ConnectBox/Circuit-Design/README.md

# Circuit-Design
Connectbox Circuit Design

This repo contains the schematic and KiCAD design files for the NEO-USB-HAT.  This is a daugherboard to add an extra USB port and power input to a NanoPi NEO.
