ConnectBox/Circuit-Design/Hat_7.0.6/Flex_1.0/Flex Spec on Stackup.pdf

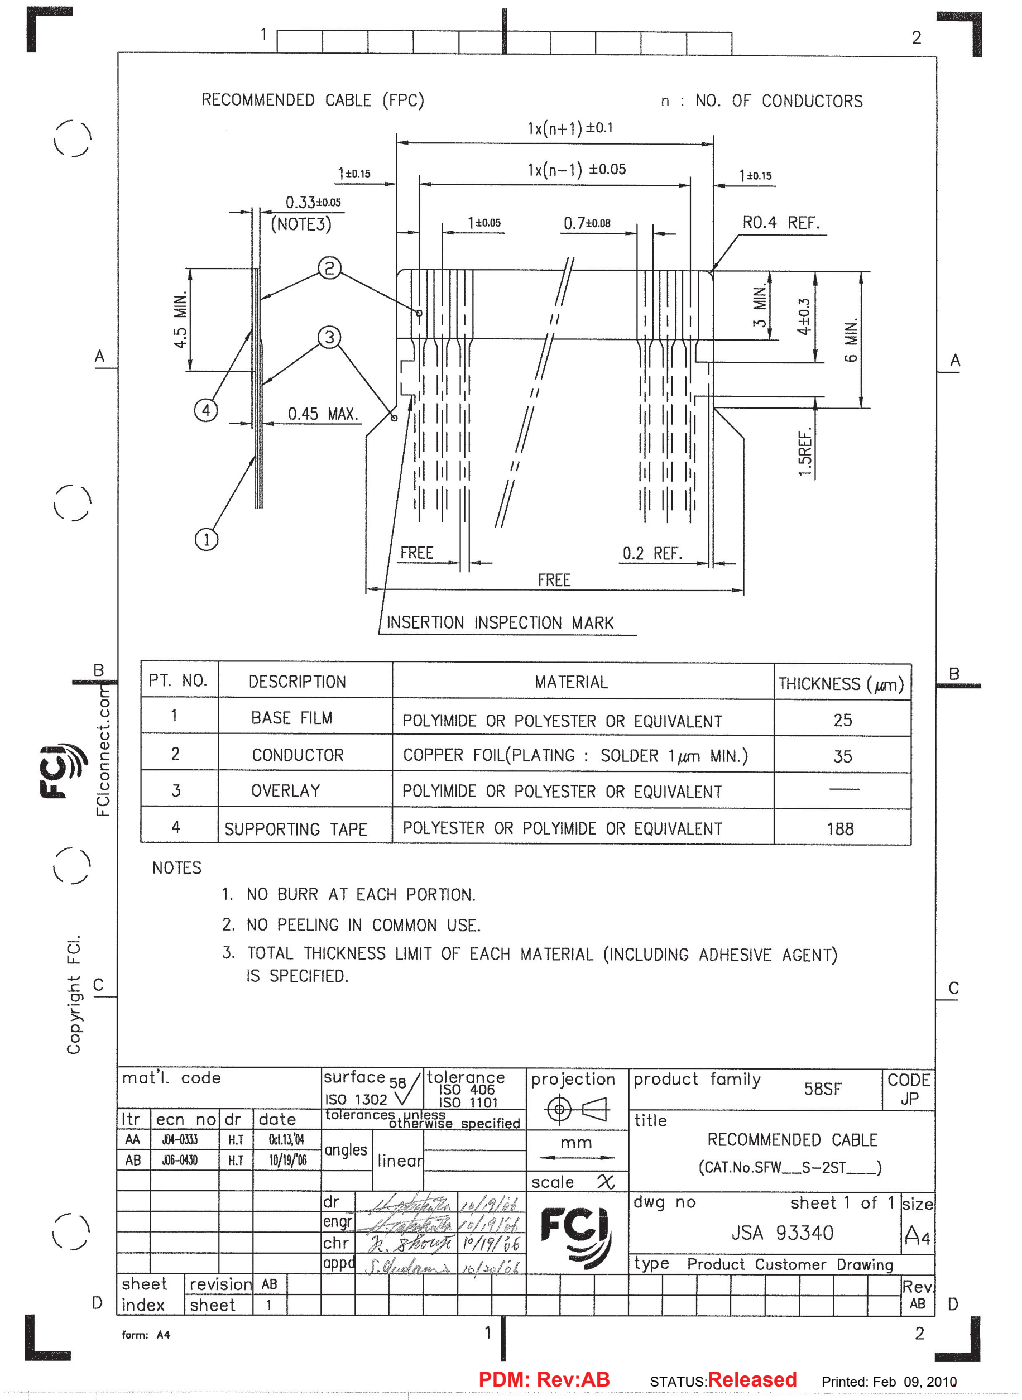
[picture p1: page 1]

PDM: Rev:AB | Released | . STATUS: | Printed: Feb 09, 2010
