ConnectBox/Circuit-Design/Hat_7.0.6/Flex_1.0/Flex Spec Drawing.pdf

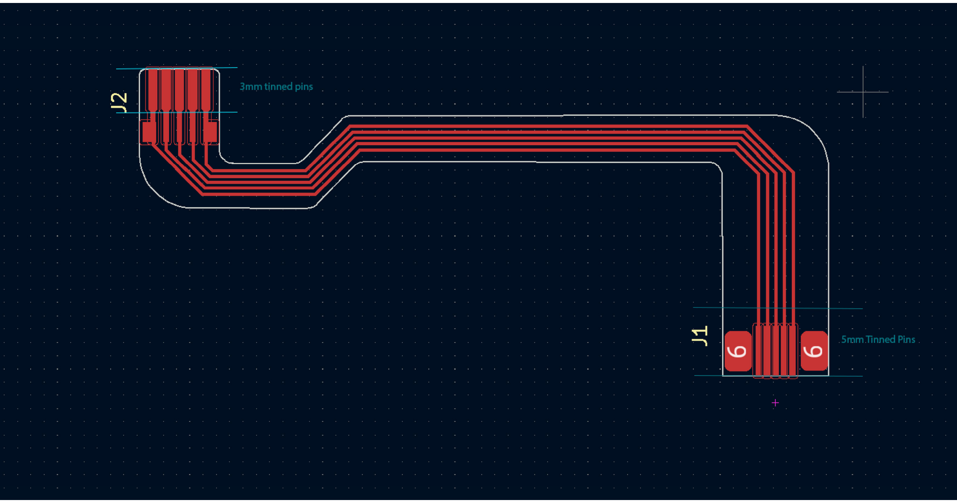
[picture p2: page 1]
