ConnectBox/Circuit-Design/Hat_7.0.6/Flex_1.1/Drawing of Layers.pdf

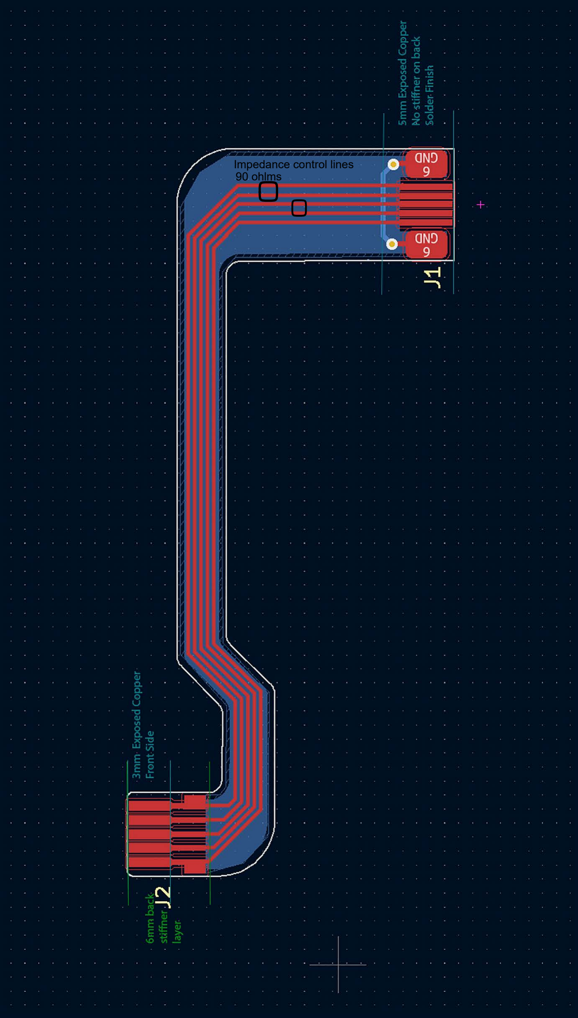
[picture p3: page 1]

Impedance control lines
90 ohlms
