ConnectBox/Circuit-Design/Hat_7.0.6/Flex_1.0/Drawing.PNG

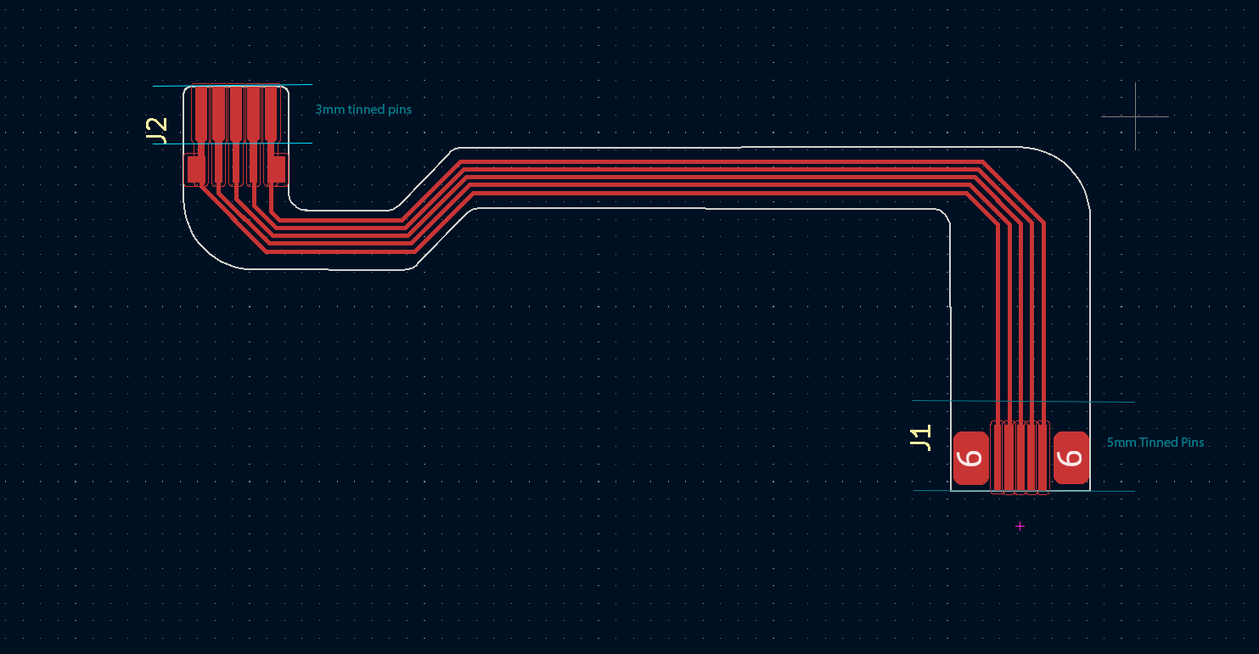
Hat_7.0.6/Flex_1.0/Drawing.PNG
