ConnectBox/Circuit-Design/Hat_7.0.6/Flex_1.1/Flex Circuit Stackup - provisional.PNG

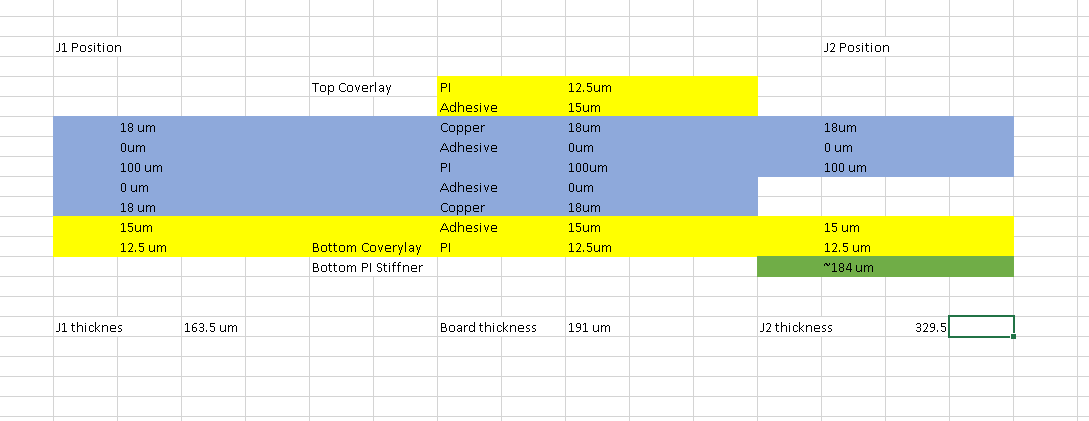
Hat_7.0.6/Flex_1.1/Flex Circuit Stackup - provisional.PNG
