ConnectBox/Circuit-Design/Hat_6.0.4/CB with HAT_ver_6.0.4_BOM.xlsx

HAT_ver_6.0.4_BOM
Reference | Quantity | Value | Footprint | Description | DigiKey P/N | Manufacturer | Manufacturer P/N | Type
BAT1 | 1 | Molex PicoBlade 53047-0210 | CustomComponents:Molex PicoBlade 53047-0210 - (swapped pins) | CONN HEADER VERT 2POS 1.25MM | WM1731-ND | Molex | 530470210 | ThroughHole
C10 C9 C6 | 3 | 1uF | Capacitor_SMD:C_0805_2012Metric | CAP CER 1UF 10V X5R 0805 | 399-8006-1-ND | KEMET | C0805C105K8PACTU | SMD
C11 C12 C13 | 3 | 4.7uF | Capacitor_SMD:C_0805_2012Metric | CAP CER 4.7UF 10V X7R 0805 | 1276-2972-1-ND | Samsung Electro-Mechanics | CL21B475KPFNNNE | SMD
C4 C16 C1 C2 C5 C3 | 6 | 10uF | Capacitor_SMD:C_0805_2012Metric | CAP CER 10UF 10V X5R 0805 | 1276-1144-1-ND | Samsung Electro-Mechanics | CL21A106MPFNNNE | SMD
C7 C8 C14 C15 C17 C18 | 6 | 22uF | Capacitor_SMD:C_0805_2012Metric | CAP CER 22UF 10V X5R 0805 | 399-12069-1-ND | KEMET | C0805C226M8PAC7800 | SMD
D1 | 1 | NRVTS260ESFT1G | CustomComponents:SOD-123FL | DIODE SCHOTTKY 60V 2A SOD123FL | NRVTS260ESFT1GOSCT-ND | ON Semiconductor | NRVTS260ESFT1G | SMD
D2 | 1 | MMBD914 | Diode_SMD:D_SOT-23_ANK | DIODE GEN PURP 100V 200MA SOT23 | MMBD914LT1GOSCT-ND | ON Semiconductor | MMBD914LT1G | SMD
L2 L1 | 2 | 4.7 uH | CustomComponents:INDUCTOR_SMD_6x6-1 | FIXED IND 4.7UH 3A 40.3 MOHM SMD | 587-2100-1-ND | Taiyo Yuden | NR6028T4R7M | SMD
LED1 | 1 | Red | LED_SMD:LED_0603_1608Metric | LED RED CLEAR 0603 SMD | 160-1447-1-ND | Lite-On Inc. | LTST-C191KRKT | SMD
LED2 | 1 | Amber | LED_SMD:LED_0603_1608Metric | LED AMBER CLEAR 0603 SMD | 160-1445-1-ND | Lite-On Inc. | LTST-C191KFKT | SMD
LED3 | 1 | Green | LED_SMD:LED_0603_1608Metric | LED GREEN CLEAR 0603 SMD | 160-1446-1-ND | Lite-On Inc. | LTST-C191KFKT | SMD
P1 | 1 | Conn_01x08 | Connector_PinHeader_2.54mm:PinHeader_1x08_P2.54mm_Vertical | CONN HDR 8POS 0.1 GOLD PCB | S7041-ND | Sullins Connector Solutions | PPPC081LFBN-RC | ThroughHole
P2 P6 | 2 | Conn_01x05 | Connector_PinHeader_2.54mm:PinHeader_1x05_P2.54mm_Vertical | CONN HDR 5POS 0.1 GOLD PCB | S7038-ND | Sullins Connector Solutions | PPPC051LFBN-RC | ThroughHole
P3 | 1 | USB_A_1 | CustomComponents:USB_A | CONN RCPT TYPEA 4POS R/A - WHITE | ED2989-ND | On Shore Technology Inc. | USB-A1HSW6 | ThroughHole
P4 | 1 | USB_OTG-1 | CustomComponents:USB_Micro-B-TH-mount | CONN RCPT USB2.0 MICRO B SMD R/A with TH mounting | 609-4618-1-ND | Amphenol ICC (FCI) | 10118194-0001LF | SMD
P7 | 1 | Conn_01x04 | Connector_PinHeader_2.54mm:PinHeader_1x04_P2.54mm_Vertical | CONN HDR 4POS 0.1 GOLD PCB | S7037-ND | Sullins Connector Solutions | PPPC041LFBN-RC | ThroughHole
PB1 PB2 | 2 | SPST-PUSH | CustomComponents:SW-TL3305 | SWITCH TACTILE SPST-NO 50MA 12V | EG5353CT-ND | E-Switch | TL3305AF260QG | SMD
R1 | 1 | 162 | Resistor_SMD:R_0805_2012Metric | RES SMD 162 OHM 1% 1/8W 0805 | 311-162CRCT-ND | Yageo | RC0805FR-07162R | SMD
R16 R17 R8 | 3 | 10K | Resistor_SMD:R_0805_2012Metric | RES SMD 10K OHM 1% 1/8W 0805 | 311-10.0KCRCT-ND | Yageo | RC0805FR-0710KL | SMD
R19 R18 R12 | 3 | 2.2K | Resistor_SMD:R_0805_2012Metric | RES SMD 2.2K OHM 1% 1/8W 0805 | 311-2.20KCRCT-ND | Yageo | RC0805FR-072K2L | SMD
R2 | 1 | 0.03 ohm | Resistor_SMD:R_0805_2012Metric | RES 0.03 OHM 1% 1/2W 0805 | P19207CT-ND | Panasonic Electronic Components | ERJ-6CWFR030V | SMD
R22 R9 R11 R10 R3 R13 | 6 | 1K | Resistor_SMD:R_0805_2012Metric | RES SMD 1K OHM 1% 1/8W 0805 | 311-1.00KCRCT-ND | Yageo | RC0805FR-071KL | SMD
R26 R20 | 2 | 200K | Resistor_SMD:R_0805_2012Metric | RES SMD 200K OHM 1% 1/8W 0805 | 311-200KCRCT-ND | Yageo | RC0805FR-07200KL | SMD
R27 | 1 | 27.0K | Resistor_SMD:R_0805_2012Metric | RES SMD 27.0K OHM 1% 1/8W 0805 | 311-27.0KCRCT-ND | Yageo | RC0805FR-0727KL | SMD
R4 | 1 | 1.8K | Resistor_SMD:R_0805_2012Metric | RES SMD 1.8K OHM 1% 1/8W 0805 | 311-1.80KCRCT-ND | Yageo | RC0805FR-071K8L | SMD
R5 | 1 | 51K | Resistor_SMD:R_0805_2012Metric | RES SMD 51K OHM 1% 1/8W 0805 | 311-51.0KCRCT-ND | Yageo | RC0805FR-071KL | SMD
R6 | 1 | 220K | Resistor_SMD:R_0805_2012Metric | RES SMD 220K OHM 1% 1/8W 0805 | 311-220KCRCT-ND | Yageo | RC0805FR-07220KL | SMD
R7 | 1 | 100 | Resistor_SMD:R_0805_2012Metric | RES SMD 100 OHM 1% 1/8W 0805 | 311-100CRCT-ND | Yageo | RC0805FR-07100RL | SMD
SW1 | 1 | SPDT-2C | CustomComponents:SPDT-OS10211 | SWITCH SLIDE SPDT 100MA 12V | CKN9559-ND or CKN9560-ND | C&K | OS102011MA1QN1 | ThroughHole
U1 | 1 | AXP209 | CustomComponents:UQFN-48-1EP_6x6mm_Pitch0.4mm_75 | Enhanced single Cell Li-Battery and Power System Management IC | http://www.kynix.com/Detail/120792/AXP209.html | X-Powers | AXP209 | SMD
U2 | 1 | MT3608 | CustomComponents:SOT-23-6a | High Efficiency 1.2MHz 2A Step Up Converter | http://www.kynix.com/Detail/584537/MT3608.html | AEROSEMI | MT3608 | SMD
U3 | 1 | MIC2019 | CustomComponents:SOT-23-6a | IC DISTRIBUTION SW ADJ SOT23-6 | 576-2595-1-ND | Microchip Technology | MIC2019YM6-TR | SMD
HAT PCB | 1 | HAT Rev 6.0.3 |  |  |  | PCBWay
 | Quoted cost for components and HAT assembly (PCBWay)
COMPONENTS TO COMPETE BUILD #1
WiFi | 1 | HC-R8812AF1 | CustomComponents:HC-R8812AU2 | HC-R8812AF1 wifi module
Case | 1 | Printed or Injection Molded, Respon Plastic Industrial | Case | Custom Injection Molded (quote Respon Plastic) DOES NOT INCLUDE TOOLING $4060
Battery | 1 | 3.7V 6400 mAH Li-Ion | TSMB International tradding company | Li-Ion 2 cell, 3200 mAH
Antenna | 2 | Dual Band 2.4G 5.8G pcb antenna 7.0 dbI | Shenzhen XinLisheng Hardware Ekectronics Co. | Strip line with coax and connector
OLED | 1 | 0.96" OLED i2C 128x64 White display | TZT Oled display | 0.96” OLED display, I2C
HeatSink | 1 | 40*5*30MM Routing Chip Radiotor Heatsink | Shenzhen Maoye Electronics Co. | 30mm x 40mm x 5mm
HeatSink Foam | 1 | Thermal Pad 6.0 W/mK 0.5mm 2mm 3mm 5mm High | Rgeek Official store - Alibaba.com | 14mm x 14mm x 1.5mm heat conductive foam block
Processor Board | 1 | NanoPi Neo 256M | Rainbow Fame Limited | NanoPi Neo - LTS
uSD Card | 1 | 64GB Full capacity TF Sd Memory Card | Shenzhen Yi You Ma Trade Co | 64GB
HAT Assembly | 1 | PCBWay 2 layer 1.6 mm HASL finish board with components | PCBWay | PCBWay Quote (includes assembly, board, all components except WiFi)
Total Build #1 of 220
Build #2 of 250
Hat Assembly with WIFI
Other Parts
Total build #2 of 250
Connect Box | 1 | Uline 7x3 5/8 x 2 1/8" white literaturee mailers | Uline | Uline Business Card Box
Bubble Bag | 1 | Uline 8 1/2" x 6" bubble bag | Uline | Uline 8 1/2 x 6"
Power Module | 1 | USB Charger 2A US or EU | Shenzhen BHD Technology Co. Ltd | Alibaba USB Fast Charger US or EU
USB A to micro USB Cable | 1 | High Speed USB2.0 Male to Micro USB Syc Cable | Shenzhen Kuncan Electronic Co. Ltd. | Alibaba USB2 Nylon braided
Index Card Internal | 1 | 8-1/2x11 laser/inkjet Postcards 4 up per page | Amazon 4-1/4"x5 1/2" | Amazon 4 up postcard
Label for Box | 1 | Maco Laser/InkJet Whit Shipping label 3-1/3 xx 4" 6 per sheet | Amazon | Amazon MACO Laser/Ink Jet 3 1/3 x 4
Total Accessories
