ConnectBox/Circuit-Design/Hat_6.0/CB_ver_6.0.1_BOM.xlsx

HAT_ver_5.1.1_BOM
Reference | Quantity | Value | Footprint | Description | DigiKey P/N | Manufacturer | Manufacturer P/N | Type | DK Cost @100 | Cost x qty | Cost AliExpress (or other)
BAT1 | 1 | Molex PicoBlade 53047-0210 | CustomComponents:Molex PicoBlade 53047-0210 - (swapped pins) | CONN HEADER VERT 2POS 1.25MM | WM1731-ND | Molex | 530470210 | ThroughHole | $0.123 | $0.123
C10 C9 C6 | 3 | 1uF | Capacitor_SMD:C_0805_2012Metric | CAP CER 1UF 10V X5R 0805 | 399-8006-1-ND | KEMET | C0805C105K8PACTU | SMD | $0.078 | $0.234
C11 C12 C13 | 3 | 4.7uF | Capacitor_SMD:C_0805_2012Metric | CAP CER 4.7UF 10V X7R 0805 | 1276-2972-1-ND | Samsung Electro-Mechanics | CL21B475KPFNNNE | SMD | $0.103 | $0.309
C4 C16 C1 C2 C5 C3 | 6 | 10uF | Capacitor_SMD:C_0805_2012Metric | CAP CER 10UF 10V X5R 0805 | 1276-1144-1-ND | Samsung Electro-Mechanics | CL21A106MPFNNNE | SMD | $0.062 | $0.372
C7 C8 C14 C15 C17 | 5 | 22uF | Capacitor_SMD:C_0805_2012Metric | CAP CER 22UF 10V X5R 0805 | 399-12069-1-ND | KEMET | C0805C226M8PAC7800 | SMD | $0.218 | $1.090
D1 | 1 | NRVTS260ESFT1G | CustomComponents:SOD-123FL | DIODE SCHOTTKY 60V 2A SOD123FL | NRVTS260ESFT1GOSCT-ND | ON Semiconductor | NRVTS260ESFT1G | SMD | $0.148 | $0.148
D2 | 1 | MMBD914 | Diode_SMD:D_SOT-23_ANK | DIODE GEN PURP 100V 200MA SOT23 | MMBD914LT1GOSCT-ND | ON Semiconductor | MMBD914LT1G | SMD | $0.052 | $0.052
L2 L1 | 2 | 4.7 uH | CustomComponents:INDUCTOR_SMD_6x6-1 | FIXED IND 4.7UH 3A 40.3 MOHM SMD | 587-2100-1-ND | Taiyo Yuden | NR6028T4R7M | SMD | $0.218 | $0.436
LED1 | 1 | Red | LED_SMD:LED_0603_1608Metric | LED RED CLEAR 0603 SMD | 160-1447-1-ND | Lite-On Inc. | LTST-C191KRKT | SMD | $0.095 | $0.095
LED2 | 1 | Amber | LED_SMD:LED_0603_1608Metric | LED AMBER CLEAR 0603 SMD | 160-1445-1-ND | Lite-On Inc. | LTST-C191KFKT | SMD | $0.089 | $0.089
LED3 | 1 | Green | LED_SMD:LED_0603_1608Metric | LED GREEN CLEAR 0603 SMD | 160-1446-1-ND | Lite-On Inc. | LTST-C191KFKT | SMD | $0.095 | $0.095
P1 | 1 | Conn_01x08 | Connector_PinHeader_2.54mm:PinHeader_1x08_P2.54mm_Vertical | CONN HDR 8POS 0.1 GOLD PCB | S7041-ND | Sullins Connector Solutions | PPPC081LFBN-RC | ThroughHole | $0.484 | $0.484
P2 P6 | 2 | Conn_01x05 | Connector_PinHeader_2.54mm:PinHeader_1x05_P2.54mm_Vertical | CONN HDR 5POS 0.1 GOLD PCB | S7038-ND | Sullins Connector Solutions | PPPC051LFBN-RC | ThroughHole | $0.352 | $0.704
P3 | 1 | USB_A_1 | CustomComponents:USB_A | CONN RCPT TYPEA 4POS R/A - WHITE | ED2989-ND | On Shore Technology Inc. | USB-A1HSW6 | ThroughHole | $0.345 | $0.345
P4 | 1 | USB_OTG-1 | CustomComponents:USB_Micro-B-TH-mount | CONN RCPT USB2.0 MICRO B SMD R/A | 609-4618-1-ND | Amphenol ICC (FCI) | 10118194-0001LF | SMD | $0.310 | $0.310
P7 | 1 | Conn_01x04 | Connector_PinHeader_2.54mm:PinHeader_1x04_P2.54mm_Vertical | CONN HDR 4POS 0.1 GOLD PCB | S7037-ND | Sullins Connector Solutions | PPPC041LFBN-RC | ThroughHole | $0.335 | $0.335
PB1 PB2 | 2 | SPST-PUSH | CustomComponents:SW-TL3305 | SWITCH TACTILE SPST-NO 50MA 12V | EG5353CT-ND | E-Switch | TL3305AF260QG | SMD | $0.191 | $0.382
R1 | 1 | 162 | Resistor_SMD:R_0805_2012Metric | RES SMD 162 OHM 1% 1/8W 0805 | 311-162CRCT-ND | Yageo | RC0805FR-07162R | SMD | $0.016 | $0.016
R16 R17 R8 | 3 | 10K | Resistor_SMD:R_0805_2012Metric | RES SMD 10K OHM 1% 1/8W 0805 | 311-10.0KCRCT-ND | Yageo | RC0805FR-0710KL | SMD | $0.015 | $0.045
R19 R18 R12 | 3 | 2.2K | Resistor_SMD:R_0805_2012Metric | RES SMD 2.2K OHM 1% 1/8W 0805 | 311-2.20KCRCT-ND | Yageo | RC0805FR-072K2L | SMD | $0.016 | $0.048
R2 | 1 | 0.03 ohm | Resistor_SMD:R_0805_2012Metric | RES 0.03 OHM 1% 1/2W 0805 | P19207CT-ND | Panasonic Electronic Components | ERJ-6CWFR030V | SMD | $0.233 | $0.233
R22 R9 R11 R10 R3 R30 R13 | 7 | 1K | Resistor_SMD:R_0805_2012Metric | RES SMD 1K OHM 1% 1/8W 0805 | 311-1.00KCRCT-ND | Yageo | RC0805FR-071KL | SMD | $0.015 | $0.105
R26 R20 | 2 | 200K | Resistor_SMD:R_0805_2012Metric | RES SMD 200K OHM 1% 1/8W 0805 | 311-200KCRCT-ND | Yageo | RC0805FR-07200KL | SMD | $0.016 | $0.032
R27 | 1 | 27.0K | Resistor_SMD:R_0805_2012Metric | RES SMD 27.0K OHM 1% 1/8W 0805 | 311-27.0KCRCT-ND | Yageo | RC0805FR-0727KL | SMD | $0.016 | $0.016
R32 R36 R35 | 3 | 0 | Resistor_SMD:R_0805_2012Metric | JUMPER SMD 0 OHM 1/8W 0805 | RMCF0805ZT0R00CT-ND | Stackpole | RMCF0805ZT0R00 | SMD | $0.009 | $0.027
R4 | 1 | 1.8K | Resistor_SMD:R_0805_2012Metric | RES SMD 1.8K OHM 1% 1/8W 0805 | 311-1.80KCRCT-ND | Yageo | RC0805FR-071K8L | SMD | $0.016 | $0.016
R5 | 1 | 51K | Resistor_SMD:R_0805_2012Metric | RES SMD 51K OHM 1% 1/8W 0805 | 311-51.0KCRCT-ND | Yageo | RC0805FR-071KL | SMD | $0.016 | $0.016
R6 | 1 | 220K | Resistor_SMD:R_0805_2012Metric | RES SMD 220K OHM 1% 1/8W 0805 | 311-220KCRCT-ND | Yageo | RC0805FR-07220KL | SMD | $0.016 | $0.016
R7 R34 R33 R31 | 4 | 100 | Resistor_SMD:R_0805_2012Metric | RES SMD 100 OHM 1% 1/8W 0805 | 311-100CRCT-ND | Yageo | RC0805FR-07100RL | SMD | $0.016 | $0.064
SW1 | 1 | SPDT-2C | CustomComponents:SPDT-OS10211 | SWITCH SLIDE SPDT 100MA 12V | CKN9559-ND or CKN9560-ND | C&K | OS102011MA1QN1 | ThroughHole | $0.313 | $0.313
U1 | 1 | AXP209 | CustomComponents:UQFN-48-1EP_6x6mm_Pitch0.4mm_75 | Enhanced single Cell Li-Battery and Power System Management IC | http://www.kynix.com/Detail/120792/AXP209.html | X-Powers | AXP209 | SMD |  | $0.000 | $0.320
U2 | 1 | MT3608 | CustomComponents:SOT-23-6a | High Efficiency 1.2MHz 2A Step Up Converter | http://www.kynix.com/Detail/584537/MT3608.html | AEROSEMI | MT3608 | SMD |  | $0.000 | $0.080
U3 | 1 | MIC2019 | CustomComponents:SOT-23-6a | IC DISTRIBUTION SW ADJ SOT23-6 | 576-2595-1-ND | Microchip Technology | MIC2019YM6-TR | SMD | $0.280 | $0.280
U4 OR U5 | 1 | HC-R8812AF1 or F12ASUM13-W2 | CustomComponents:HC-R8812AU2 or CustomComponents:F12ASUM13-W2 |  |  |  |  |  |  |  | $10.000
HAT PCB | 1 | HAT Rev 5.1.1 |  |  |  | PCBWay |  |  |  |  | $1.000
PCB assembly |  |  |  |  |  |  |  |  |  |  | $10.000
 |  | Note: includes HAT components for BOTH battery and non-battery options |  |  |  |  |  | HAT Totals (DK + Other): |  |  | $28.230
ADDITIONAL CB Components
Battery | 1 | Lithium |  |  |  |  |  |  |  |  | $5.000
Antenna | 2 | Strip Antenna w/ coax |  |  |  |  |  |  |  |  | $0.500
NanoPi NEO | 1 | NanoPi Neo SBC |  |  |  |  |  |  |  |  | $12.000
OLED | 1 | OLED Display 0.96” |  | OLED 0.96" BLUE 128x64 I2C (pin order GND, VCC, SCL, SDA) |  |  |  |  |  |  | $1.850
HeatSink | 1 | Heat Sink |  | Finned Aluminum Heatsink - 40mm x 30mm x 5mm |  |  |  |  |  |  | $0.350
Thermal Pad | 1 | Heat sink pad |  | Thermal pad 6.0 W/mK - 14mm x 14mm x1.5mm thick |  |  |  |  |  |  | $0.040
Micro SD card | 1 | Micro SD |  | Micro SD memory card - Class 10 - 16 GB or greater |  |  |  |  |  |  | $6.000
Case | 1 | Case |  | Custom CB case |  |  |  |  |  | (See note 1) | $1.500
 |  |  |  |  |  |  |  | ADDITIONAL Totals: |  |  | $27.240
 |  |  |  |  |  |  |  | CB Total (HAT + ADDITIONAL): |  |  | $55.470
NOTES:
 |  | Note 1: | Injection molded. Component cost does NOT include injection mold tooling of approximately $4000
 |  |  | If 3d printed: estimate of $16.25 based on mat’l & machine time.
 |  | Note 2: | Items highlighted in light green are estimates. They should be close… but still, estimates. Of particular note it the cost of the case (see note 1 for justification).
