ConnectBox/Circuit-Design/Hat_5.1/HAT_5.1.0_Schematic.pdf

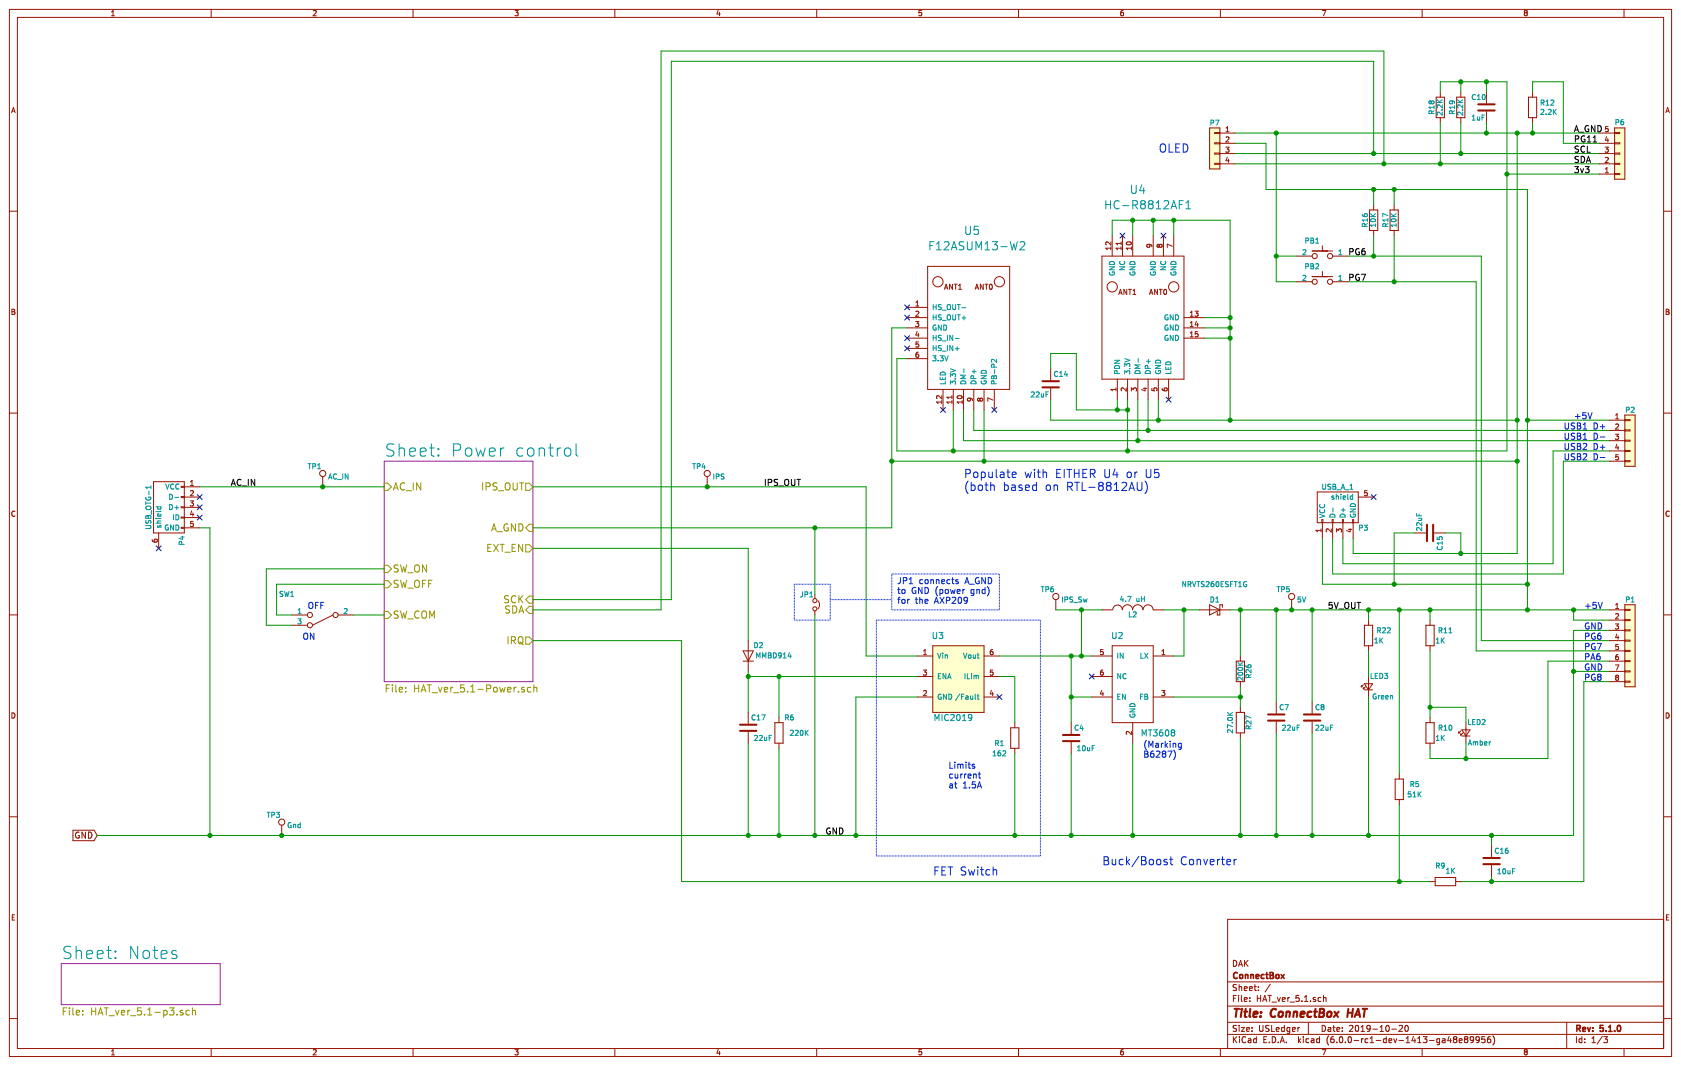
[picture p6: page 1]

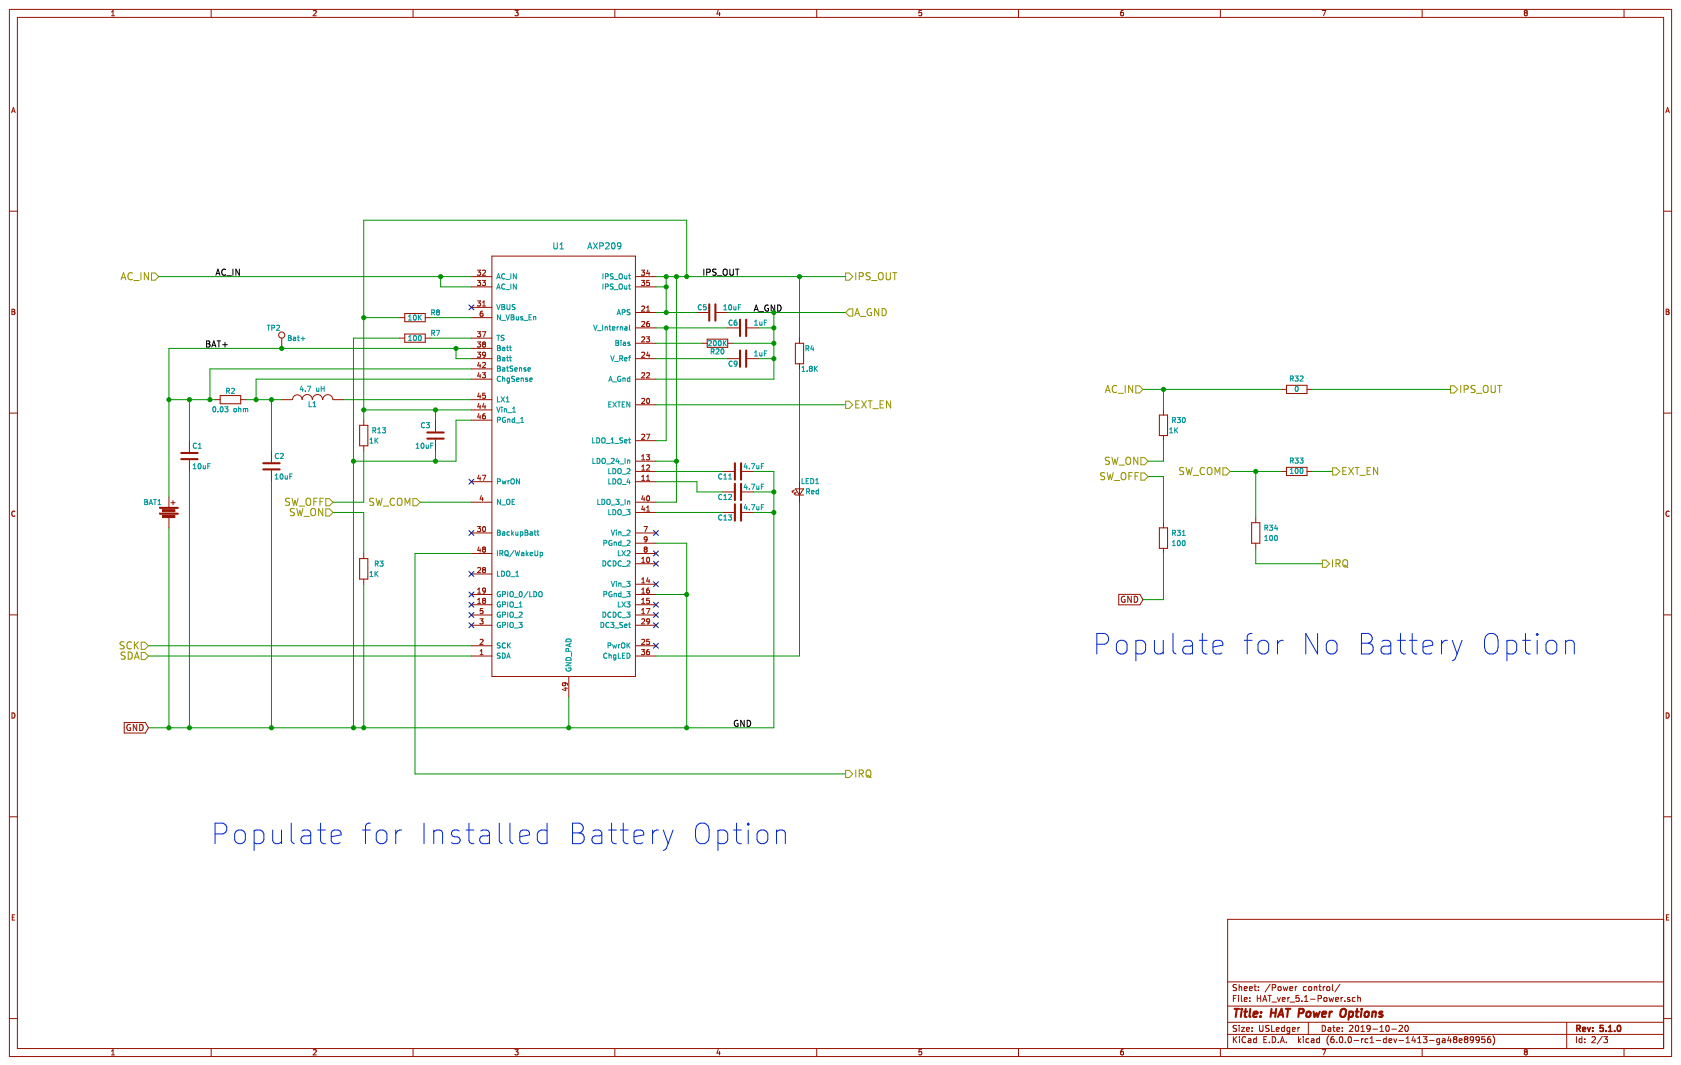
[picture p7: page 2]

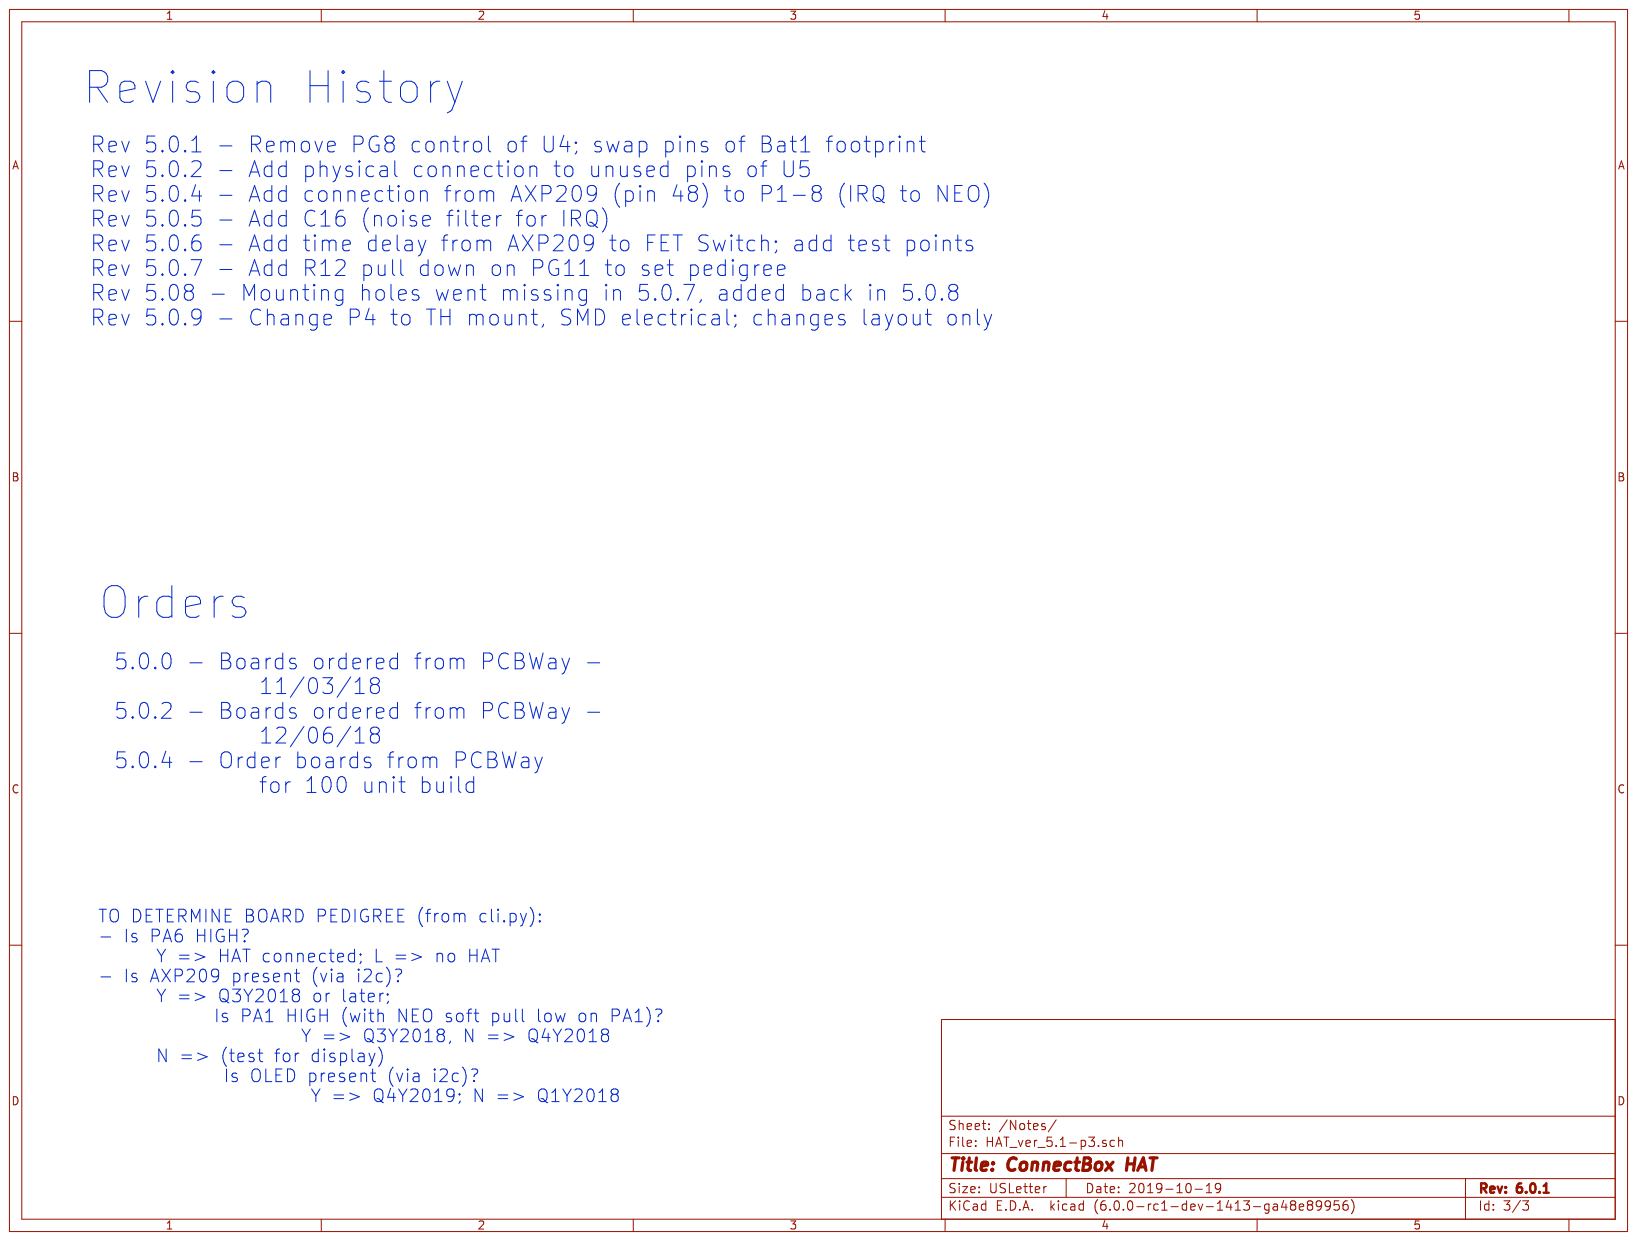
[picture p8: page 3]
