ConnectBox/Circuit-Design/Hat_5.1/HAT_5.1.1_Schematic.pdf

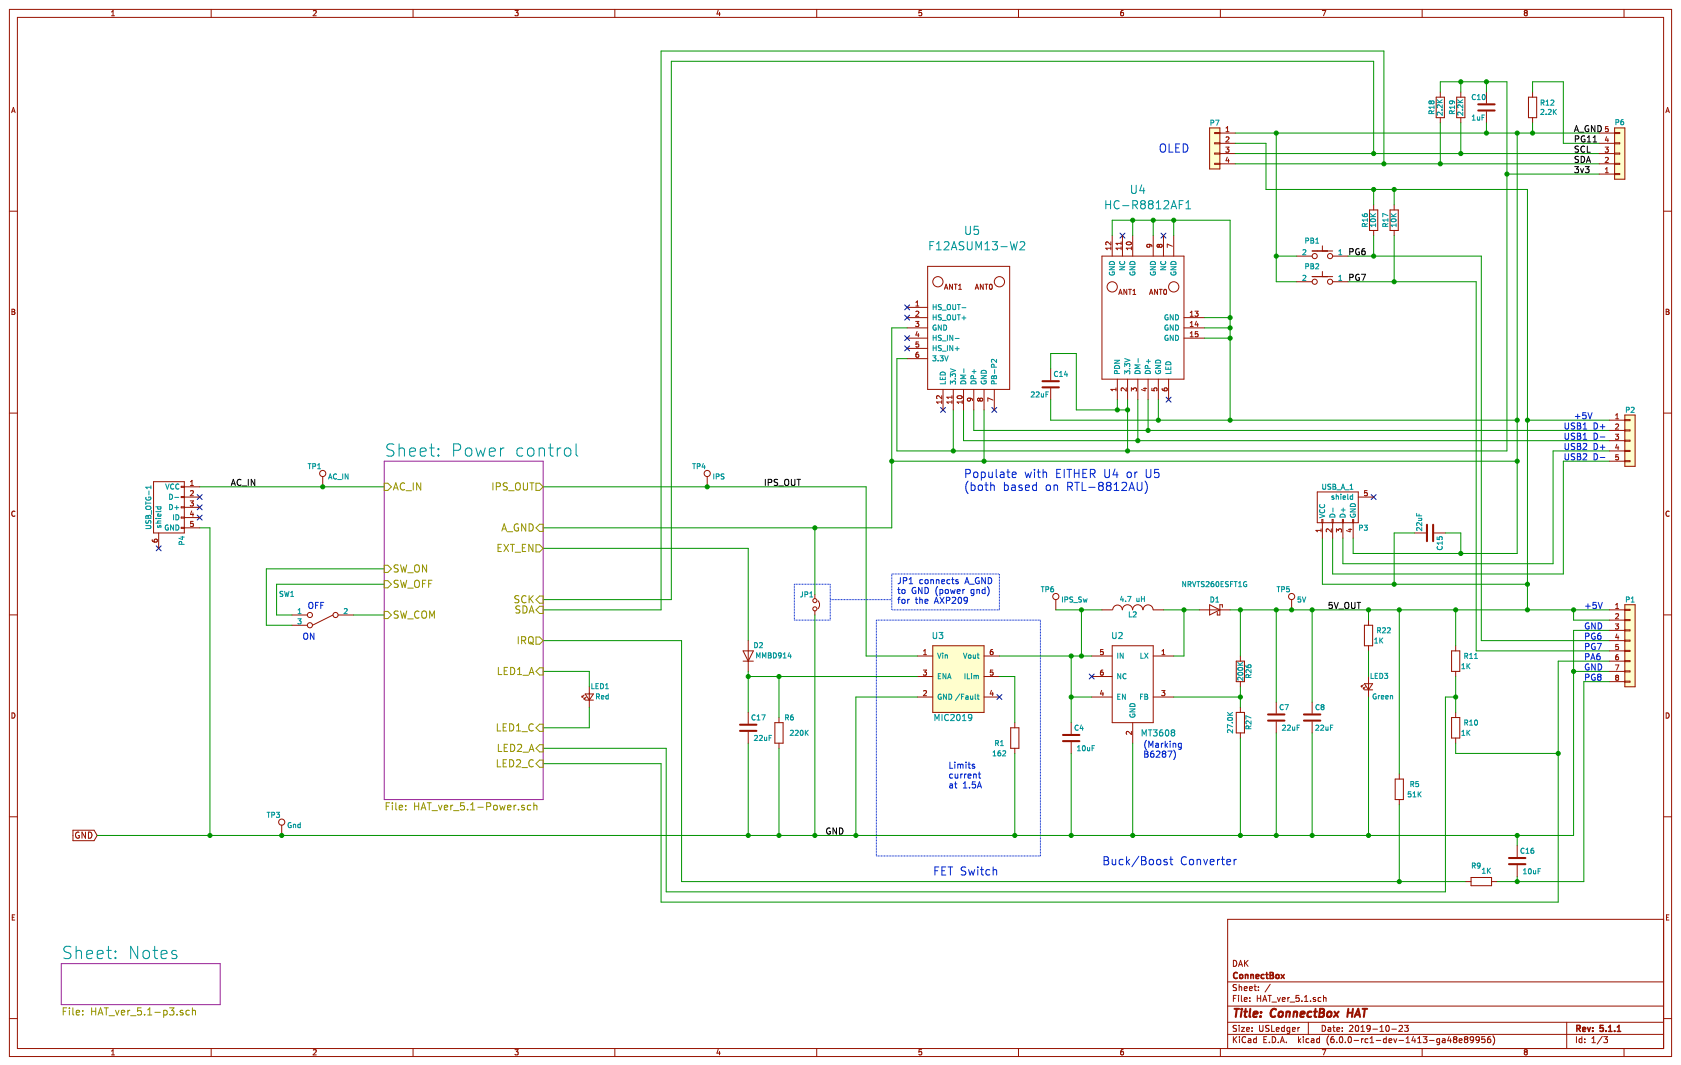
[picture p9: page 1]

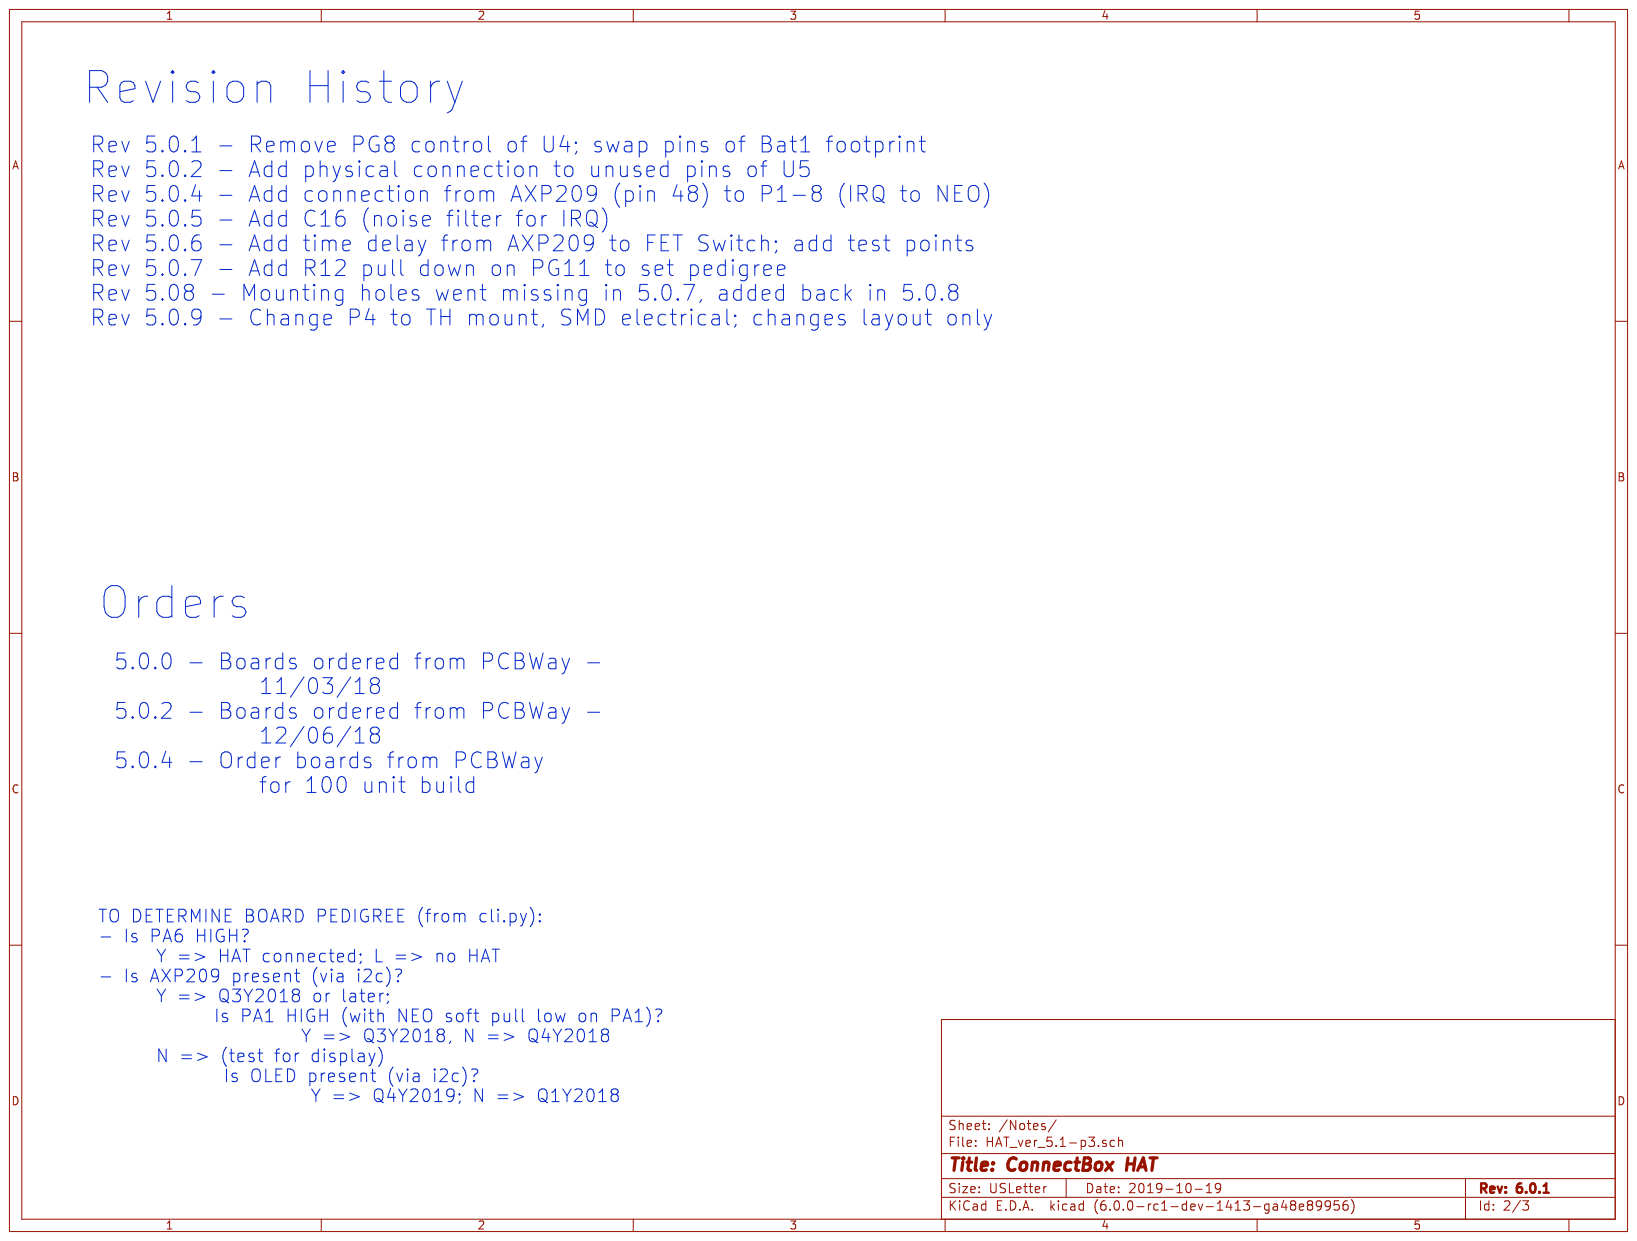
[picture p10: page 2]

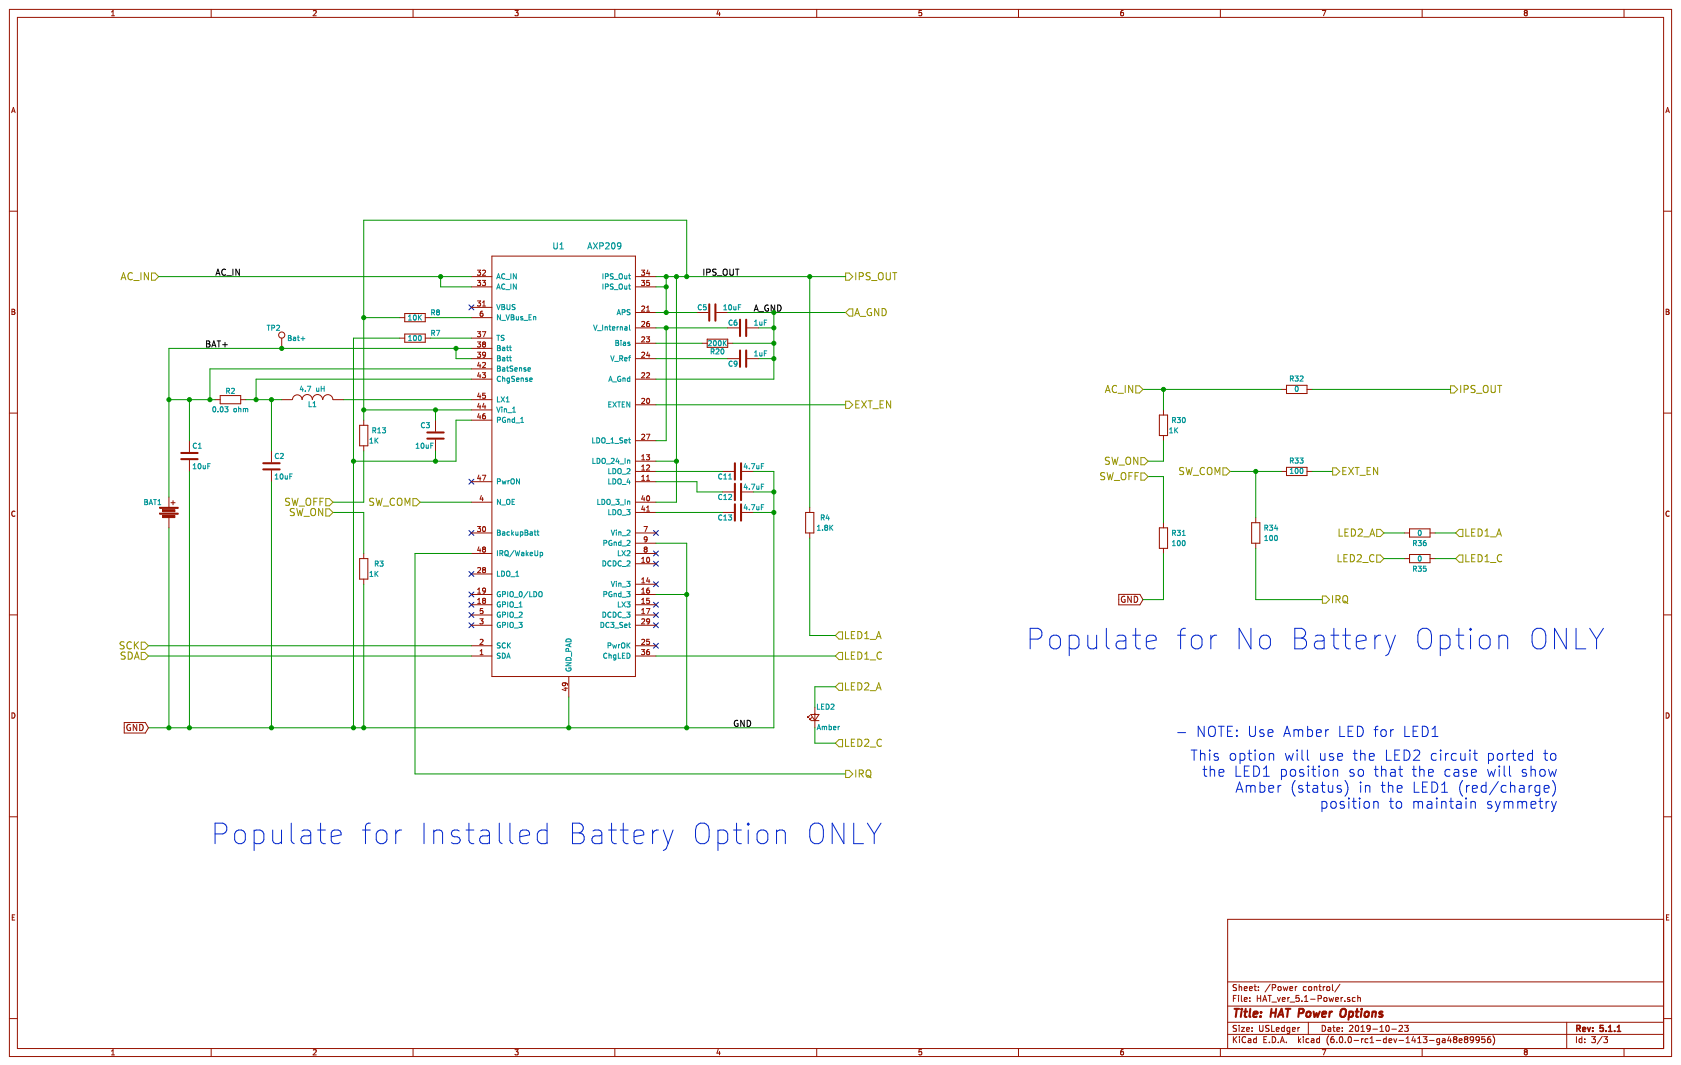
[picture p11: page 3]
