ConnectBox/Circuit-Design/Hat_4.7/Schematic_HAT_4.7.2.pdf

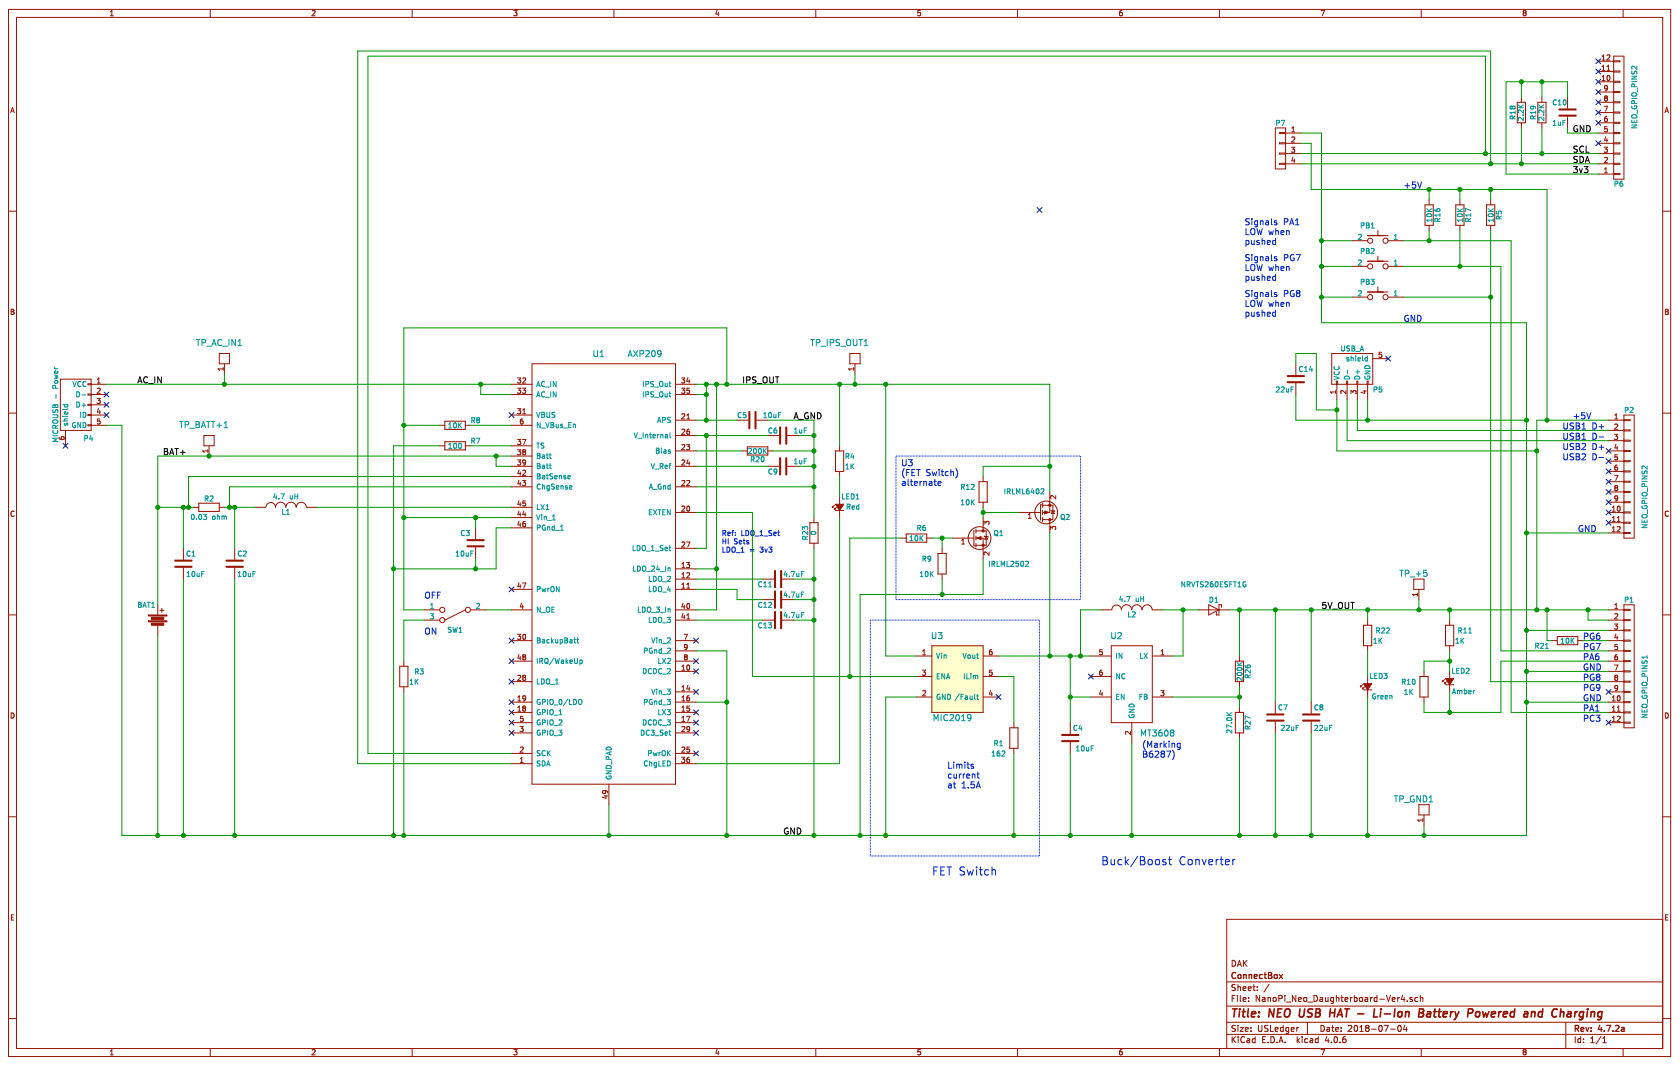
[picture p12: page 1]
