ConnectBox/Circuit-Design/Hat  2.0/HAT_CM4_183_041022-V2.1/Component_pdfs/dr-MAG-S811-1X1T-06-F.pdf

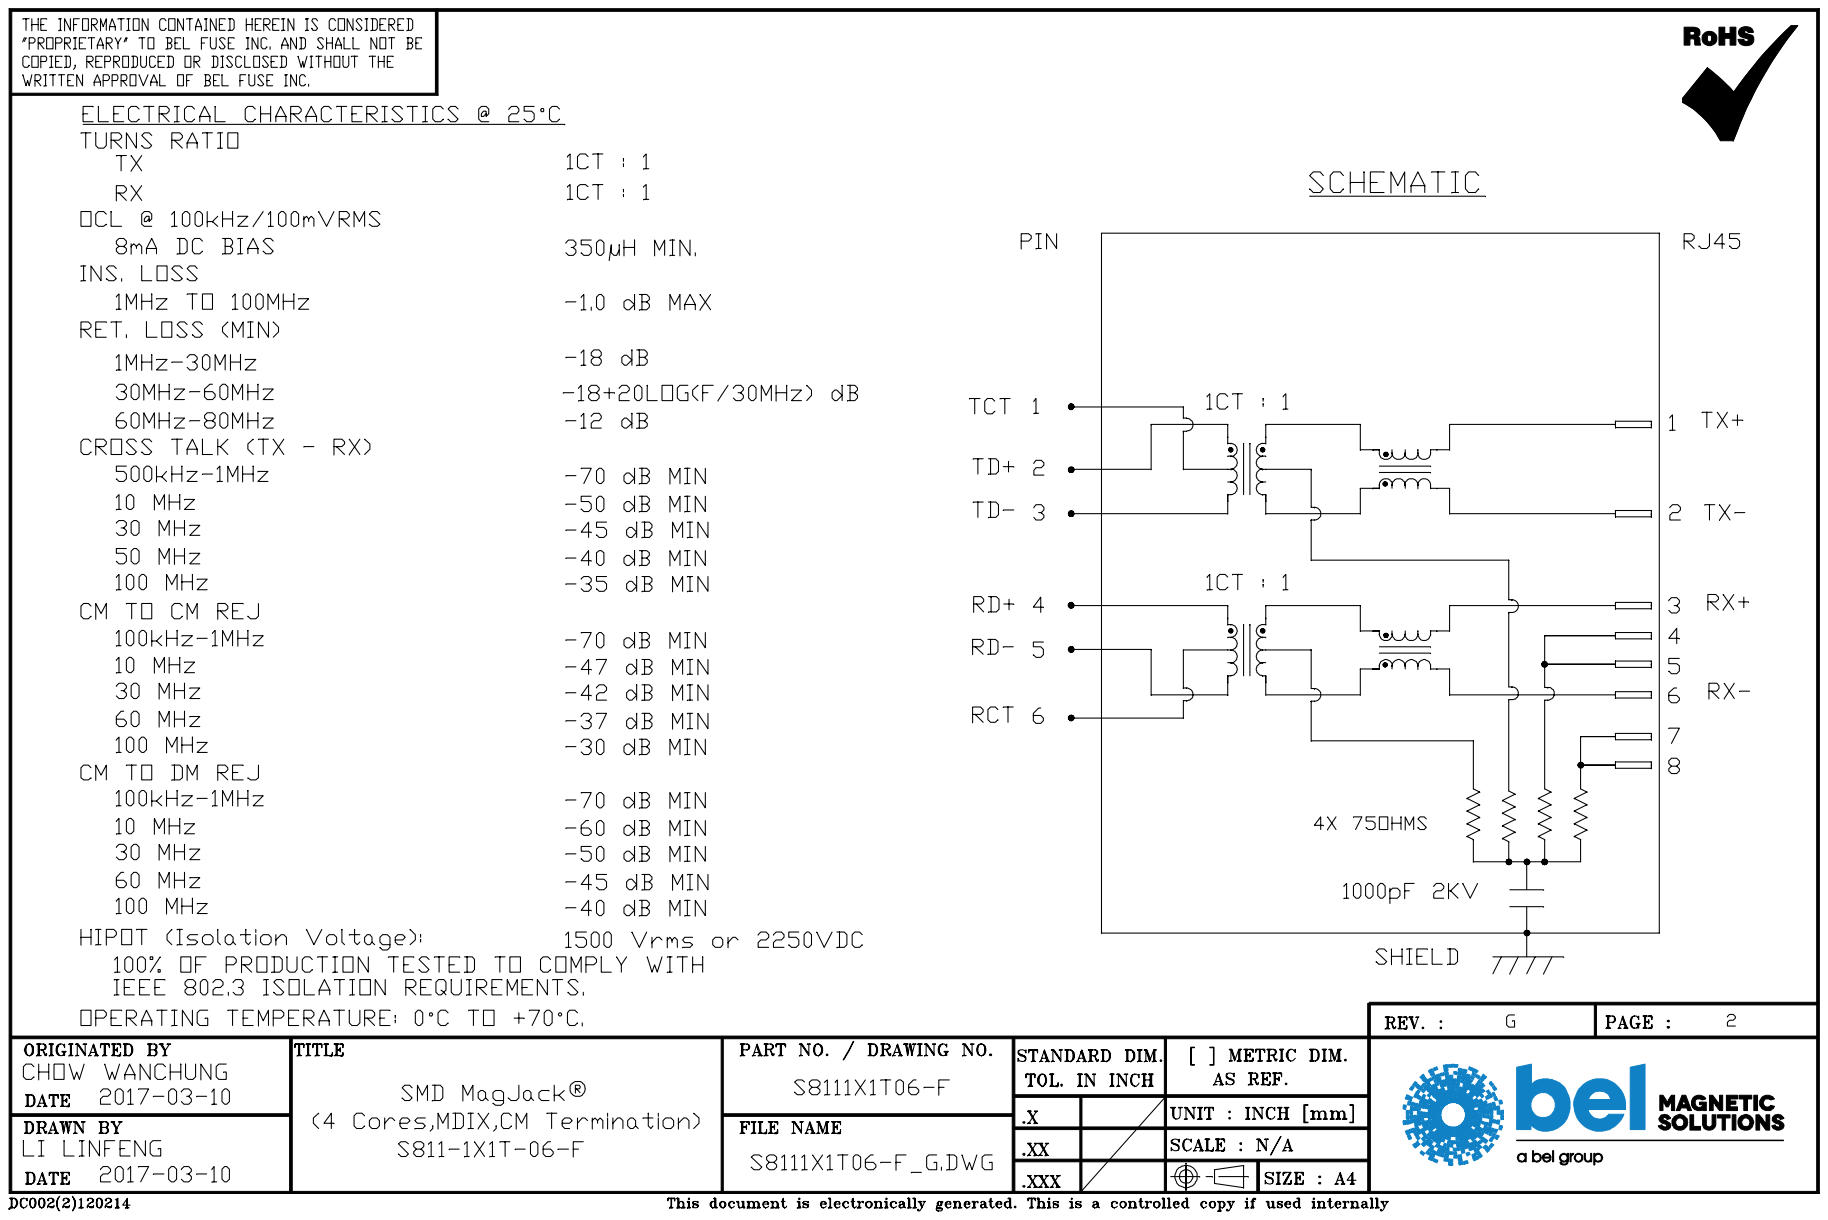
[picture p13: page 1]

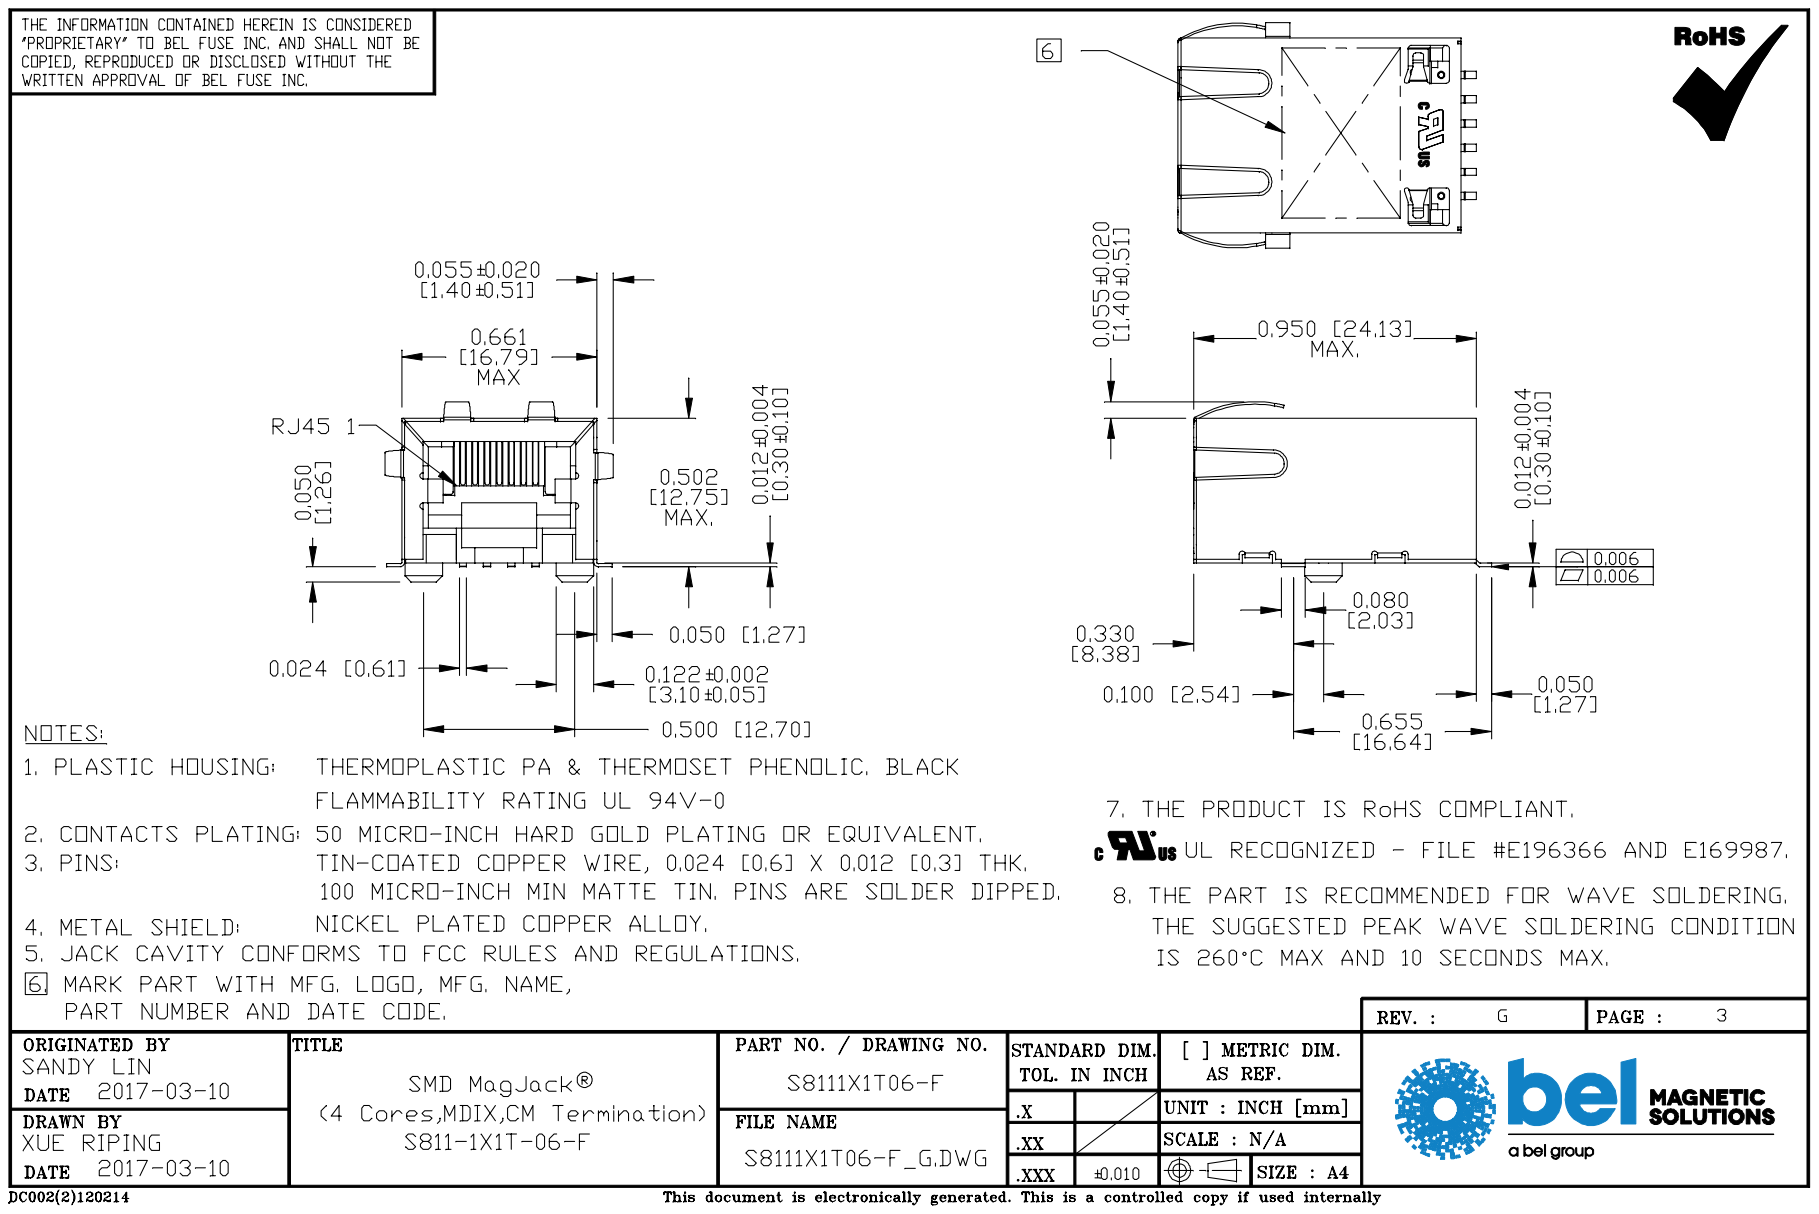
[picture p14: page 2]

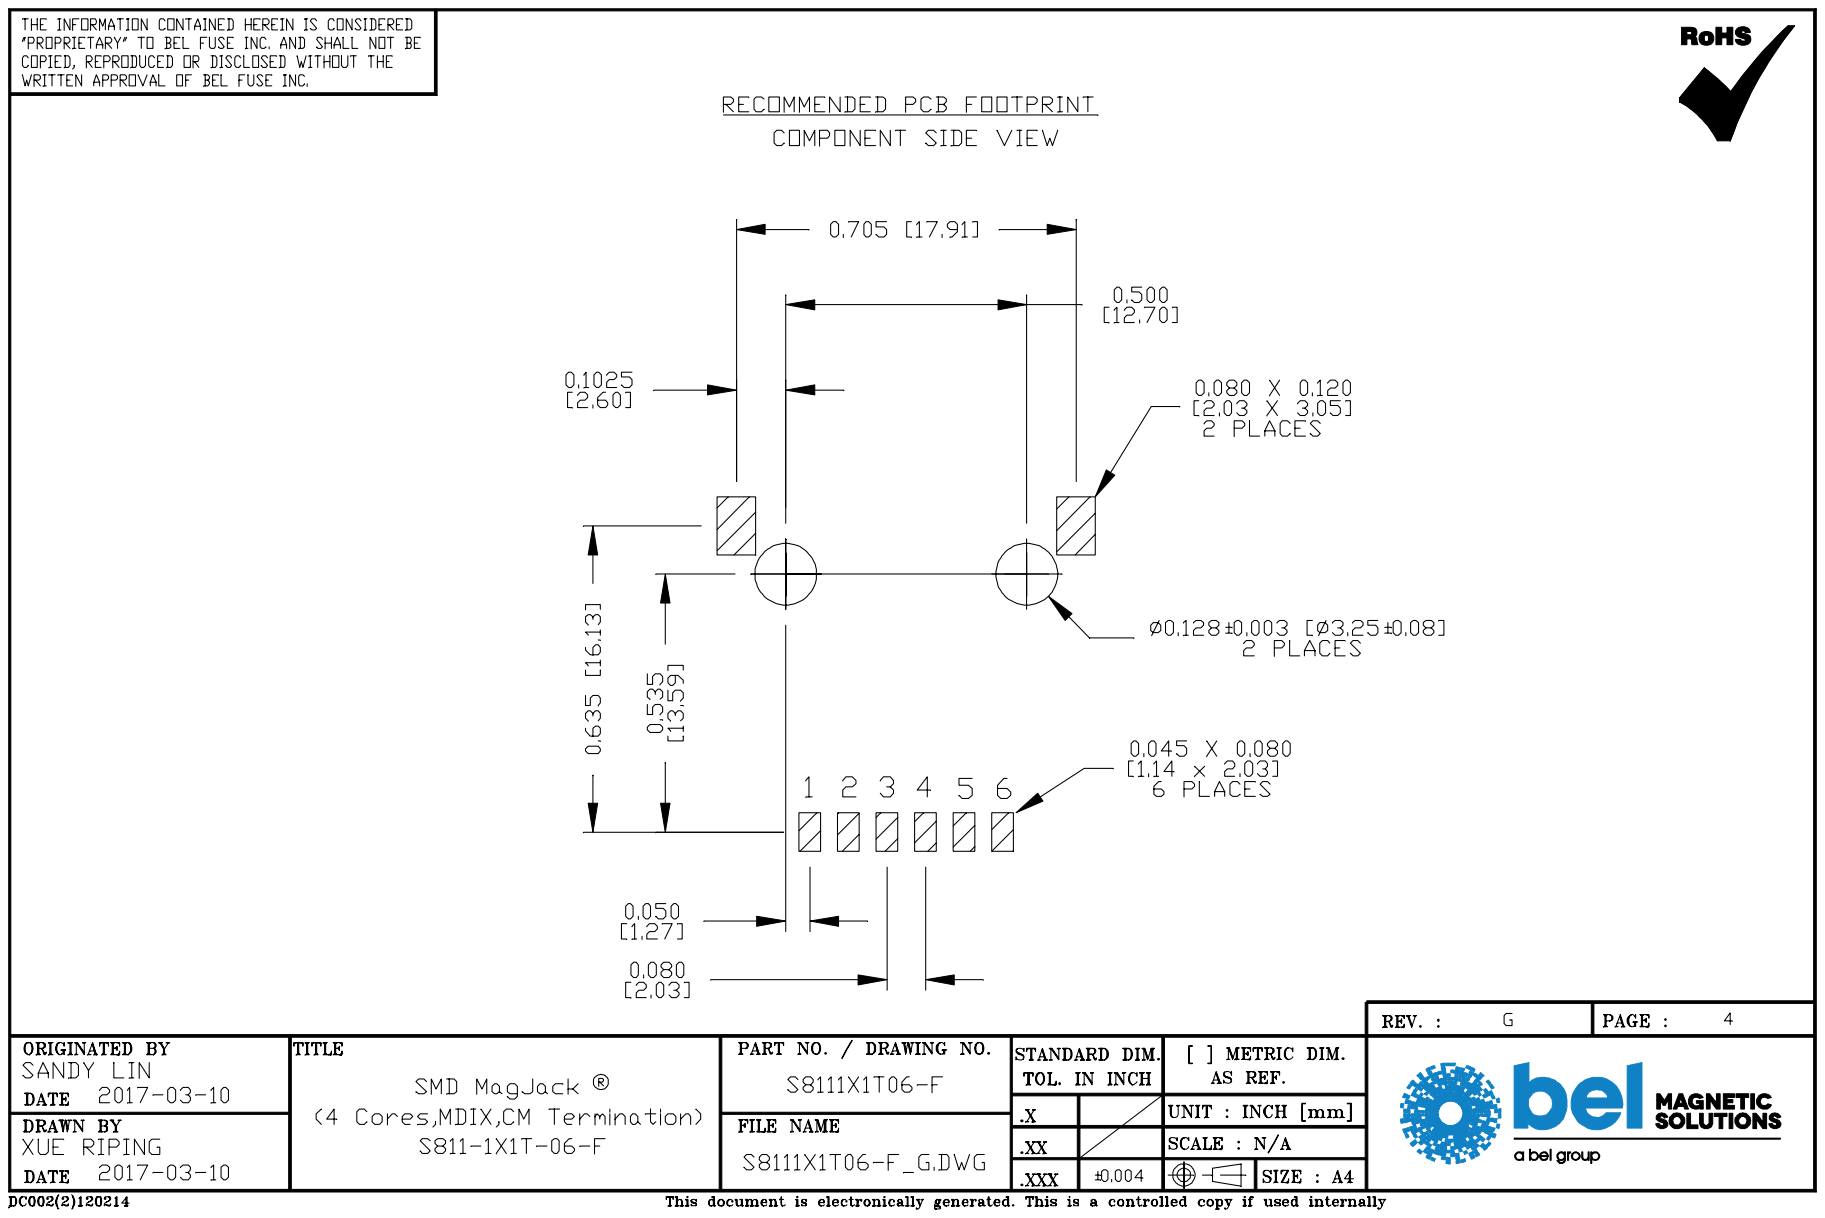
[picture p15: page 3]

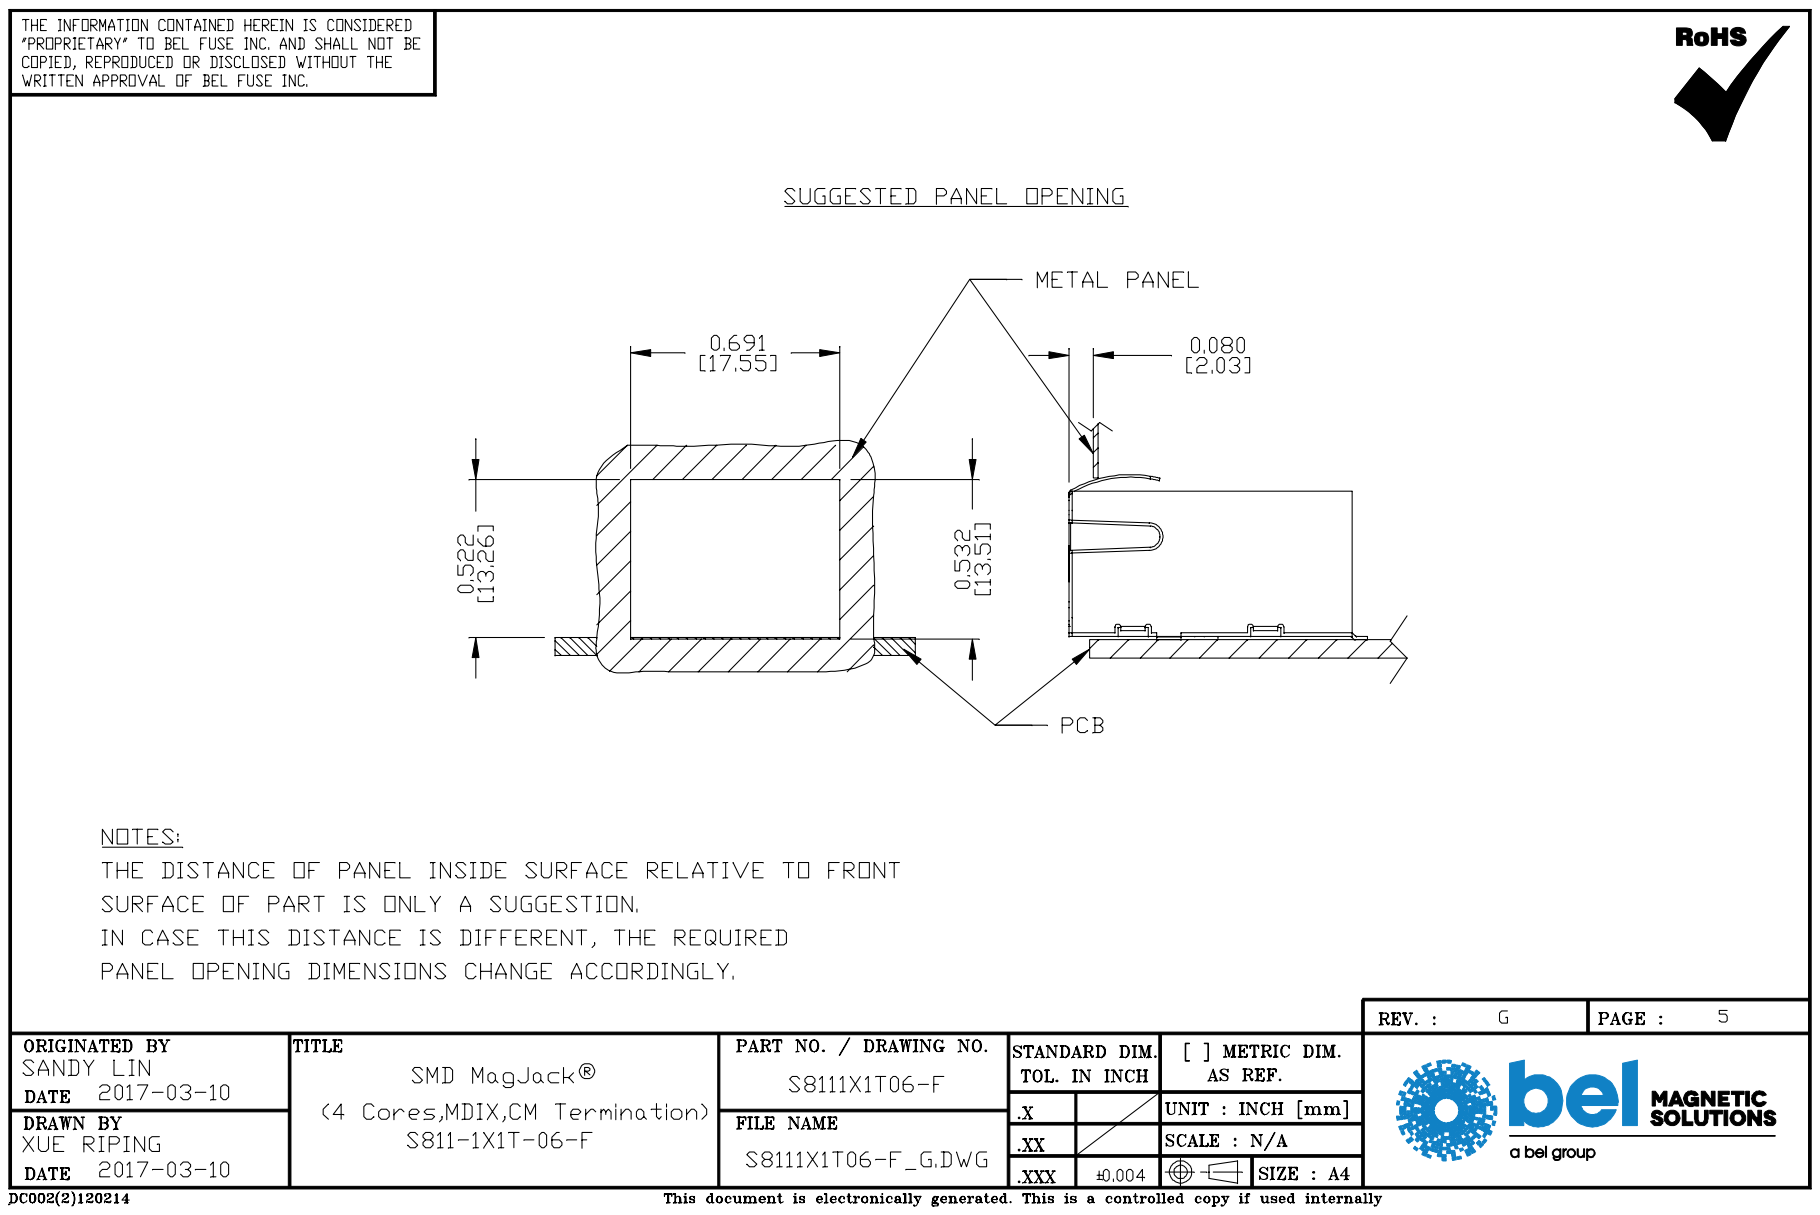
[picture p16: page 4]

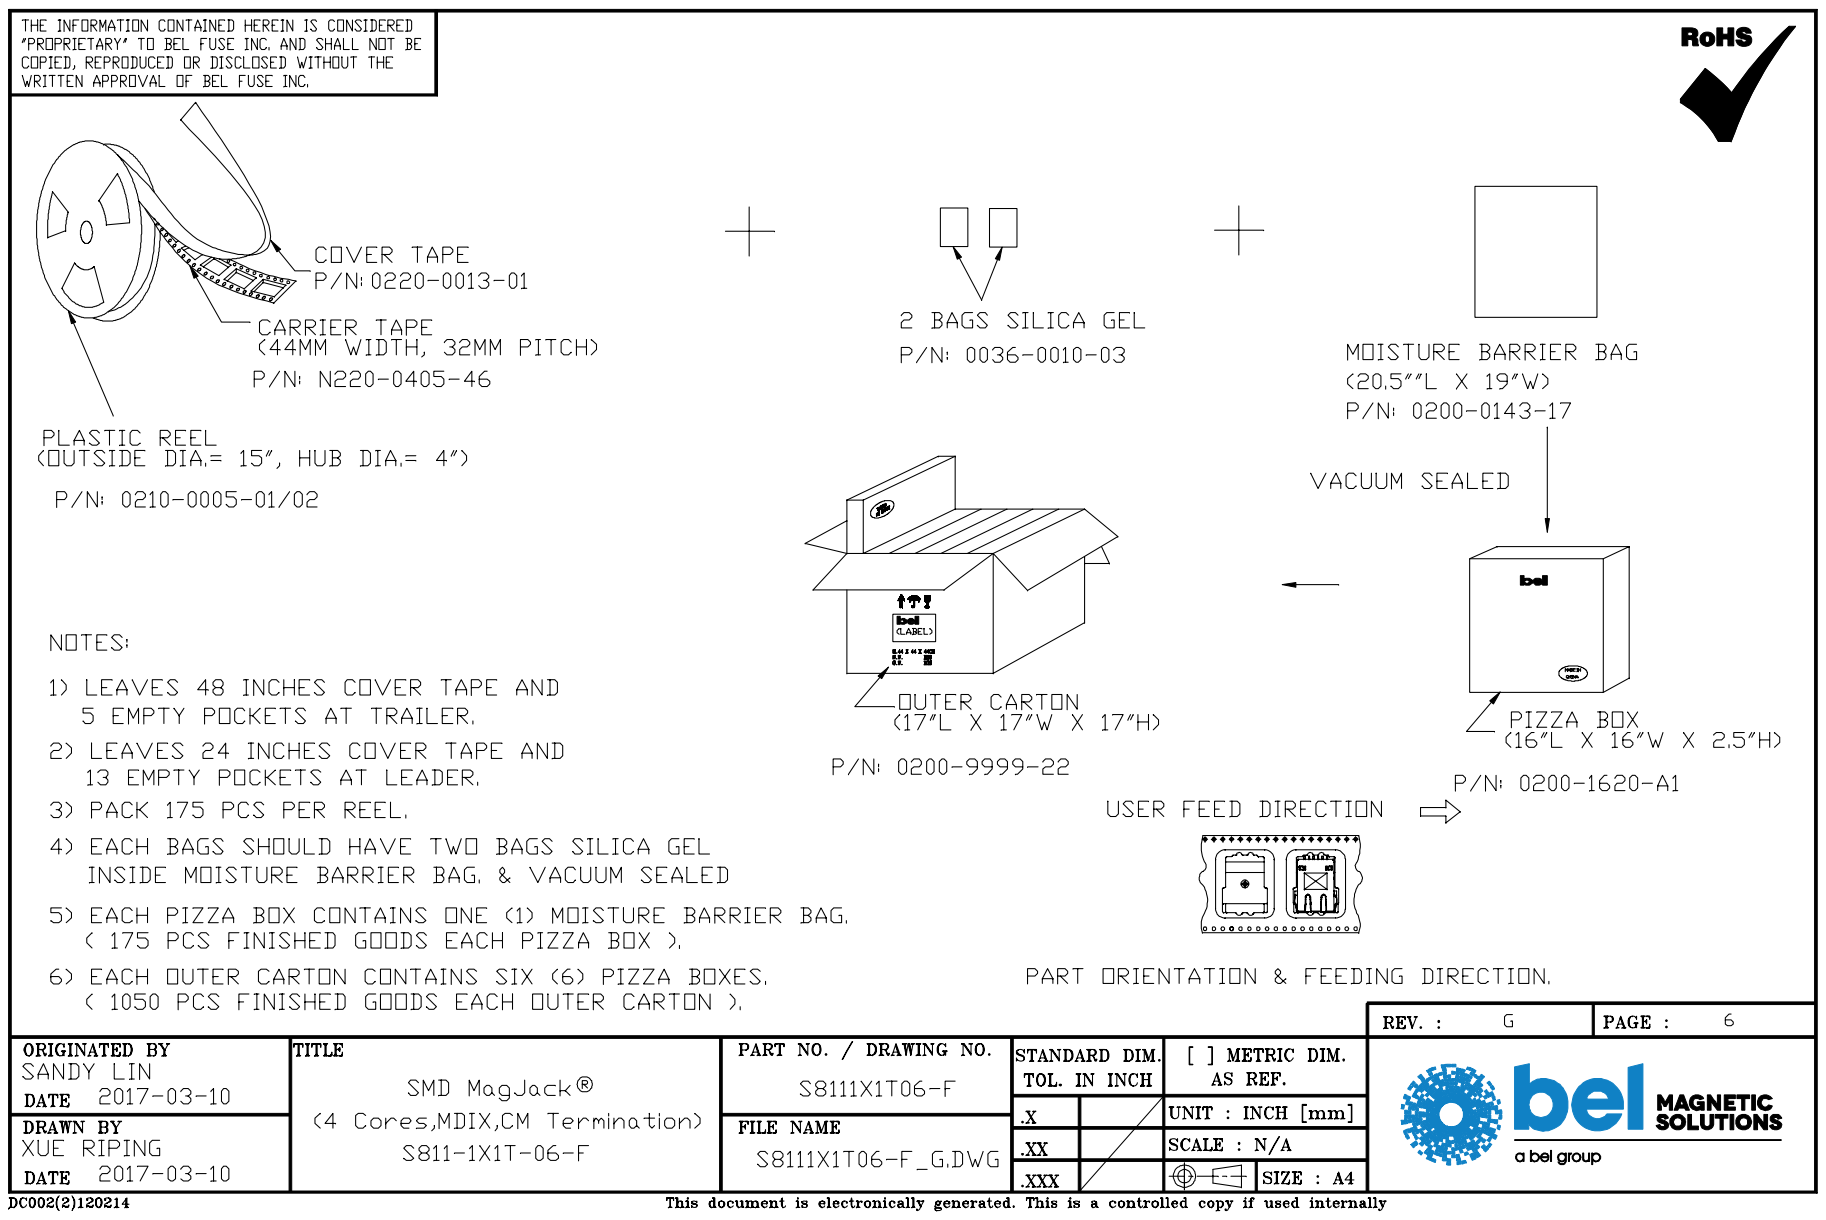
[picture p17: page 5]

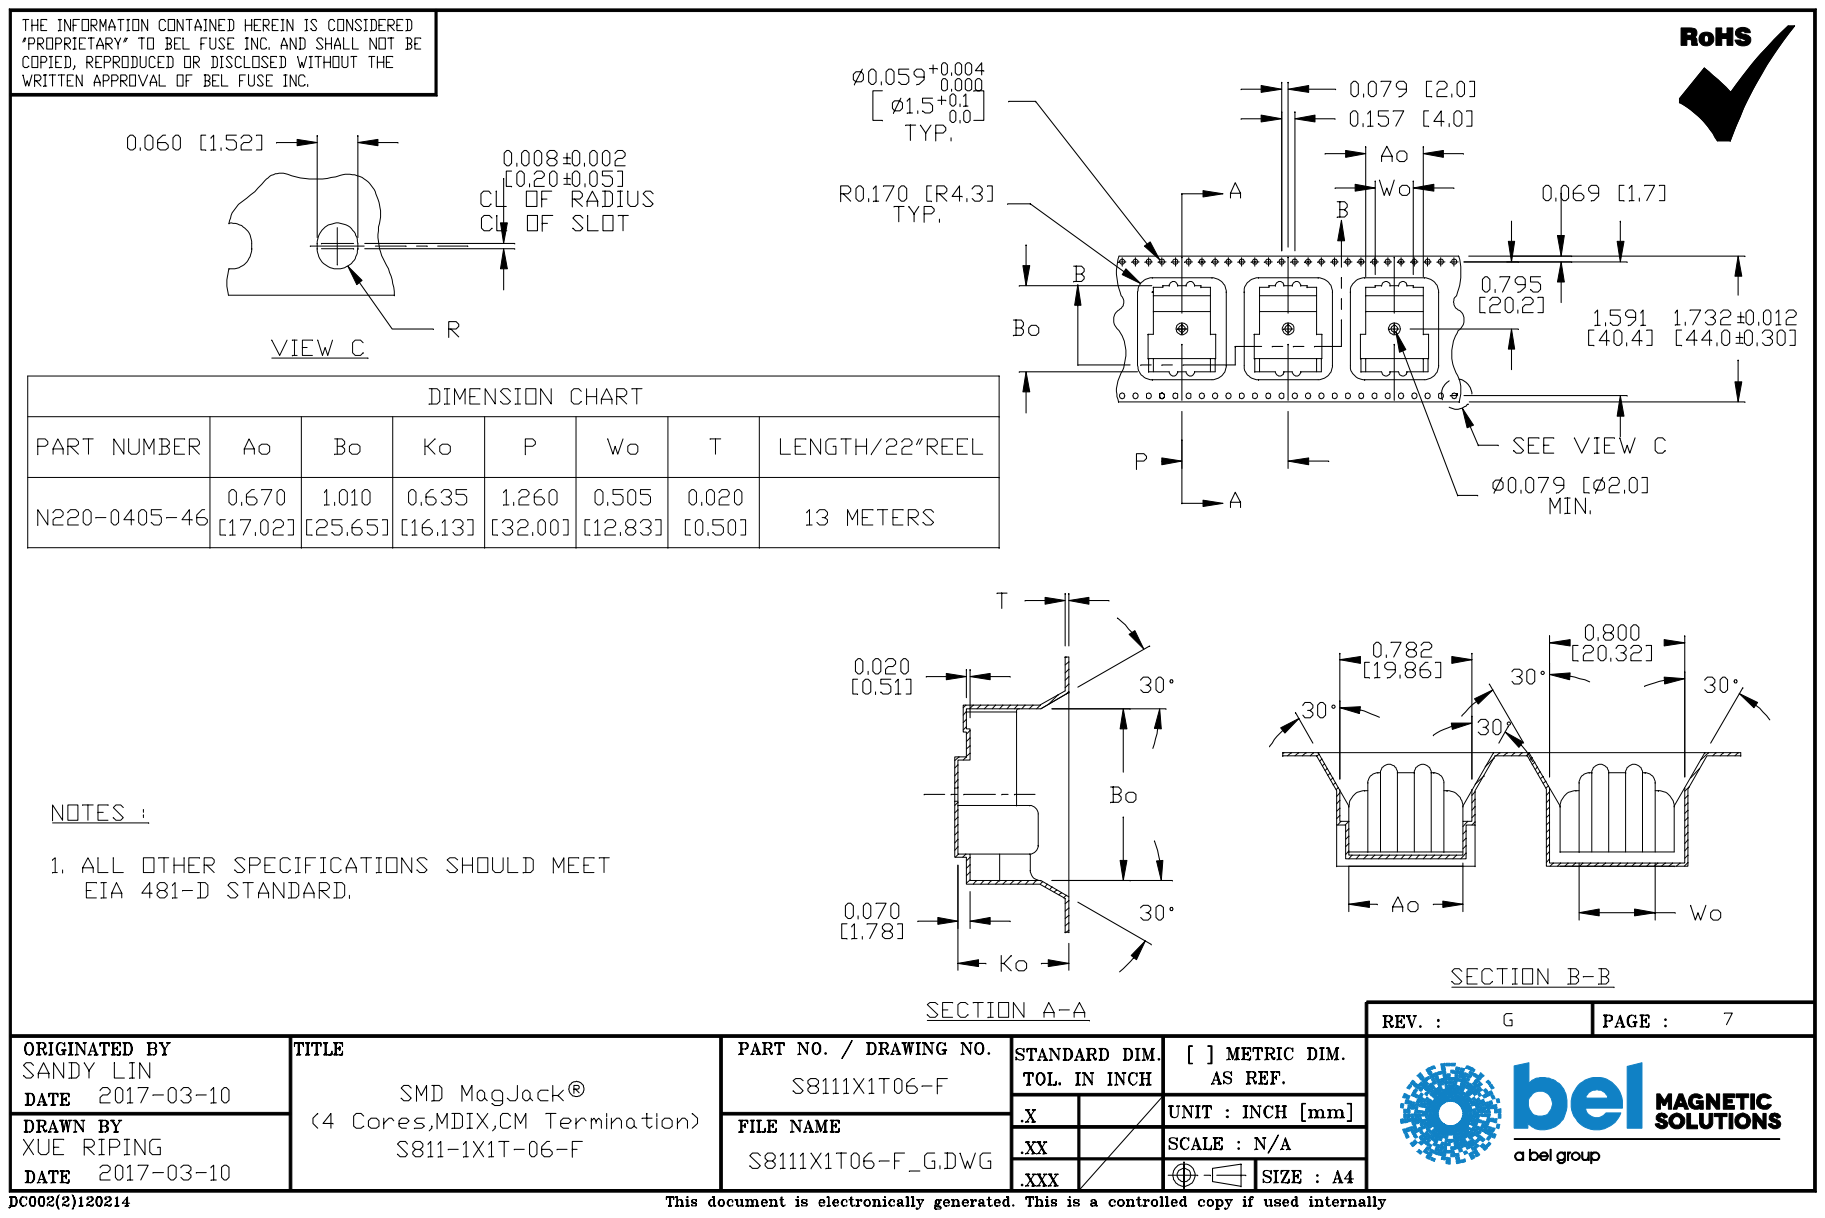
[picture p18: page 6]

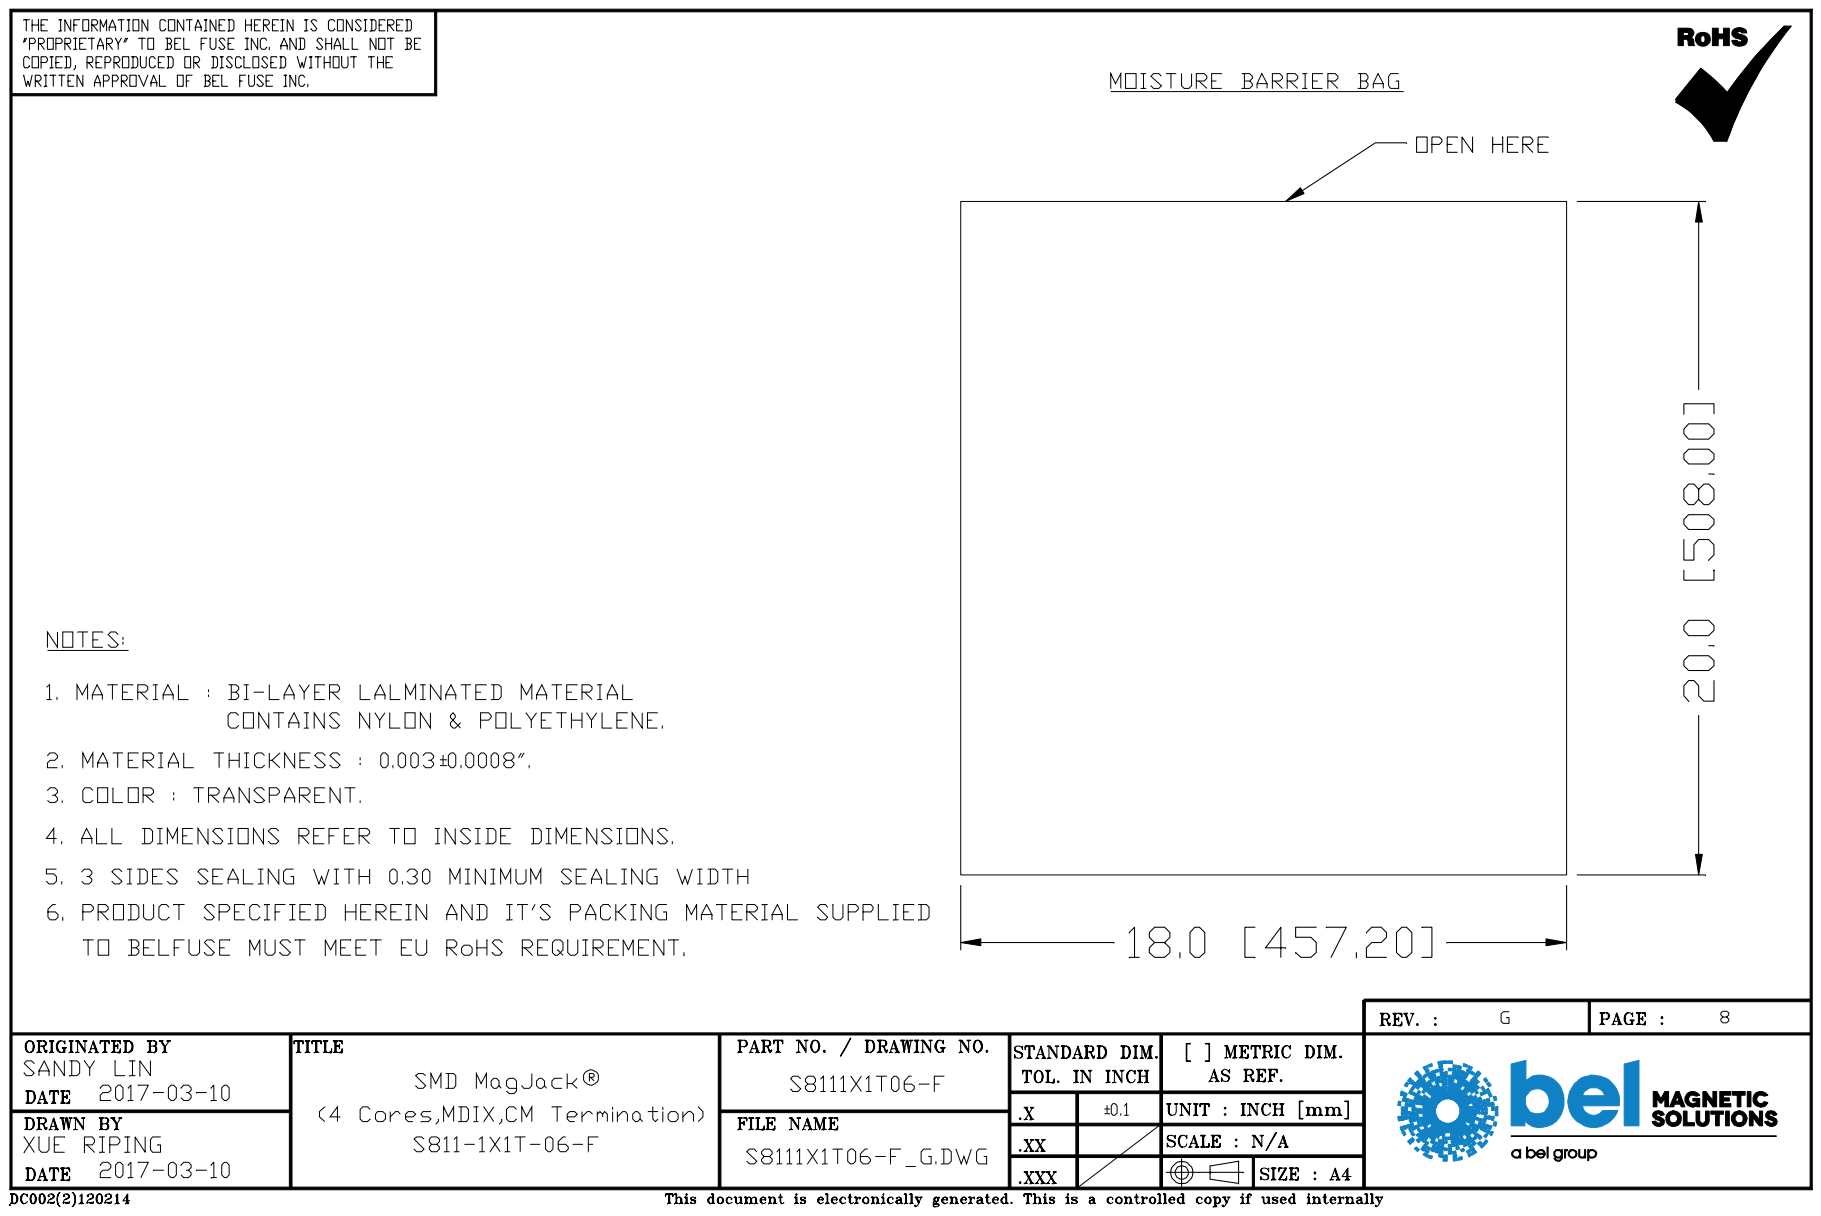
[picture p19: page 7]
