ConnectBox/Circuit-Design/Hat 8.0/HATA_ver_8_041323/HoleLocations.pdf

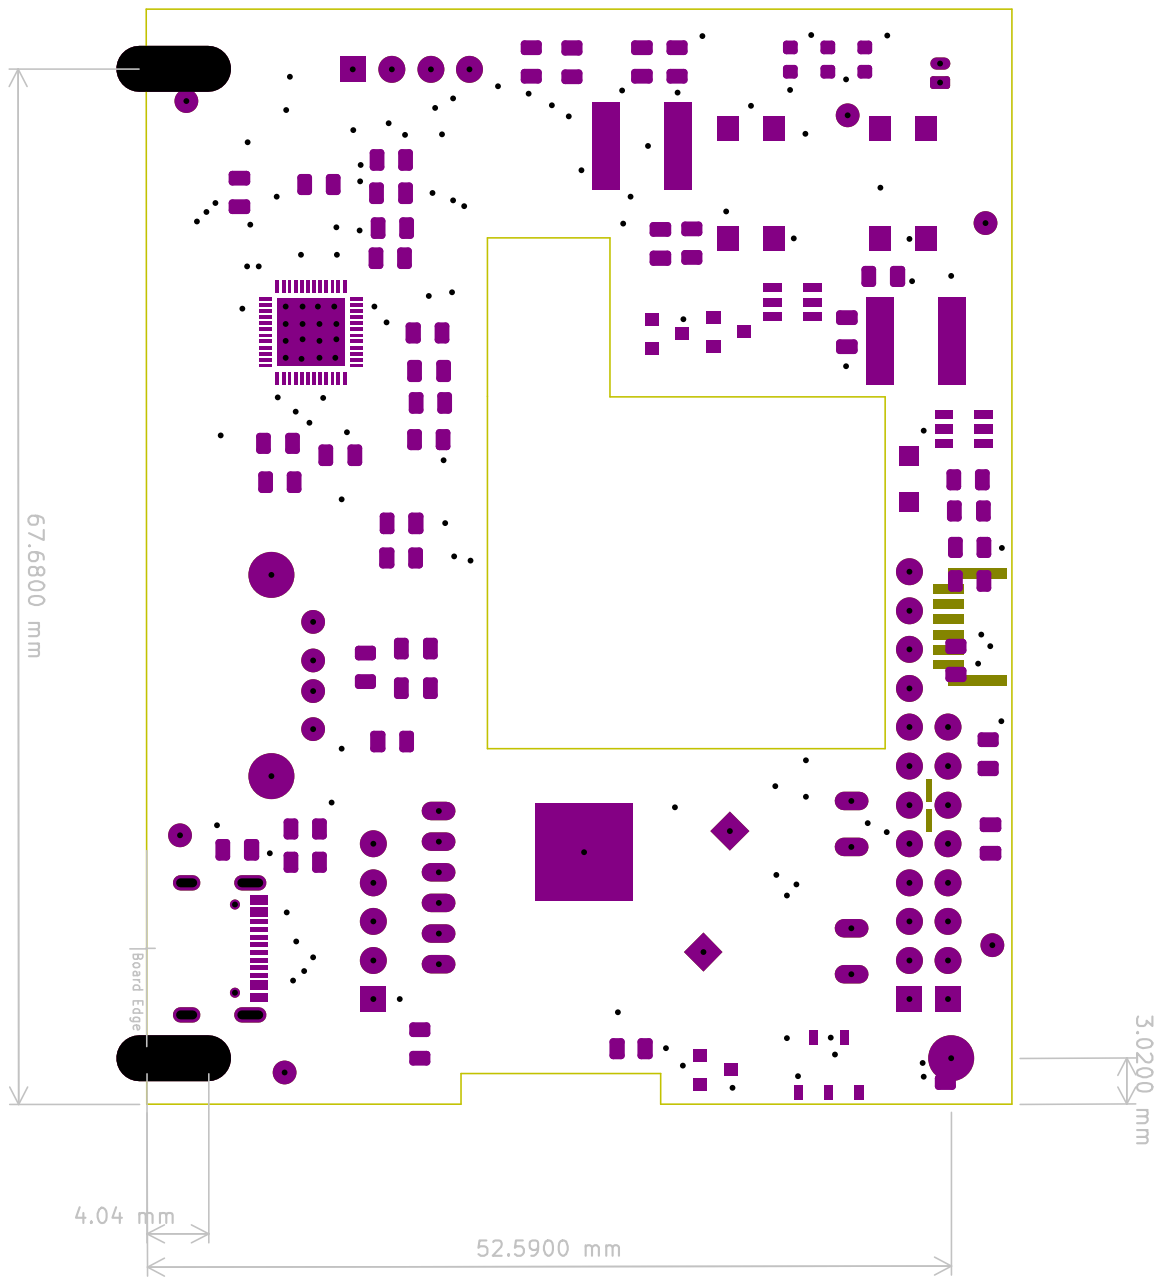
[picture p20: page 1]
