ConnectBox/Circuit-Design/Hat_7.0.6/HAT_ver_7.0.6/HAT_Dimensions.pdf

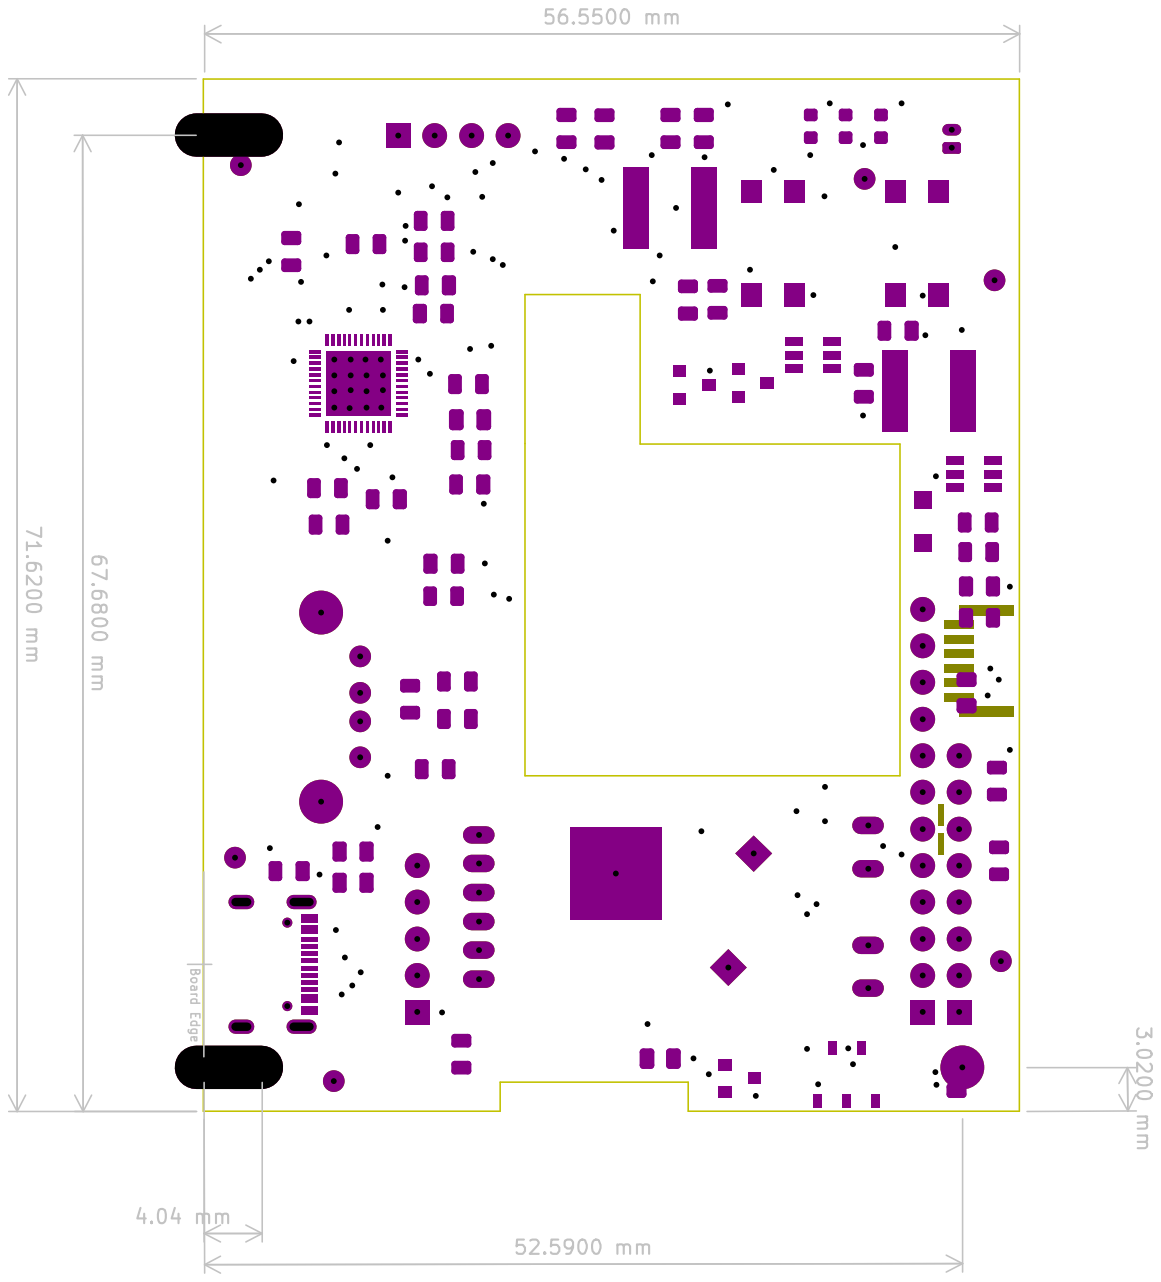
[picture p21: page 1]
