ConnectBox/Circuit-Design/Hat 8.3.1/HATB_ver_8.3.1/HATB_ver_8.3.1.kicad_pcb

## KiCad design Hat 8.3.1/HATB_ver_8.3.1/HATB_ver_8.3.1.kicad_pcb (2025-01-07)

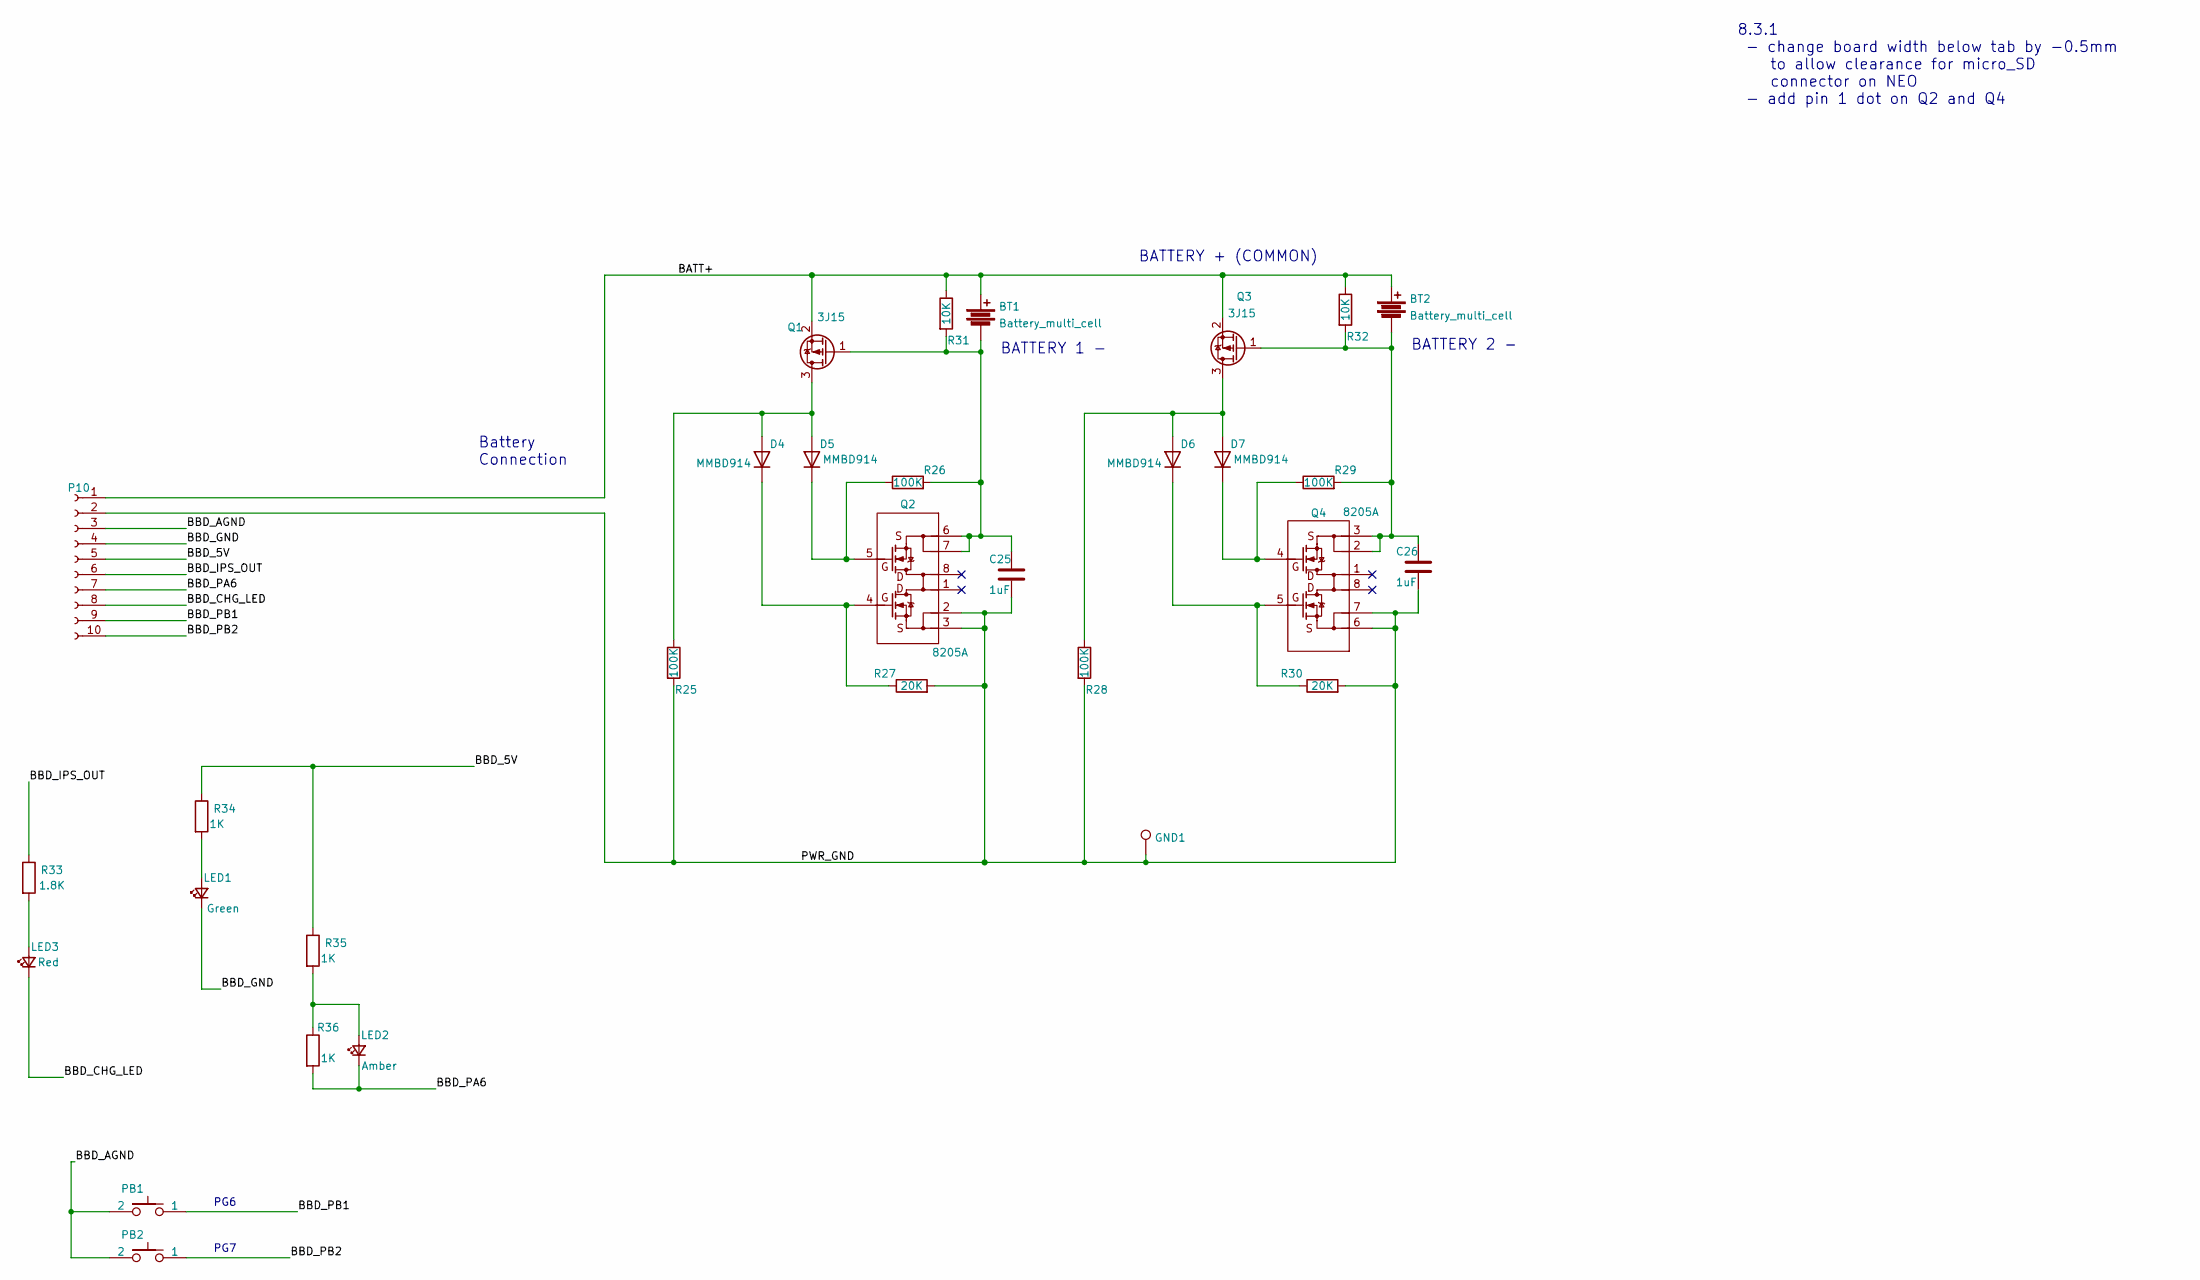
[picture p22: schematic HATB_ver_8.3.1.kicad_sch, ConnectBox - Battery Board]

Parts:
BT1, BT2: Battery_multi_cell; Battery 21700; Manufacturer P/N 109-2; DigiKey P/N 36-109-2-ND (2x)
C25, C26: 1uF; C_0805_2012Metric; Manufacturer P/N C0805C105K8PACTU; DigiKey P/N 399-8006-1-ND
D4, D5, D6, D7: MMBD914; D_SOT-23_ANK; Manufacturer P/N MMBD914LT1G; DigiKey P/N MMBD914LT1GOSCT-ND
GND1: TestPoint; TestPoint_THTPad_D1.5mm_Drill0.7mm
LED1: Green; LED_0603_1608Metric; Manufacturer P/N LTST-C191KFKT; DigiKey P/N 160-1446-1-ND
LED2: Amber; LED_0603_1608Metric; Manufacturer P/N LTST-C191KFKT; DigiKey P/N 160-1445-1-ND
LED3: Red; LED_0603_1608Metric; Manufacturer P/N LTST-C191KRKT; DigiKey P/N 160-1447-1-ND
P10: Conn_01x10_Female; PinSocket_2x05_P2.54mm_Vertical; Manufacturer P/N PPPC052LFBN-RC; DigiKey P/N S7108-ND
PB1, PB2: SPST-PUSH; SW-TL3305; Manufacturer P/N TL3305AF260QG; DigiKey P/N EG5353CT-ND
Q1, Q3: 3J15; SOT-323_SC-70; Manufacturer P/N SSM3J15FU,LF; DigiKey P/N SSM3J15FULFCT-ND
Q2, Q4: 8205A; 8305A; DigiKey P/N [none - from AliExpress|
R25, R26, R28, R29: 100K; R_0805_2012Metric; Manufacturer P/N RC0805FR-07100KL; DigiKey P/N 311-100KCRCT-ND
R27, R30: 20K; R_0805_2012Metric; Manufacturer P/N RC0805FR-0720KL; DigiKey P/N 311-20.0KCRCT-ND
R31, R32: 10K; R_0805_2012Metric; Manufacturer P/N RC0805FR-0710KL; DigiKey P/N 311-10KCRCT-ND
R33: 1.8K; R_0805_2012Metric; Manufacturer P/N RC0805FR-071K8L; DigiKey P/N 311-1.80KCRCT-ND
R34, R35, R36: 1K; R_0805_2012Metric; Manufacturer P/N RC0805FR-071KL; DigiKey P/N 311-1.00KCRCT-ND

Connections:
/BATT+: BT1.1, BT2.1, P10.1, Q1.2 (S), Q3.2 (S), R31.1, R32.1
/BBD_5V: P10.5, R34.1, R35.1
/BBD_AGND: P10.3, PB1.2, PB2.2
/BBD_CHG_LED: LED3.1 (K), P10.8
/BBD_GND: LED1.1 (K), P10.4
/BBD_IPS_OUT: P10.6, R33.1
/BBD_PA6: LED2.1 (K), P10.7, R36.2
/BBD_PB1: P10.9, PB1.1
/BBD_PB2: P10.10, PB2.1
/PWR_GND: C25.2, C26.2, GND1.1, P10.2, Q2.2 (S1), Q2.3 (S1), Q4.6 (S2), Q4.7 (S2), R25.2, R27.2, R28.2, R30.2
unnamed: BT1.2, C25.1, Q1.1 (G), Q2.6 (S2), Q2.7 (S2), R26.2, R31.2
unnamed: BT2.2, C26.1, Q3.1 (G), Q4.2 (S1), Q4.3 (S1), R29.2, R32.2
unnamed: D4.1 (K), Q2.4 (G1), R27.1
unnamed: D4.2 (A), D5.2 (A), Q1.3 (D), R25.1
unnamed: D5.1 (K), Q2.5 (G2), R26.1
unnamed: D6.1 (K), Q4.5 (G2), R30.1
unnamed: D6.2 (A), D7.2 (A), Q3.3 (D), R28.1
unnamed: D7.1 (K), Q4.4 (G1), R29.1
unnamed: LED1.2 (A), R34.2
unnamed: LED2.2 (A), R35.2, R36.1
unnamed: LED3.2 (A), R33.2

Notes on the sheet:
BATTERY + (COMMON)
PG7
BATTERY 1 -
Battery Connection
8.3.1 - change board width below tab by -0.5mm to allow clearance for micro_SD connector on NEO - add pin 1 dot on Q2 and Q4
PG6
BATTERY 2 -

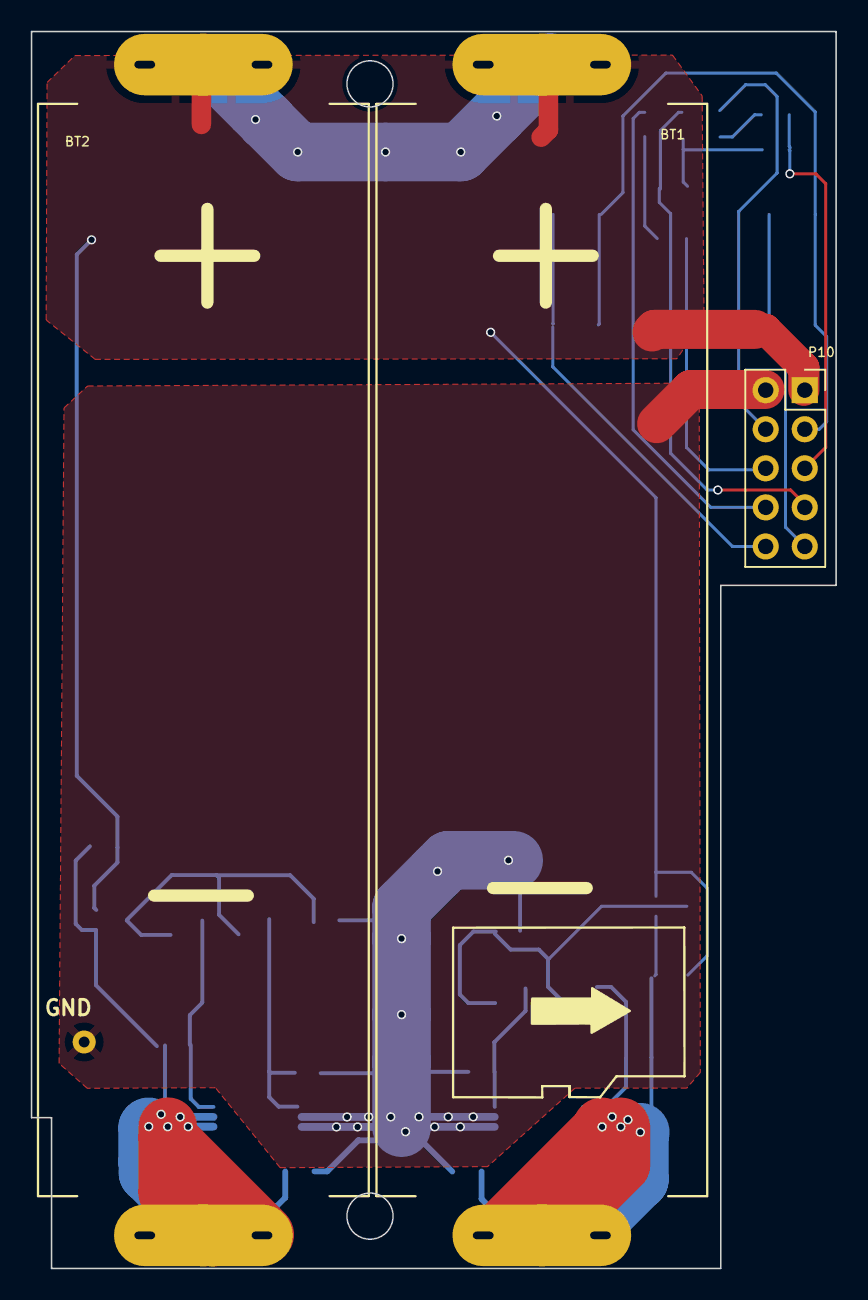
[picture p23: board HATB_ver_8.3.1.kicad_pcb from above]

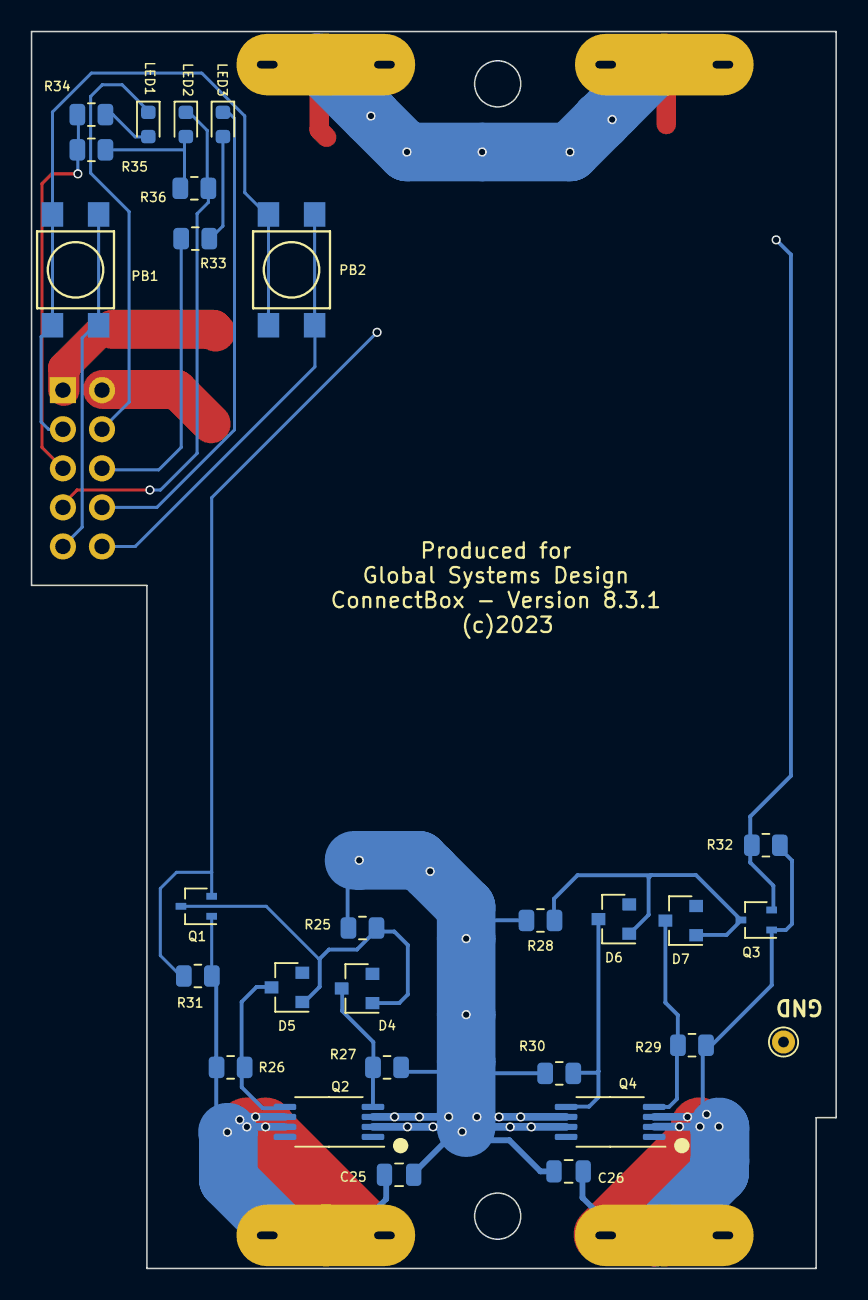
[picture p24: board HATB_ver_8.3.1.kicad_pcb from below]

Board: 2 copper layers, 52.3 x 80.4 mm, 31 parts (28 on the bottom side), 21 nets.
