ConnectBox/Circuit-Design/Hat 8.3.1/HATA_ver_8.3.1/HATA_ver_8.3.1.kicad_pcb

## KiCad design Hat 8.3.1/HATA_ver_8.3.1/HATA_ver_8.3.1.kicad_pcb (2025-01-07)

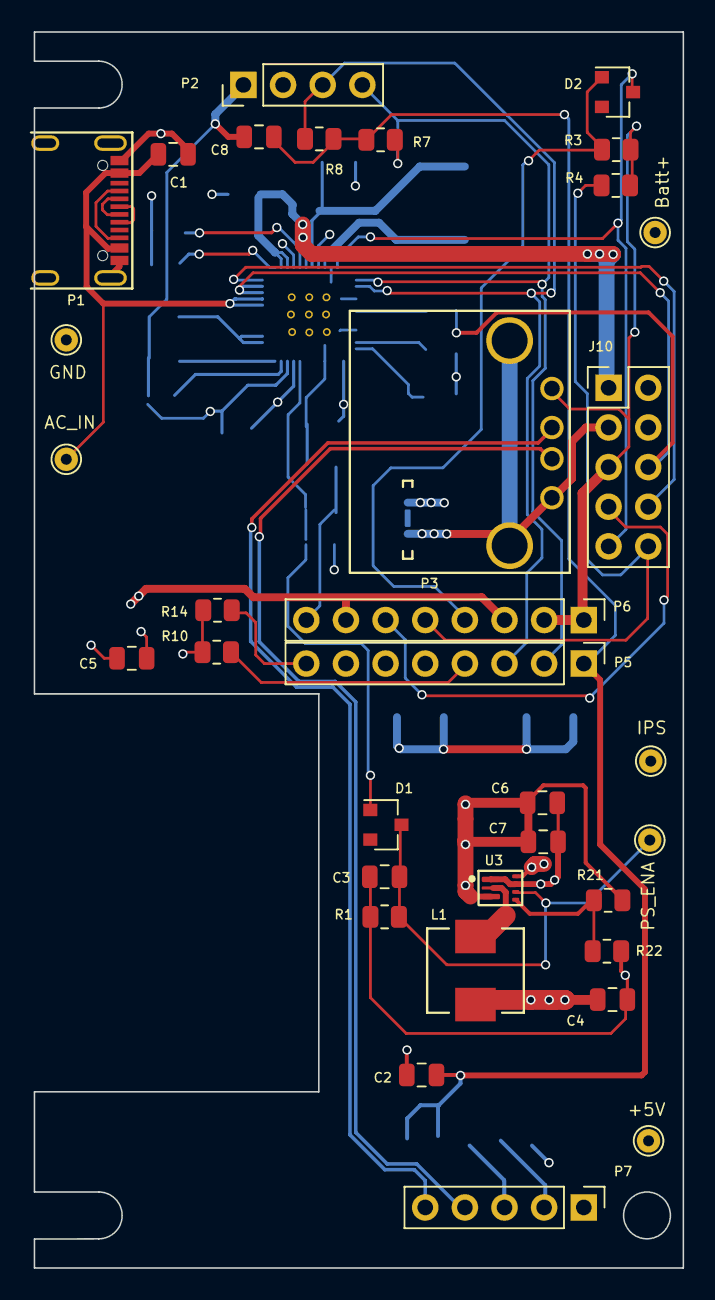
[picture p25: board HATA_ver_8.3.1.kicad_pcb from above]

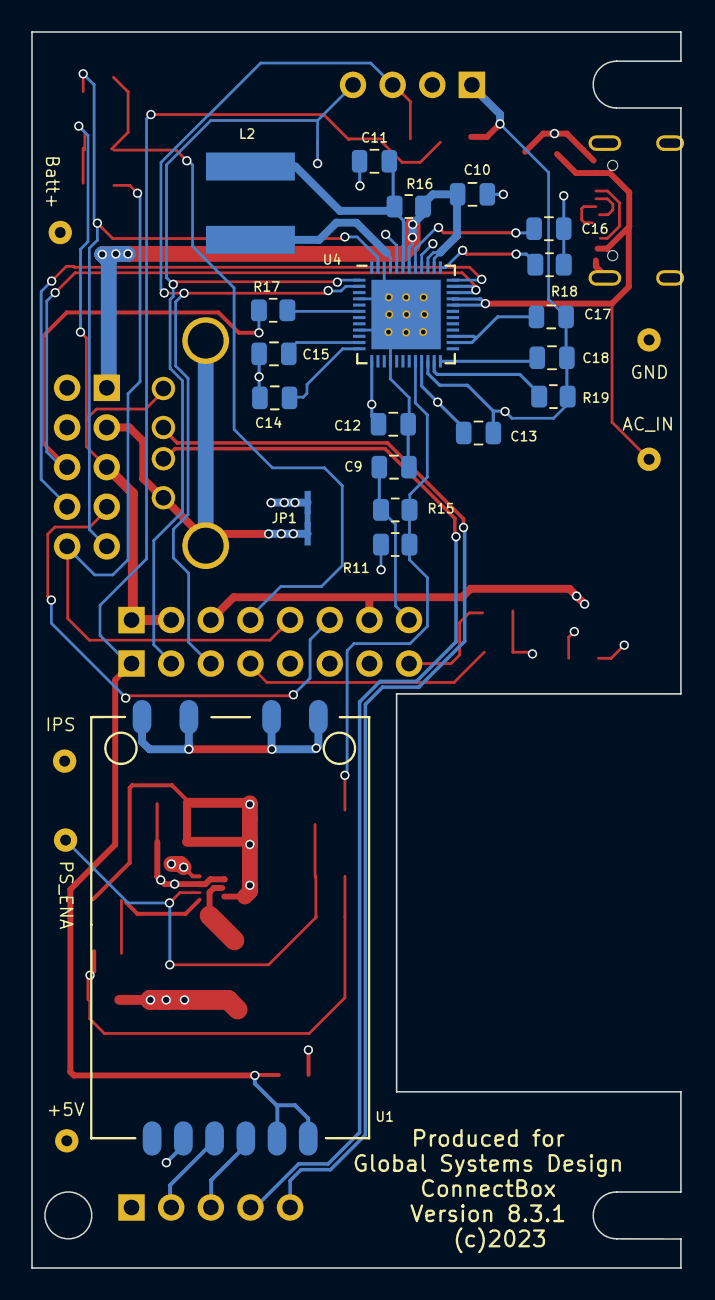
[picture p26: board HATA_ver_8.3.1.kicad_pcb from below]

Board: 4 copper layers, 41.6 x 79.2 mm, 54 parts (20 on the bottom side), 38 nets.

Parts:
C1, C2, C3, C5, C6, C7: 22uF; C_0805_2012Metric
C4: 10uf; C_0805_2012Metric
C8, C17, C18: 1uF; C_0805_2012Metric
C9, C10, C11, C12, C13: 10uF; C_0805_2012Metric
C14, C15, C16: 4.7uF; C_0805_2012Metric
D1, D2: MMBD914; D_SOT-23_ANK
J10: Conn_01x10_Female; PinHeader_2x05_P2.54mm_Vertical
JP1: Jumper; NetConnect-50
L1: 1.0 uH; INDUCTOR_SMD_5x5
L2: 4.7 uH; INDUCTOR_SMD_6x6-1
P1: USB-C; USB-C-GCT
P2: Conn_01x04; PinHeader_1x04_P2.54mm_Vertical
P3: USB_A_1; USB_A
P5, P6: Conn_01x08; PinHeader_1x08_P2.54mm_Vertical
P7: Conn_01x05; PinHeader_1x05_P2.54mm_Vertical
R1: 220K; R_0805_2012Metric
R3, R4, R17: 10K; R_0805_2012Metric
R7, R8, R10, R14: 2.2K; R_0805_2012Metric
R11: 51K; R_0805_2012Metric
R15: 1K; R_0805_2012Metric
R16: 0.03 ohm; R_0805_2012Metric
R18: 100; R_0805_2012Metric
R19: 200K; R_0805_2012Metric
R21: 732K; R_0805_2012Metric
R22: 100K; R_0805_2012Metric
TP1: Gnd; TestPoint_THTPad_D1.5mm_Drill0.7mm
TP2: IPS; TestPoint_THTPad_D1.5mm_Drill0.7mm
TP3: Ext_En; TestPoint_THTPad_D1.5mm_Drill0.7mm
TP4: 5V; TestPoint_THTPad_D1.5mm_Drill0.7mm
TP5: AC_IN; TestPoint_THTPad_D1.5mm_Drill0.7mm
TP6: Bat+; TestPoint_THTPad_D1.5mm_Drill0.7mm
U1: HC-R8812AF1; HC-R8812AU2-th-2
U3: TPS61022
U4: AXP209; UQFN-48-1EP_6x6mm_Pitch0.4mm_75

Connections:
/3v3: C2.1, C8.1, P5.1, R7.2, R8.2, U1.1 (PDN), U1.2 (3.3V)
/5V_FB: R21.2, R22.1, U3.4 (FB)
/5V_OUT: C5.1, C6.1, C7.1, J10.5, P2.2, P3.1 (VCC), P6.1, P6.2, P7.1, R3.2, R4.2, R11.1, R21.1, TP4.1, U3.3 (Vout)
/A_GND: C2.2, C5.2, C8.2, C13.1, C17.1, C18.1, J10.3, JP1.1, P2.1, P3.4 (GND), P3.5 (shield), P5.5, R10.2, R14.2, R19.1, U1.5 (GND), U1.7 (GND), U1.9 (GND), U1.10 (GND), U1.12 (GND), U4.22 (A_Gnd)
/BBD_CHG_LED: J10.8, U4.36 (ChgLED)
/BBD_IPS_OUT: C4.1, C12.1, C13.2, J10.6, L1.1, R17.2, TP2.1, U3.7 (VIN), U4.13 (LDO_24_In), U4.21 (APS), U4.34 (IPS_Out), U4.35 (IPS_Out), U4.40 (LDO_3_In), U4.44 (Vin_1)
/BBD_PA6: J10.7, P6.6
/BBD_PB1: D2.1 (K), J10.9, U4.47 (PwrON)
/BBD_PB2: J10.10, P6.5, R4.1
/PA3: P5.8, R14.1
/PG11: P5.4, R10.1
/Power control/AC_IN: C1.1, P1.A4/B9 (Power), P1.B4/A9 (Power), TP5.1, U4.32 (AC_IN), U4.33 (AC_IN)
/Power control/BATT+: C10.1, J10.1, R16.1, TP6.1, U4.38 (Batt), U4.39 (Batt), U4.42 (BatSense)
/Power control/EXT_EN: D1.2 (A), R11.2, R15.1, U4.20 (EXTEN)
/SCL: P2.3, P5.3, R8.1, U4.2 (SCK)
/SDA: P2.4, P5.2, R7.1, U4.1 (SDA)
/U2_SW: L1.2, U3.2 (SW)
/USB2_D+: P3.3 (D+), P7.4
/USB2_D-: P3.2 (D-), P7.5
GND: C1.2, C3.2, C4.2, C6.2, C7.2, C9.1, C10.2, C11.2, C12.2, C14.1, C15.1, C16.1, J10.2, J10.4, JP1.2, P1.1 (Shell), P1.A1/B12 (GND), P1.B1/A12 (GND), P6.3, P6.7, R1.2, R18.2, R22.2, TP1.1, U3.1 (GND), U3.6 (MODE), U4.4 (N_OE), U4.9 (PGnd_2), U4.16 (PGnd_3), U4.46 (PGnd_1), U4.49 (GND_PAD)
unnamed: C3.1, D1.1 (K), R1.1, TP3.1, U3.5 (ENA)
unnamed: C9.2, P6.8, R15.2
unnamed: C11.1, L2.1, R16.2, U4.43 (ChgSense)
unnamed: C14.2, U4.12 (LDO_2)
unnamed: C15.2, U4.11 (LDO_4)
unnamed: C16.2, U4.41 (LDO_3)
unnamed: C17.2, U4.26 (V_Internal), U4.27 (LDO_1_Set)
unnamed: C18.2, U4.24 (V_Ref)
unnamed: D2.2 (A), P6.4, R3.1
unnamed: L2.2, U4.45 (LX1)
unnamed: P1.A5 (CC1), P1.B5 (CC2)
unnamed: P1.A6 (D+), P1.B6 (D+)
unnamed: P1.A7 (D-), P1.B7 (D-)
unnamed: P7.2, U1.4 (DP+)
unnamed: P7.3, U1.3 (DM-)
unnamed: R17.1, U4.6 (N_VBus_En)
unnamed: R18.1, U4.37 (TS)
unnamed: R19.2, U4.23 (Bias)
