ConnectBox/Circuit-Design/Hat 8.3.1/HATB_ver_8.3.1/HATB_ver_8.3.1.kicad_pcb

## KiCad design Hat 2.0/HAT_CM4_183_041022-V2.1/HAT_CM4_183.kicad_pcb

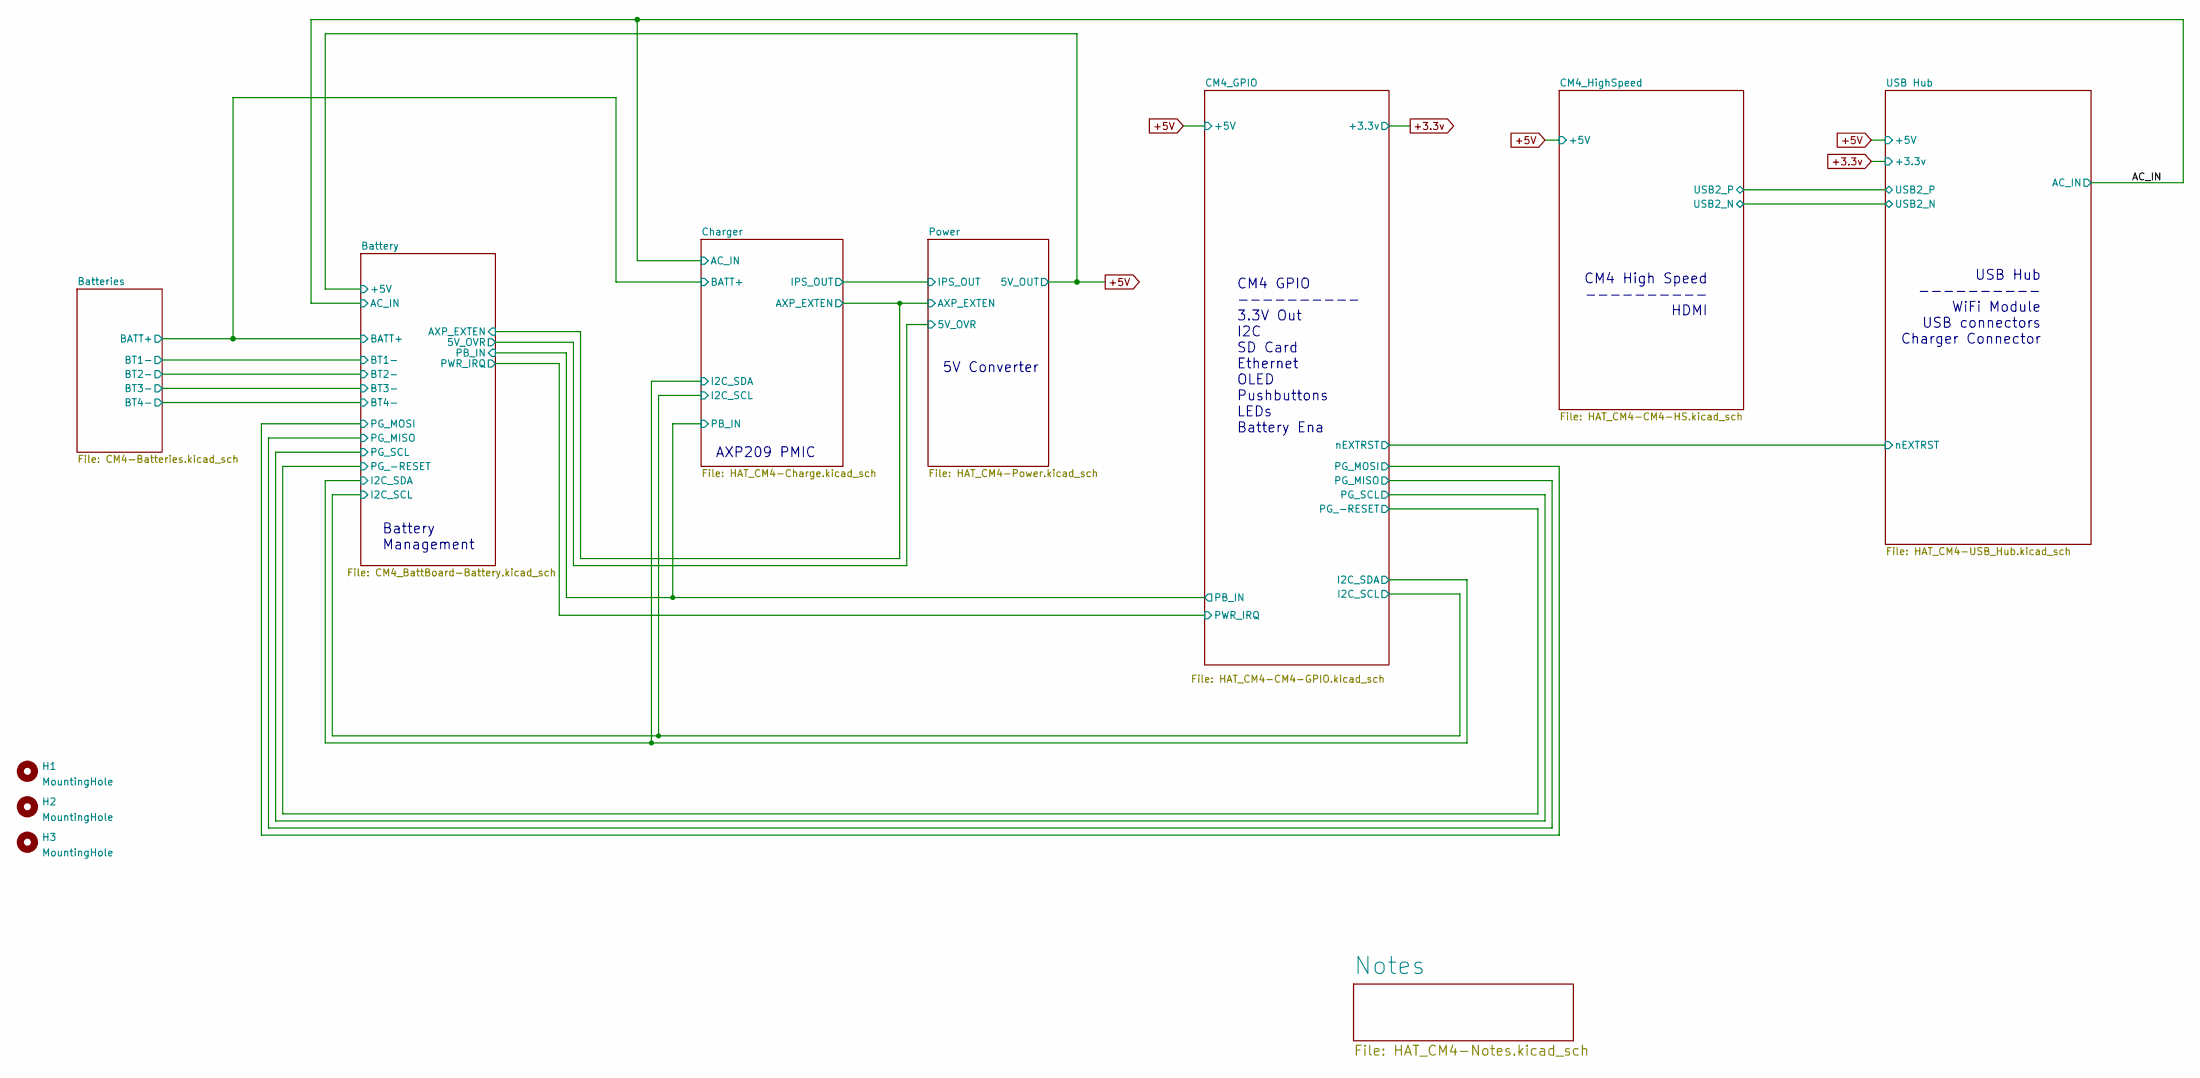
[picture p27: schematic HAT_CM4_183.kicad_sch, ConnectBox CM4 for China Case]

Parts:
H1, H2, H3: MountingHole; MountingHole_4.3mm_M4-A

Notes on the sheet:
USB Hub ---------- WiFi Module USB connectors Charger Connector
Battery Management
5V Converter
CM4 GPIO ---------- 3.3V Out I2C SD Card Ethernet OLED Pushbuttons LEDs Battery Ena
CM4 High Speed ---------- HDMI
AXP209 PMIC

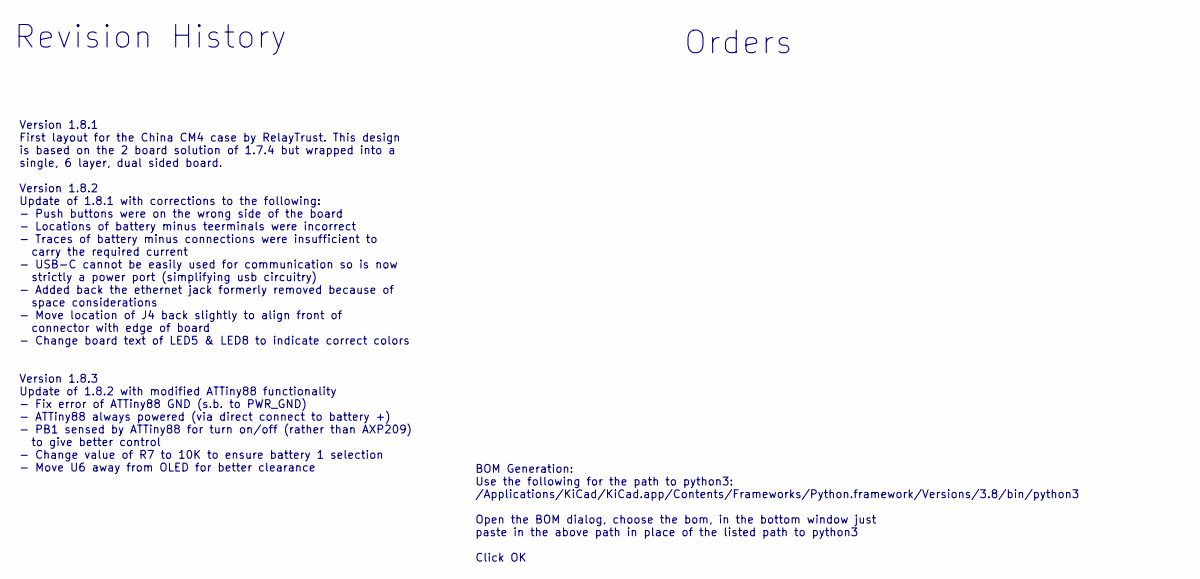
[picture p28: schematic HAT_CM4-Notes.kicad_sch, ConnectBox CM4 for China Case]

Notes on the sheet:
Orders
BOM Generation: Use the following for the path to python3: /Applications/KiCad/KiCad.app/Contents/Frameworks/Python.framework/Versions/3.8/bin/python3 Open the BOM dialog, choose the bom, in the bottom window just paste in the above path in place of the listed path to python3 Click OK
Version 1.8.1 First layout for the China CM4 case by RelayTrust. This design is based on the 2 board solution of 1.7.4 but wrapped into a single, 6 layer, dual sided board. Version 1.8.2 Update of 1.8.1 with corrections to the following: - Push buttons were on the wrong side of the board - Location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
Revision History

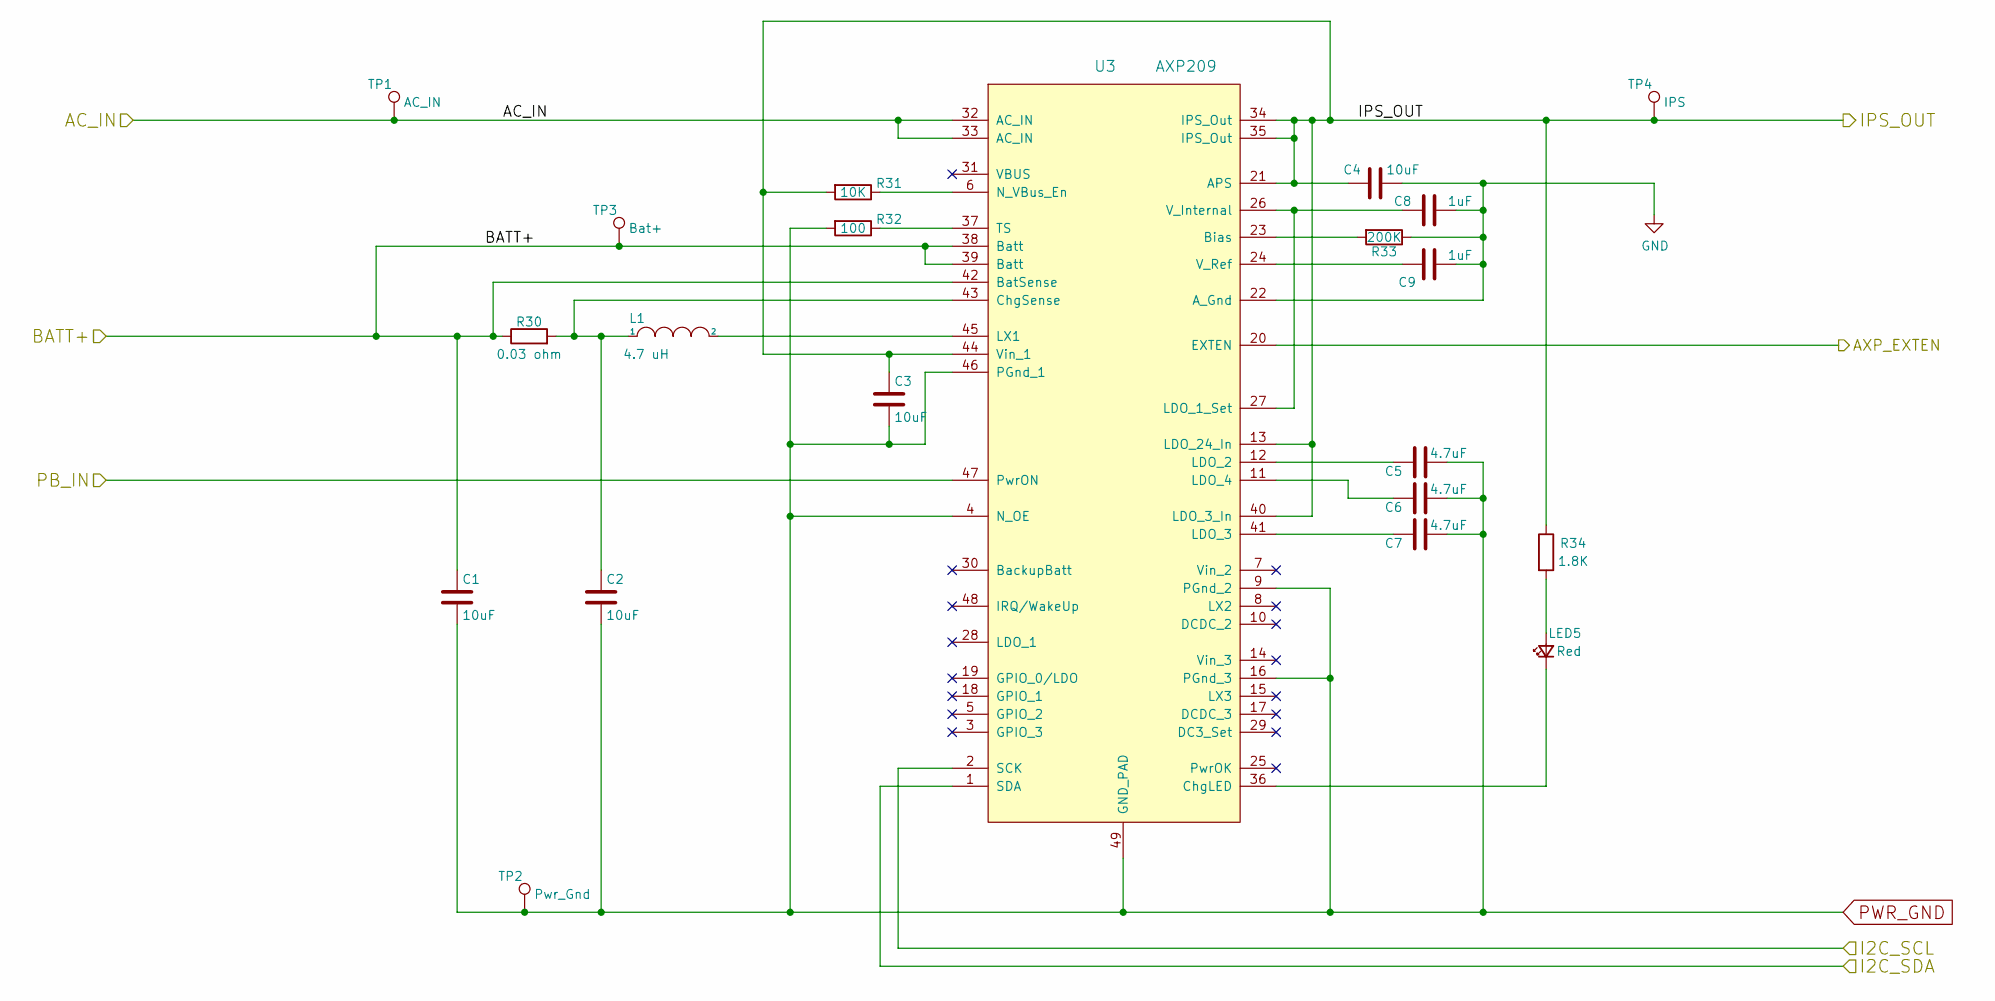
[picture p29: schematic HAT_CM4-Charge.kicad_sch, ConnectBox CM4 for China Case]

Parts:
C1, C2, C3, C4: 10uF; C_0603_1608Metric; Manufacturer P/N C0603C106M9PACTU; DigiKey P/N 399-C0603C106M9PAC7867CT-ND
C5, C6, C7: 4.7uF; C_0603_1608Metric; Manufacturer P/N C0603C475K9PACTU; DigiKey P/N 399-3482-1-ND
C8, C9: 1uF; C_0603_1608Metric; Manufacturer P/N CL10A105KQ8NNNC‎; DigiKey P/N 1276-1036-1-ND
L1: 4.7 uH; INDUCTOR_SMD_6x6-1; Manufacturer P/N NR6028T4R7M; DigiKey P/N 587-2100-1-ND
LED5: Red; LED_0603_1608Metric; Manufacturer P/N LTST-C191KRKT; DigiKey P/N 160-1447-1-ND
R30: 0.03 ohm; R_0603_1608Metric; Manufacturer P/N ERJ-3BWFR030V; DigiKey P/N P17466CT-ND
R31: 10K; R_0603_1608Metric; Manufacturer P/N RC0603FR-0710KL; DigiKey P/N 311-10.0KHRCT-ND
R32: 100; R_0603_1608Metric; Manufacturer P/N RC06-3FR-07100RL; DigiKey P/N 311-100HRCT-ND
R33: 200K; R_0603_1608Metric; Manufacturer P/N RC0603FR-07200KL; DigiKey P/N 311-200KHRCT-ND
R34: 1.8K; R_0603_1608Metric; Manufacturer P/N RC0603FR-071K8L; DigiKey P/N 311-1.80KHRCT-ND
TP1: AC_IN; TestPoint_THTPad_D1.5mm_Drill0.7mm
TP2: Pwr_Gnd; TestPoint_THTPad_D1.5mm_Drill0.7mm
TP3: Bat+; TestPoint_THTPad_D1.5mm_Drill0.7mm
TP4: IPS; TestPoint_THTPad_D1.5mm_Drill0.7mm
U3: AXP209; UQFN-48-1EP_6x6mm_Pitch0.4mm_75; Manufacturer P/N AXP209; DigiKey P/N [none - from AliExpress]

Connections:
/AC_IN: TP1.1, U3.32 (AC_IN), U3.33 (AC_IN); also elsewhere on the board
/Battery/AXP_EXTEN: U3.20 (EXTEN); also elsewhere on the board
/Battery/BATT+: C1.1, R30.1, TP3.1, U3.38 (Batt), U3.39 (Batt), U3.42 (BatSense); also elsewhere on the board
/Battery/I2C_SCL: U3.2 (SCK); also elsewhere on the board
/Battery/I2C_SDA: U3.1 (SDA); also elsewhere on the board
/Battery/PB_IN: U3.47 (PwrON); also elsewhere on the board
/Charger/IPS_OUT: C3.1, C4.1, R31.2, R34.1, TP4.1, U3.13 (LDO_24_In), U3.21 (APS), U3.34 (IPS_Out), U3.35 (IPS_Out), U3.40 (LDO_3_In), U3.44 (Vin_1); also elsewhere on the board
GND: C4.2, C8.1, C9.1, R33.1, U3.22 (A_Gnd); also elsewhere on the board
unnamed: C2.1, L1.1, R30.2, U3.43 (ChgSense)
unnamed: C5.2, U3.12 (LDO_2)
unnamed: C6.2, U3.11 (LDO_4)
unnamed: C7.2, U3.41 (LDO_3)
unnamed: C8.2, U3.26 (V_Internal), U3.27 (LDO_1_Set)
unnamed: C9.2, U3.24 (V_Ref)
unnamed: L1.2, U3.45 (LX1)
unnamed: LED5.1 (K), U3.36 (ChgLED)
unnamed: LED5.2 (A), R34.2
unnamed: R31.1, U3.6 (N_VBus_En)
unnamed: R32.1, U3.37 (TS)
unnamed: R33.2, U3.23 (Bias)
PWR_GND: C1.2, C2.2, C3.2, C5.1, C6.1, C7.1, R32.2, TP2.1, U3.4 (N_OE), U3.9 (PGnd_2), U3.16 (PGnd_3), U3.46 (PGnd_1), U3.49 (GND_PAD); also elsewhere on the board

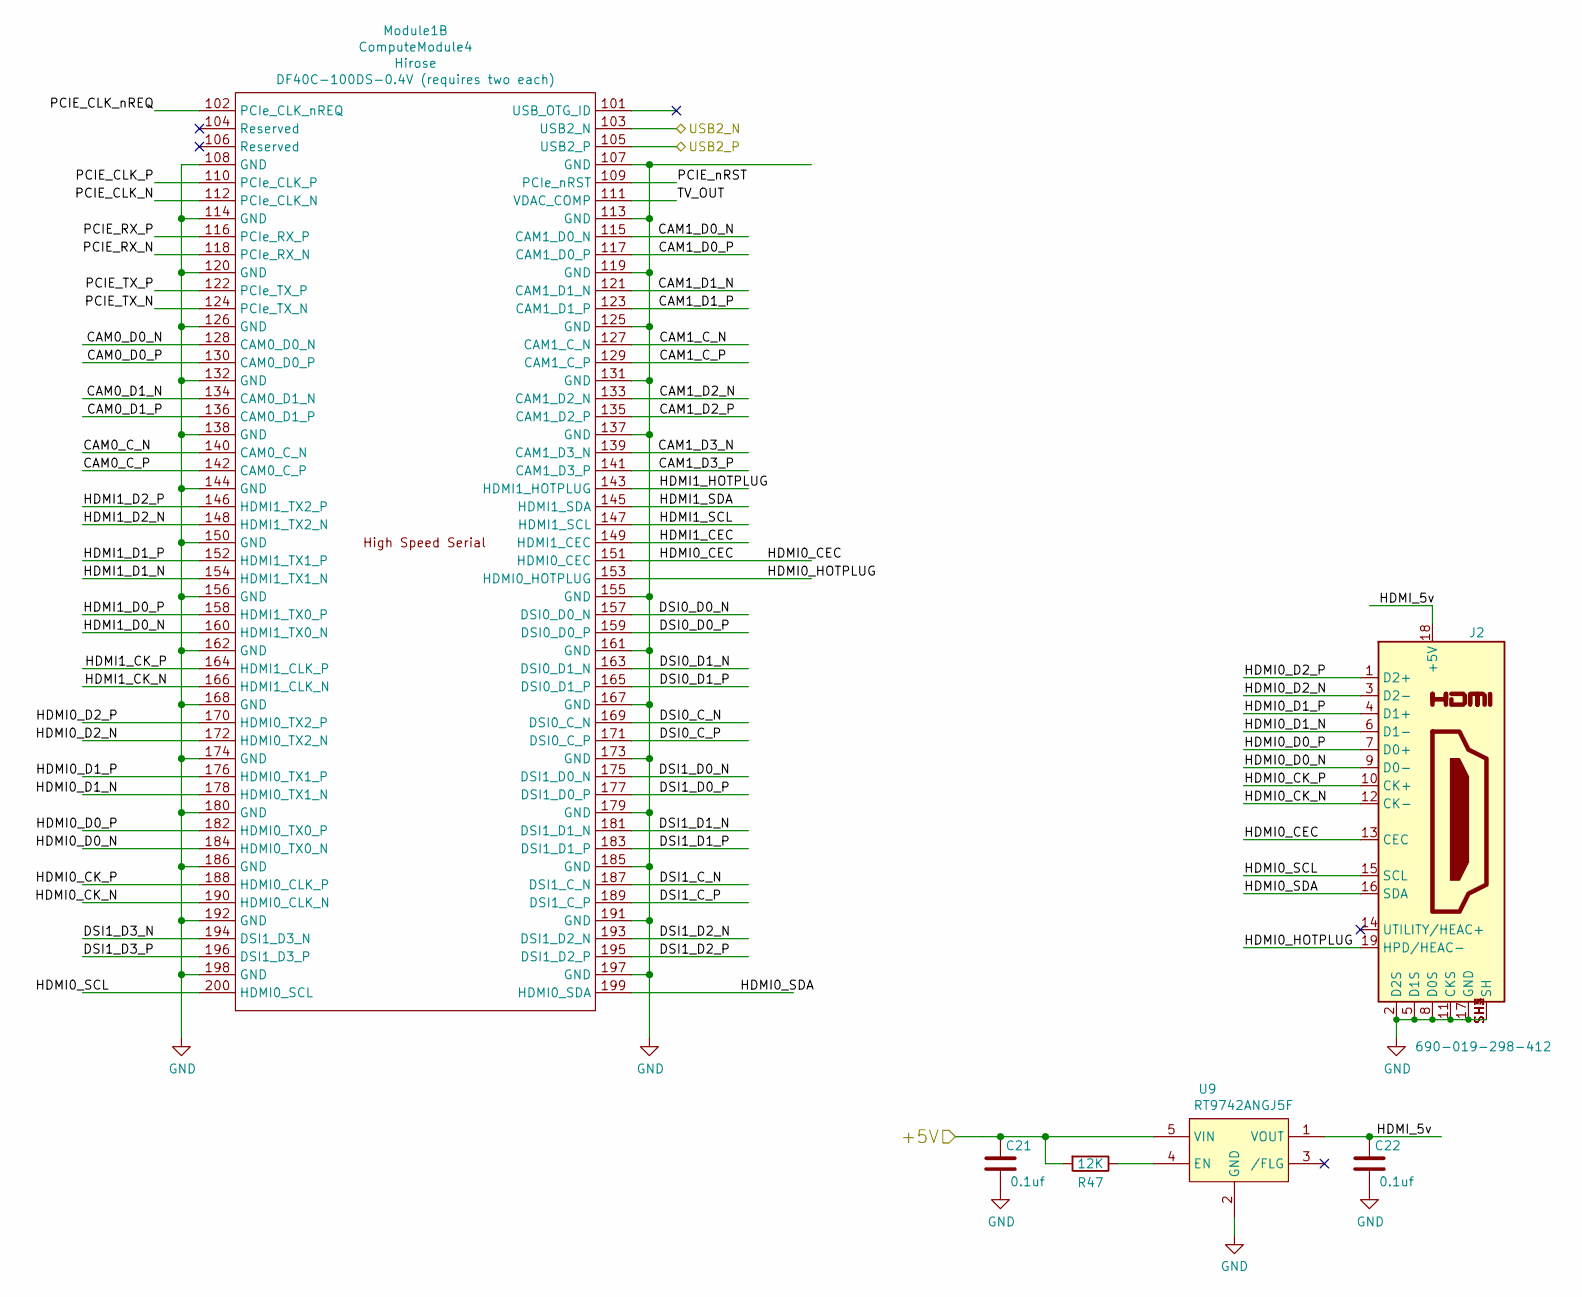
[picture p30: schematic HAT_CM4-CM4-HS.kicad_sch, ConnectBox CM4 for China Case]

Parts:
C21, C22: 0.1uf; C_0603_1608Metric; Manufacturer P/N C0603C104K9PAC7867; DigiKey P/N 399-17575-1-ND
J2: 690-019-298-412; HDMI_CnC_SMT; Manufacturer P/N 2000-1-2-41-00-BK; DigiKey P/N 1175-1703-ND
Module1: ComputeModule4; CM4_Module_noHoles; Manufacturer P/N DF40C-100DS-0.4V (requires two each); DigiKey P/N H11615CT-ND (requires two each)
R47: 12K; R_0603_1608Metric; Manufacturer P/N RC0603FR-12K2L; DigiKey P/N 311-12.0KHRCT-ND
U9: RT9742ANGJ5F; SOT-23-5; Manufacturer P/N RT9742ANGJ5F; DigiKey P/N 1028-1427-1-ND

Connections:
+5V: C21.1, R47.2, U9.5 (VIN); also elsewhere on the board
/CM4_HighSpeed/CAM0_C_N: Module1.140 (CAM0_C_N)
/CM4_HighSpeed/CAM0_C_P: Module1.142 (CAM0_C_P)
/CM4_HighSpeed/CAM0_D0_N: Module1.128 (CAM0_D0_N)
/CM4_HighSpeed/CAM0_D0_P: Module1.130 (CAM0_D0_P)
/CM4_HighSpeed/CAM0_D1_N: Module1.134 (CAM0_D1_N)
/CM4_HighSpeed/CAM0_D1_P: Module1.136 (CAM0_D1_P)
/CM4_HighSpeed/CAM1_C_N: Module1.127 (CAM1_C_N)
/CM4_HighSpeed/CAM1_C_P: Module1.129 (CAM1_C_P)
/CM4_HighSpeed/CAM1_D0_N: Module1.115 (CAM1_D0_N)
/CM4_HighSpeed/CAM1_D0_P: Module1.117 (CAM1_D0_P)
/CM4_HighSpeed/CAM1_D1_N: Module1.121 (CAM1_D1_N)
/CM4_HighSpeed/CAM1_D1_P: Module1.123 (CAM1_D1_P)
/CM4_HighSpeed/CAM1_D2_N: Module1.133 (CAM1_D2_N)
/CM4_HighSpeed/CAM1_D2_P: Module1.135 (CAM1_D2_P)
/CM4_HighSpeed/CAM1_D3_N: Module1.139 (CAM1_D3_N)
/CM4_HighSpeed/CAM1_D3_P: Module1.141 (CAM1_D3_P)
/CM4_HighSpeed/DSI0_C_N: Module1.169 (DSI0_C_N)
/CM4_HighSpeed/DSI0_C_P: Module1.171 (DSI0_C_P)
/CM4_HighSpeed/DSI0_D0_N: Module1.157 (DSI0_D0_N)
/CM4_HighSpeed/DSI0_D0_P: Module1.159 (DSI0_D0_P)
/CM4_HighSpeed/DSI0_D1_N: Module1.163 (DSI0_D1_N)
/CM4_HighSpeed/DSI0_D1_P: Module1.165 (DSI0_D1_P)
/CM4_HighSpeed/DSI1_C_N: Module1.187 (DSI1_C_N)
/CM4_HighSpeed/DSI1_C_P: Module1.189 (DSI1_C_P)
/CM4_HighSpeed/DSI1_D0_N: Module1.175 (DSI1_D0_N)
/CM4_HighSpeed/DSI1_D0_P: Module1.177 (DSI1_D0_P)
/CM4_HighSpeed/DSI1_D1_N: Module1.181 (DSI1_D1_N)
/CM4_HighSpeed/DSI1_D1_P: Module1.183 (DSI1_D1_P)
/CM4_HighSpeed/DSI1_D2_N: Module1.193 (DSI1_D2_N)
/CM4_HighSpeed/DSI1_D2_P: Module1.195 (DSI1_D2_P)
/CM4_HighSpeed/DSI1_D3_N: Module1.194 (DSI1_D3_N)
/CM4_HighSpeed/DSI1_D3_P: Module1.196 (DSI1_D3_P)
/CM4_HighSpeed/HDMI0_CEC: J2.13 (CEC), Module1.151 (HDMI0_CEC)
/CM4_HighSpeed/HDMI0_CK_N: J2.12 (CK-), Module1.190 (HDMI0_CLK_N)
/CM4_HighSpeed/HDMI0_CK_P: J2.10 (CK+), Module1.188 (HDMI0_CLK_P)
/CM4_HighSpeed/HDMI0_D0_N: J2.9 (D0-), Module1.184 (HDMI0_TX0_N)
/CM4_HighSpeed/HDMI0_D0_P: J2.7 (D0+), Module1.182 (HDMI0_TX0_P)
/CM4_HighSpeed/HDMI0_D1_N: J2.6 (D1-), Module1.178 (HDMI0_TX1_N)
/CM4_HighSpeed/HDMI0_D1_P: J2.4 (D1+), Module1.176 (HDMI0_TX1_P)
/CM4_HighSpeed/HDMI0_D2_N: J2.3 (D2-), Module1.172 (HDMI0_TX2_N)
/CM4_HighSpeed/HDMI0_D2_P: J2.1 (D2+), Module1.170 (HDMI0_TX2_P)
/CM4_HighSpeed/HDMI0_HOTPLUG: J2.19 (HPD/HEAC-), Module1.153 (HDMI0_HOTPLUG)
/CM4_HighSpeed/HDMI0_SCL: J2.15 (SCL), Module1.200 (HDMI0_SCL)
/CM4_HighSpeed/HDMI0_SDA: J2.16 (SDA), Module1.199 (HDMI0_SDA)
/CM4_HighSpeed/HDMI1_CEC: Module1.149 (HDMI1_CEC)
/CM4_HighSpeed/HDMI1_CK_N: Module1.166 (HDMI1_CLK_N)
/CM4_HighSpeed/HDMI1_CK_P: Module1.164 (HDMI1_CLK_P)
/CM4_HighSpeed/HDMI1_D0_N: Module1.160 (HDMI1_TX0_N)
/CM4_HighSpeed/HDMI1_D0_P: Module1.158 (HDMI1_TX0_P)
/CM4_HighSpeed/HDMI1_D1_N: Module1.154 (HDMI1_TX1_N)
/CM4_HighSpeed/HDMI1_D1_P: Module1.152 (HDMI1_TX1_P)
/CM4_HighSpeed/HDMI1_D2_N: Module1.148 (HDMI1_TX2_N)
/CM4_HighSpeed/HDMI1_D2_P: Module1.146 (HDMI1_TX2_P)
/CM4_HighSpeed/HDMI1_HOTPLUG: Module1.143 (HDMI1_HOTPLUG)
/CM4_HighSpeed/HDMI1_SCL: Module1.147 (HDMI1_SCL)
/CM4_HighSpeed/HDMI1_SDA: Module1.145 (HDMI1_SDA)
/CM4_HighSpeed/HDMI_5v: C22.1, J2.18 (+5V), U9.1 (VOUT)
/CM4_HighSpeed/PCIE_CLK_N: Module1.112 (PCIe_CLK_N)
/CM4_HighSpeed/PCIE_CLK_P: Module1.110 (PCIe_CLK_P)
/CM4_HighSpeed/PCIE_CLK_nREQ: Module1.102 (PCIe_CLK_nREQ)
/CM4_HighSpeed/PCIE_RX_N: Module1.118 (PCIe_RX_N)
/CM4_HighSpeed/PCIE_RX_P: Module1.116 (PCIe_RX_P)
/CM4_HighSpeed/PCIE_TX_N: Module1.124 (PCIe_TX_N)
/CM4_HighSpeed/PCIE_TX_P: Module1.122 (PCIe_TX_P)
/CM4_HighSpeed/PCIE_nRST: Module1.109 (PCIe_nRST)
/CM4_HighSpeed/TV_OUT: Module1.111 (VDAC_COMP)
/CM4_HighSpeed/USB2_N: Module1.103 (USB2_N); also elsewhere on the board
/CM4_HighSpeed/USB2_P: Module1.105 (USB2_P); also elsewhere on the board
GND: C21.2, C22.2, J2.2 (D2S), J2.5 (D1S), J2.8 (D0S), J2.11 (CKS), J2.17 (GND), J2.SH1 (SH), J2.SH2 (SH), J2.SH3 (SH), J2.SH4 (SH), Module1.107 (GND), Module1.108 (GND), Module1.113 (GND), Module1.114 (GND), Module1.119 (GND), Module1.120 (GND), Module1.125 (GND), Module1.126 (GND), Module1.131 (GND), Module1.132 (GND), Module1.137 (GND), Module1.138 (GND), Module1.144 (GND), Module1.150 (GND), Module1.155 (GND), Module1.156 (GND), Module1.161 (GND), Module1.162 (GND), Module1.167 (GND), Module1.168 (GND), Module1.173 (GND), Module1.174 (GND), Module1.179 (GND), Module1.180 (GND), Module1.185 (GND), Module1.186 (GND), Module1.191 (GND), Module1.192 (GND), Module1.197 (GND), Module1.198 (GND), U9.2 (GND); also elsewhere on the board
unnamed: R47.1, U9.4 (EN)
