ConnectBox/Circuit-Design/Hat 8.3.1/HATB_ver_8.3.1/HATB_ver_8.3.1.kicad_pcb

## KiCad design Hat 2.0/HAT_CM4_183_041022-V2.1/HAT_CM4_183.kicad_pcb (continued)

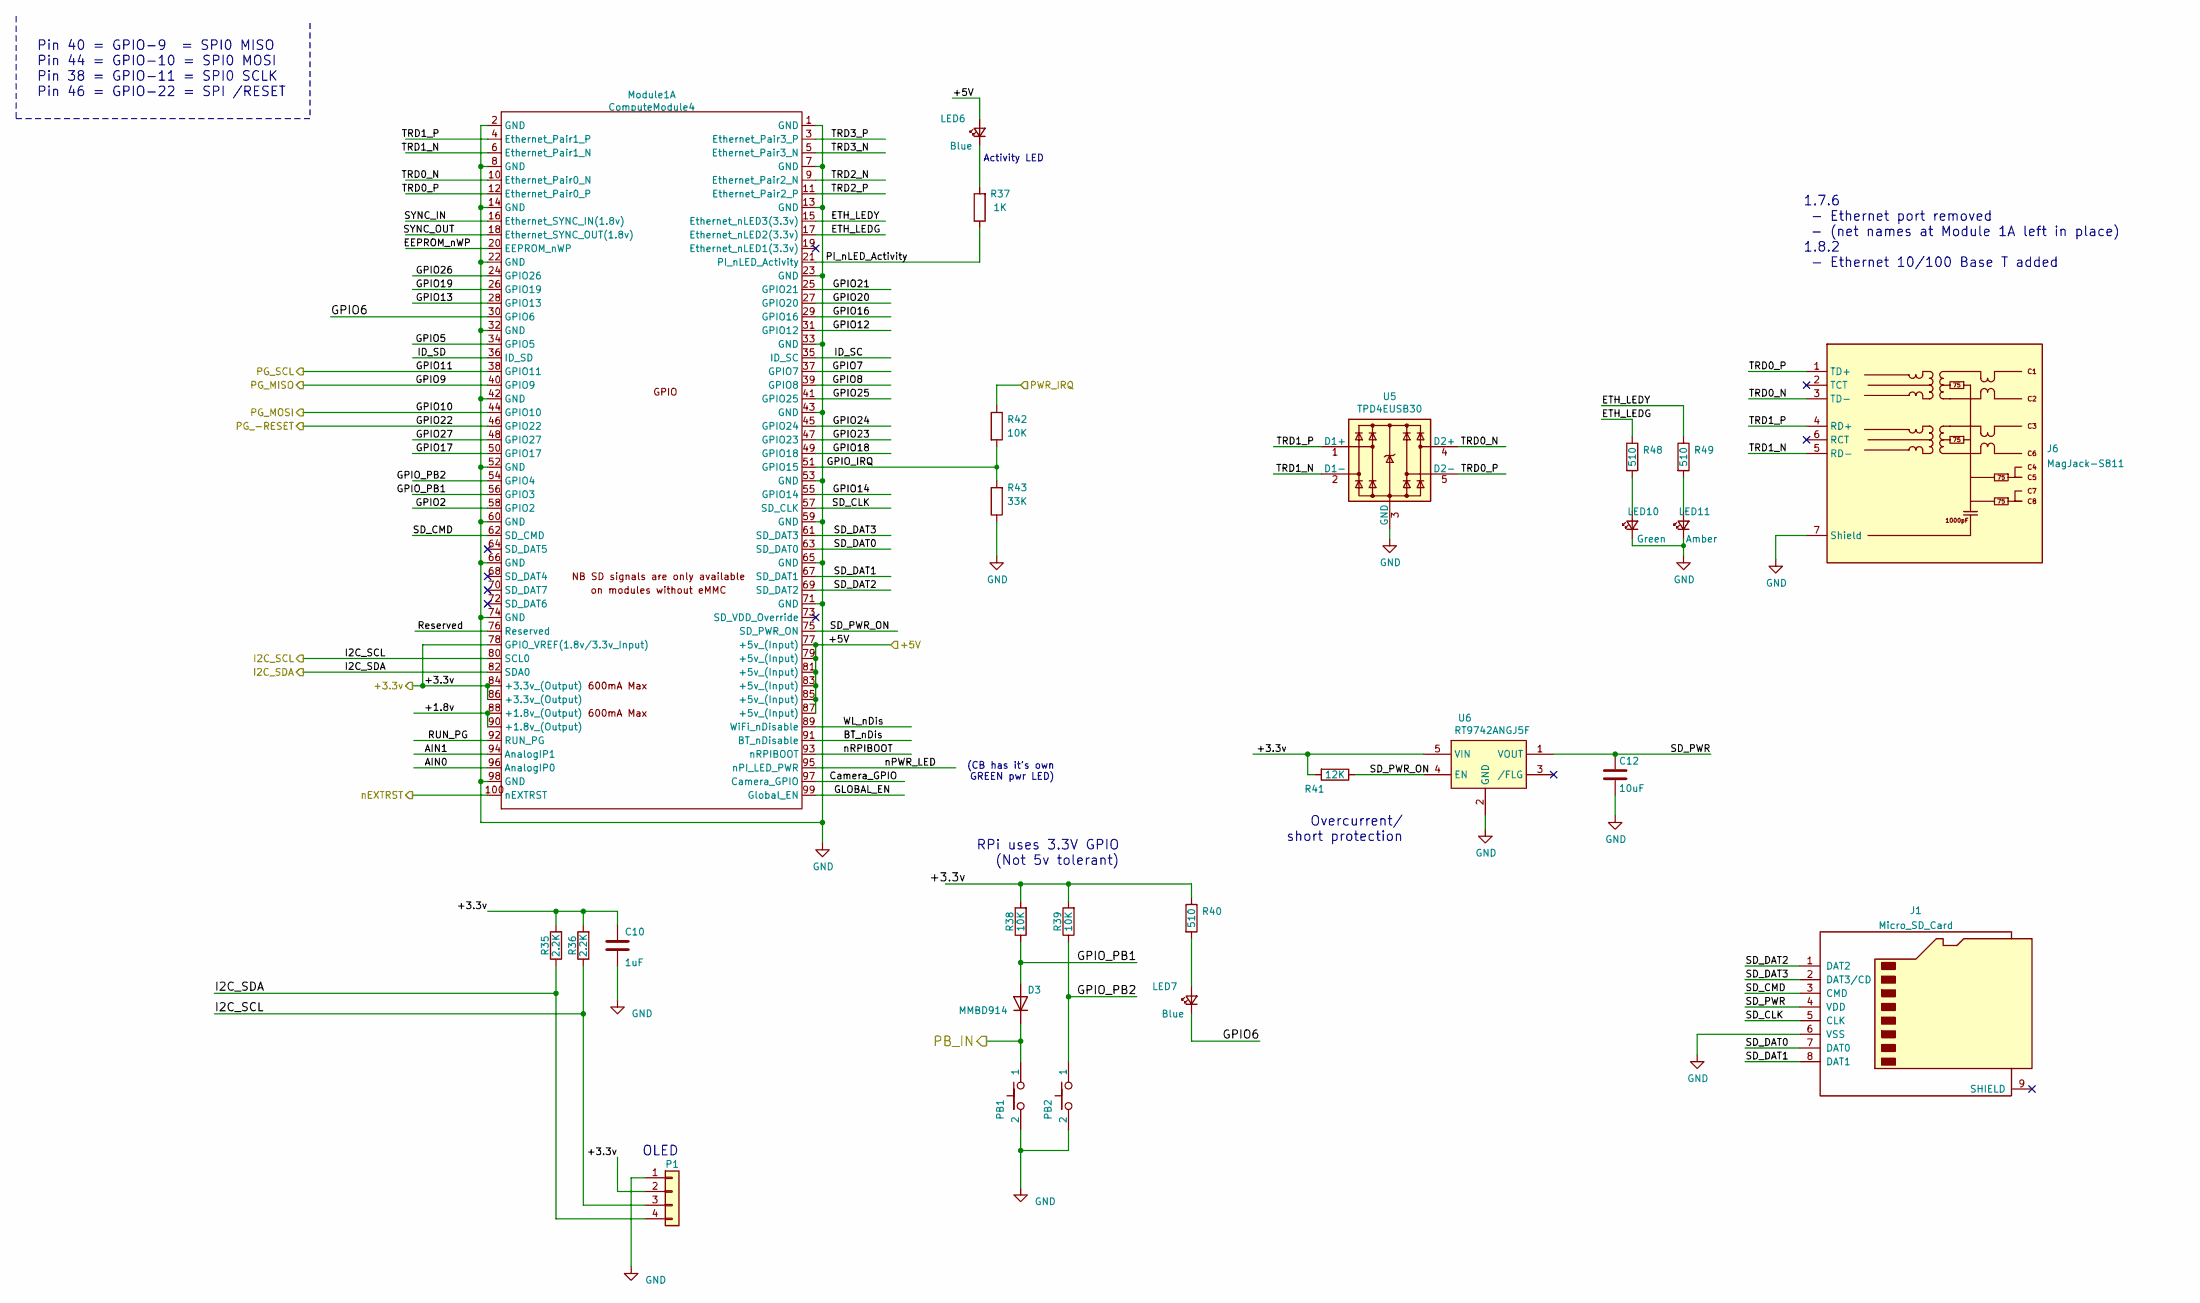
[picture p31: schematic HAT_CM4-CM4-GPIO.kicad_sch, ConnectBox CM4 for China Case]

Parts:
C10: 1uF; C_0603_1608Metric; Manufacturer P/N CL10A105KQ8NNNC‎; DigiKey P/N 1276-1036-1-ND
C12: 10uF; C_0603_1608Metric; Manufacturer P/N C0603C106M9PACTU; DigiKey P/N 399-C0603C106M9PAC7867CT-ND
D3: MMBD914; D_SOT-23_ANK; Manufacturer P/N MMBD914LT1G; DigiKey P/N MMBD914LT1GOSCT-ND
J1: Micro_SD_Card; SDCARD_MOLEX_503398-1892; Manufacturer P/N 5033981892; DigiKey P/N WM11190CT-ND
J6: MagJack-S811; MagJack_S811; Manufacturer P/N S811-1X1T-06-F; DigiKey P/N 507-1456-1-ND
LED6, LED7: Blue; LED_0603_1608Metric; Manufacturer P/N IN-S63BT5B; DigiKey P/N 1830-1068-1-ND
LED10: Green; LED_0603_1608Metric; Manufacturer P/N LTST-C191KFKT; DigiKey P/N 160-1446-1-ND
LED11: Amber; LED_0603_1608Metric; Manufacturer P/N LTST-C191KFKT; DigiKey P/N 160-1445-1-ND
Module1: ComputeModule4; CM4_Module_noHoles; Manufacturer P/N DF40C-100DS-0.4V (requires two each); DigiKey P/N H11615CT-ND (requires two each)
P1: Conn_01x04; PinHeader_1x04_P2.54mm_Vertical
PB1, PB2: SPST-PUSH; SW-TL3330A; Manufacturer P/N TL3330AF130QG; DigiKey P/N EG4388CT-ND
R35, R36: 2.2K; R_0603_1608Metric; Manufacturer P/N RC0603FR-072K2L; DigiKey P/N 311-2.20KHRCT-ND
R37: 1K; R_0603_1608Metric; Manufacturer P/N RC0603FR-071KL; DigiKey P/N 311-1.00KHRCT-ND
R38, R39, R42: 10K; R_0603_1608Metric; Manufacturer P/N RC0603FR-0710KL; DigiKey P/N 311-10.0KHRCT-ND
R40, R48, R49: 510; R_0603_1608Metric; Manufacturer P/N RC0603FR-07510RL; DigiKey P/N 311-510HRCT-ND
R41: 12K; R_0603_1608Metric; Manufacturer P/N RC0603FR-12K2L; DigiKey P/N 311-12.0KHRCT-ND
R43: 33K; R_0603_1608Metric; Manufacturer P/N RC0603FR-0733KL; DigiKey P/N 311-33.0KHRCT-ND
U5: TPD4EUSB30; USON-10_2.5x1.0mm_P0.5mm; Manufacturer P/N TPD4EUSB30DQAR; DigiKey P/N 296-28063-1-ND
U6: RT9742ANGJ5F; SOT-23-5; Manufacturer P/N RT9742ANGJ5F; DigiKey P/N 1028-1427-1-ND

Connections:
+3.3v: C10.1, Module1.78 (GPIO_VREF(1.8v/3.3v_Input)), Module1.84 (+3.3v_(Output)), Module1.86 (+3.3v_(Output)), P1.2, R35.2, R36.2, R38.2, R39.2, R40.1, R41.2, U6.5 (VIN); also elsewhere on the board
+5V: LED6.2 (A), Module1.77 (+5v_(Input)), Module1.79 (+5v_(Input)), Module1.81 (+5v_(Input)), Module1.83 (+5v_(Input)), Module1.85 (+5v_(Input)), Module1.87 (+5v_(Input)); also elsewhere on the board
/Battery/I2C_SCL: Module1.80 (SCL0), P1.3, R36.1; also elsewhere on the board
/Battery/I2C_SDA: Module1.82 (SDA0), P1.4, R35.1; also elsewhere on the board
/Battery/MISO: Module1.40 (GPIO9); also elsewhere on the board
/Battery/MOSI: Module1.44 (GPIO10); also elsewhere on the board
/Battery/PB_IN: D3.1 (K), PB1.1; also elsewhere on the board
/Battery/PWR_IRQ: R42.1; also elsewhere on the board
/Battery/SCL: Module1.38 (GPIO11); also elsewhere on the board
/Battery//RESET: Module1.46 (GPIO22); also elsewhere on the board
/CM4_GPIO/+1.8v: Module1.88 (+1.8v_(Output)), Module1.90 (+1.8v_(Output))
/CM4_GPIO/AIN0: Module1.96 (AnalogIP0)
/CM4_GPIO/AIN1: Module1.94 (AnalogIP1)
/CM4_GPIO/BT_nDis: Module1.91 (BT_nDisable)
/CM4_GPIO/Camera_GPIO: Module1.97 (Camera_GPIO)
/CM4_GPIO/EEPROM_nWP: Module1.20 (EEPROM_nWP)
/CM4_GPIO/ETH_LEDG: Module1.17 (Ethernet_nLED2(3.3v)), R48.1
/CM4_GPIO/ETH_LEDY: Module1.15 (Ethernet_nLED3(3.3v)), R49.1
/CM4_GPIO/GLOBAL_EN: Module1.99 (Global_EN)
/CM4_GPIO/GPIO2: Module1.58 (GPIO2)
/CM4_GPIO/GPIO5: Module1.34 (GPIO5)
/CM4_GPIO/GPIO6: LED7.1 (K), Module1.30 (GPIO6)
/CM4_GPIO/GPIO7: Module1.37 (GPIO7)
/CM4_GPIO/GPIO8: Module1.39 (GPIO8)
/CM4_GPIO/GPIO12: Module1.31 (GPIO12)
/CM4_GPIO/GPIO13: Module1.28 (GPIO13)
/CM4_GPIO/GPIO14: Module1.55 (GPIO14)
/CM4_GPIO/GPIO16: Module1.29 (GPIO16)
/CM4_GPIO/GPIO17: Module1.50 (GPIO17)
/CM4_GPIO/GPIO18: Module1.49 (GPIO18)
/CM4_GPIO/GPIO19: Module1.26 (GPIO19)
/CM4_GPIO/GPIO20: Module1.27 (GPIO20)
/CM4_GPIO/GPIO21: Module1.25 (GPIO21)
/CM4_GPIO/GPIO23: Module1.47 (GPIO23)
/CM4_GPIO/GPIO24: Module1.45 (GPIO24)
/CM4_GPIO/GPIO25: Module1.41 (GPIO25)
/CM4_GPIO/GPIO26: Module1.24 (GPIO26)
/CM4_GPIO/GPIO27: Module1.48 (GPIO27)
/CM4_GPIO/GPIO_IRQ: Module1.51 (GPIO15), R42.2, R43.2
/CM4_GPIO/GPIO_PB1: D3.2 (A), Module1.56 (GPIO3), R38.1
/CM4_GPIO/GPIO_PB2: Module1.54 (GPIO4), PB2.1, R39.1
/CM4_GPIO/ID_SC: Module1.35 (ID_SC)
/CM4_GPIO/ID_SD: Module1.36 (ID_SD)
/CM4_GPIO/PI_nLED_Activity: Module1.21 (PI_nLED_Activity), R37.1
/CM4_GPIO/RUN_PG: Module1.92 (RUN_PG)
/CM4_GPIO/Reserved: Module1.76 (Reserved)
/CM4_GPIO/SD_CLK: J1.5 (CLK), Module1.57 (SD_CLK)
/CM4_GPIO/SD_CMD: J1.3 (CMD), Module1.62 (SD_CMD)
/CM4_GPIO/SD_DAT0: J1.7 (DAT0), Module1.63 (SD_DAT0)
/CM4_GPIO/SD_DAT1: J1.8 (DAT1), Module1.67 (SD_DAT1)
/CM4_GPIO/SD_DAT2: J1.1 (DAT2), Module1.69 (SD_DAT2)
/CM4_GPIO/SD_DAT3: J1.2 (DAT3/CD), Module1.61 (SD_DAT3)
/CM4_GPIO/SD_PWR: C12.1, J1.4 (VDD), U6.1 (VOUT)
/CM4_GPIO/SD_PWR_ON: Module1.75 (SD_PWR_ON), R41.1, U6.4 (EN)
/CM4_GPIO/SYNC_IN: Module1.16 (Ethernet_SYNC_IN(1.8v))
/CM4_GPIO/SYNC_OUT: Module1.18 (Ethernet_SYNC_OUT(1.8v))
/CM4_GPIO/TRD0_N: J6.3 (TD-), Module1.10 (Ethernet_Pair0_N), U5.4 (D2+), U5.7
/CM4_GPIO/TRD0_P: J6.1 (TD+), Module1.12 (Ethernet_Pair0_P), U5.5 (D2-), U5.6
/CM4_GPIO/TRD1_N: J6.5 (RD-), Module1.6 (Ethernet_Pair1_N), U5.2 (D1-), U5.9
/CM4_GPIO/TRD1_P: J6.4 (RD+), Module1.4 (Ethernet_Pair1_P), U5.1 (D1+), U5.10
/CM4_GPIO/TRD2_N: Module1.9 (Ethernet_Pair2_N)
/CM4_GPIO/TRD2_P: Module1.11 (Ethernet_Pair2_P)
/CM4_GPIO/TRD3_N: Module1.5 (Ethernet_Pair3_N)
/CM4_GPIO/TRD3_P: Module1.3 (Ethernet_Pair3_P)
/CM4_GPIO/WL_nDis: Module1.89 (WiFi_nDisable)
/CM4_GPIO/nPWR_LED: Module1.95 (nPI_LED_PWR)
/CM4_GPIO/nRPIBOOT: Module1.93 (nRPIBOOT)
/USB Hub/nEXTRST: Module1.100 (nEXTRST); also elsewhere on the board
GND: C10.2, C12.2, J1.6 (VSS), J6.7 (Shield), LED10.1 (K), LED11.1 (K), Module1.1 (GND), Module1.2 (GND), Module1.7 (GND), Module1.8 (GND), Module1.13 (GND), Module1.14 (GND), Module1.22 (GND), Module1.23 (GND), Module1.32 (GND), Module1.33 (GND), Module1.42 (GND), Module1.43 (GND), Module1.52 (GND), Module1.53 (GND), Module1.59 (GND), Module1.60 (GND), Module1.65 (GND), Module1.66 (GND), Module1.71 (GND), Module1.74 (GND), Module1.98 (GND), P1.1, PB1.2, PB2.2, R43.1, U5.3 (GND), U5.8 (GND), U6.2 (GND); also elsewhere on the board
unnamed: LED6.1 (K), R37.2
unnamed: LED10.2 (A), R48.2
unnamed: LED11.2 (A), R49.2
unnamed: LED7.2 (A), R40.2

Notes on the sheet:
1.7.6 - Ethernet port removed - (net names at Module 1A left in place) 1.8.2 - Ethernet 10/100 Base T added
Pin 40 = GPIO-9 = SPI0 MISO Pin 44 = GPIO-10 = SPI0 MOSI Pin 38 = GPIO-11 = SPI0 SCLK Pin 46 = GPIO-22 = SPI /RESET
RPi uses 3.3V GPIO (Not 5v tolerant)
Overcurrent/ short protection
OLED
Activity LED
(CB has it's own GREEN pwr LED)

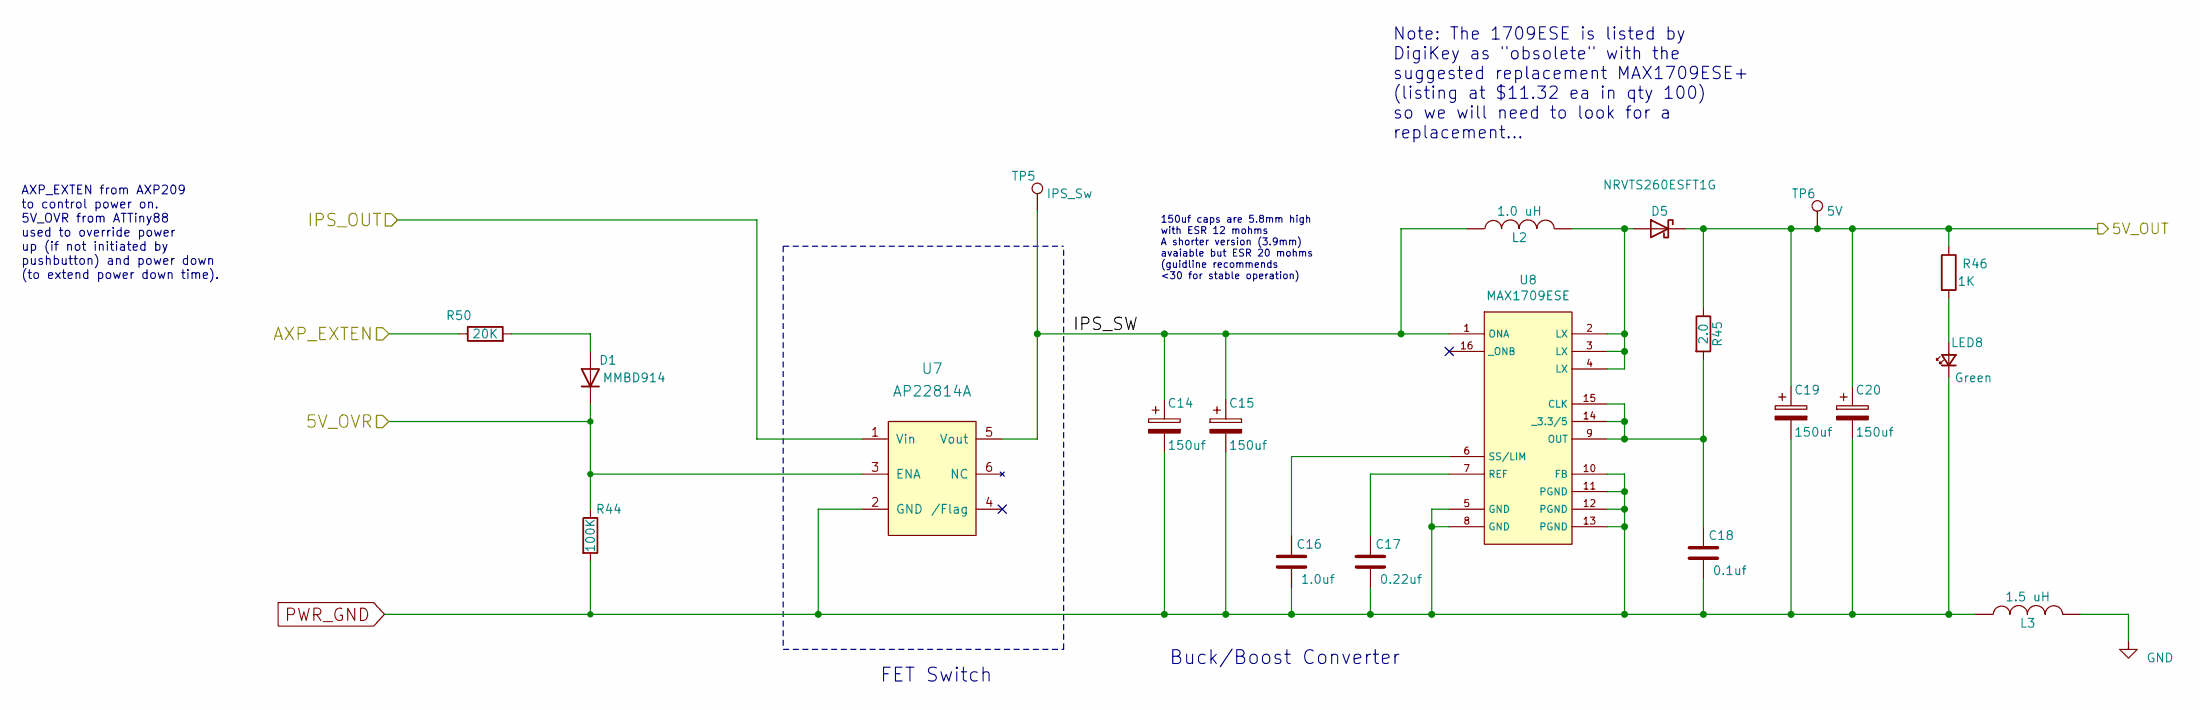
[picture p32: schematic HAT_CM4-Power.kicad_sch, ConnectBox CM4 for China Case]

Parts:
C14, C15, C19, C20: 150uf; CP_Elec_5x3; Manufacturer P/N APXF6R3ARA151ME61G; DigiKey P/N 565-4332-1-ND
C16: 1.0uf; C_0603_1608Metric; Manufacturer P/N C0603C105K9PACTU; DigiKey P/N 399-7848-1-ND
C17: 0.22uf; C_0603_1608Metric; Manufacturer P/N C0603C224K9PAC7867; DigiKey P/N 399-14969-1-ND
C18: 0.1uf; C_0603_1608Metric; Manufacturer P/N C0603C104K9PAC7867; DigiKey P/N 399-17575-1-ND
D1: MMBD914; D_SOT-23_ANK; Manufacturer P/N MMBD914LT1G; DigiKey P/N MMBD914LT1GOSCT-ND
D5: NRVTS260ESFT1G; SOD-123FL; Manufacturer P/N NRVTS260ESFT1G; DigiKey P/N NRVTS260ESFT1GOSCT-ND
L2: 1.0 uH; L_Taiyo-Yuden_NR-50xx; Manufacturer P/N NRS5020T1R5NMGJ; DigiKey P/N 587-2404-1-ND
L3: 1.5 uH; L_Taiyo-Yuden_NR-50xx; Manufacturer P/N NRS5020T1R5NMGJ; DigiKey P/N 587-2404-1-ND
LED8: Green; LED_0603_1608Metric; Manufacturer P/N LTST-C191KFKT; DigiKey P/N 160-1446-1-ND
R44: 100K; R_0603_1608Metric; Manufacturer P/N RC0603FR-07100KL; DigiKey P/N 311-100KHRCT-ND
R45: 2.0; R_0603_1608Metric; Manufacturer P/N RC0603FR-072RL; DigiKey P/N 311-2.00HRCT-ND
R46: 1K; R_0603_1608Metric; Manufacturer P/N RC0603FR-071KL; DigiKey P/N 311-1.00KHRCT-ND
R50: 20K; R_0603_1608Metric; Manufacturer P/N RC0603FR-0720KL; DigiKey P/N 311-20.0KHRCT-ND
TP5: IPS_Sw; TestPoint_THTPad_D1.5mm_Drill0.7mm
TP6: 5V; TestPoint_THTPad_D1.5mm_Drill0.7mm
U7: AP22814A; U-DFN2020-6; Manufacturer P/N AP22814ASN-7; DigiKey P/N AP22814ASN-7DICT-ND
U8: MAX1709ESE; SOP-16_3.9x9.9mm_P1.27mm; Manufacturer P/N MAX1709ESE; DigiKey P/N [none - from AliExpress]

Connections:
+5V: C19.1, C20.1, D5.1 (K), R45.1, R46.1, TP6.1; also elsewhere on the board
/Battery/5V_OVR: D1.1 (K), R44.1, U7.3 (ENA); also elsewhere on the board
/Battery/AXP_EXTEN: R50.1; also elsewhere on the board
/Charger/IPS_OUT: U7.1 (Vin); also elsewhere on the board
/Power/IPS_SW: C14.1, C15.1, L2.1, TP5.1, U7.5 (Vout), U8.1 (ONA)
GND: L3.2; also elsewhere on the board
unnamed: C16.1, U8.6 (SS/LIM)
unnamed: C17.1, U8.7 (REF)
unnamed: C18.1, R45.2, U8.9 (OUT), U8.14 (_3.3/5), U8.15 (CLK)
unnamed: D1.2 (A), R50.2
unnamed: D5.2 (A), L2.2, U8.2 (LX), U8.3 (LX), U8.4 (LX)
unnamed: LED8.2 (A), R46.2
PWR_GND: C14.2, C15.2, C16.2, C17.2, C18.2, C19.2, C20.2, L3.1, LED8.1 (K), R44.2, U7.2 (GND), U8.5 (GND), U8.8 (GND), U8.10 (FB), U8.11 (PGND), U8.12 (PGND), U8.13 (PGND); also elsewhere on the board

Notes on the sheet:
150uf caps are 5.8mm high with ESR 12 mohms A shorter version (3.9mm) avaiable but ESR 20 mohms (guidline recommends <30 for stable operation)
Buck/Boost Converter
AXP_EXTEN from AXP209 to control power on. 5V_OVR from ATTiny88 used to override power up (if not initiated by pushbutton) and power down (to extend power down time).
Note: The 1709ESE is listed by DigiKey as "obsolete" with the suggested replacement MAX1709ESE+ (listing at $11.32 ea in qty 100) so we will need to look for a replacement...
FET Switch

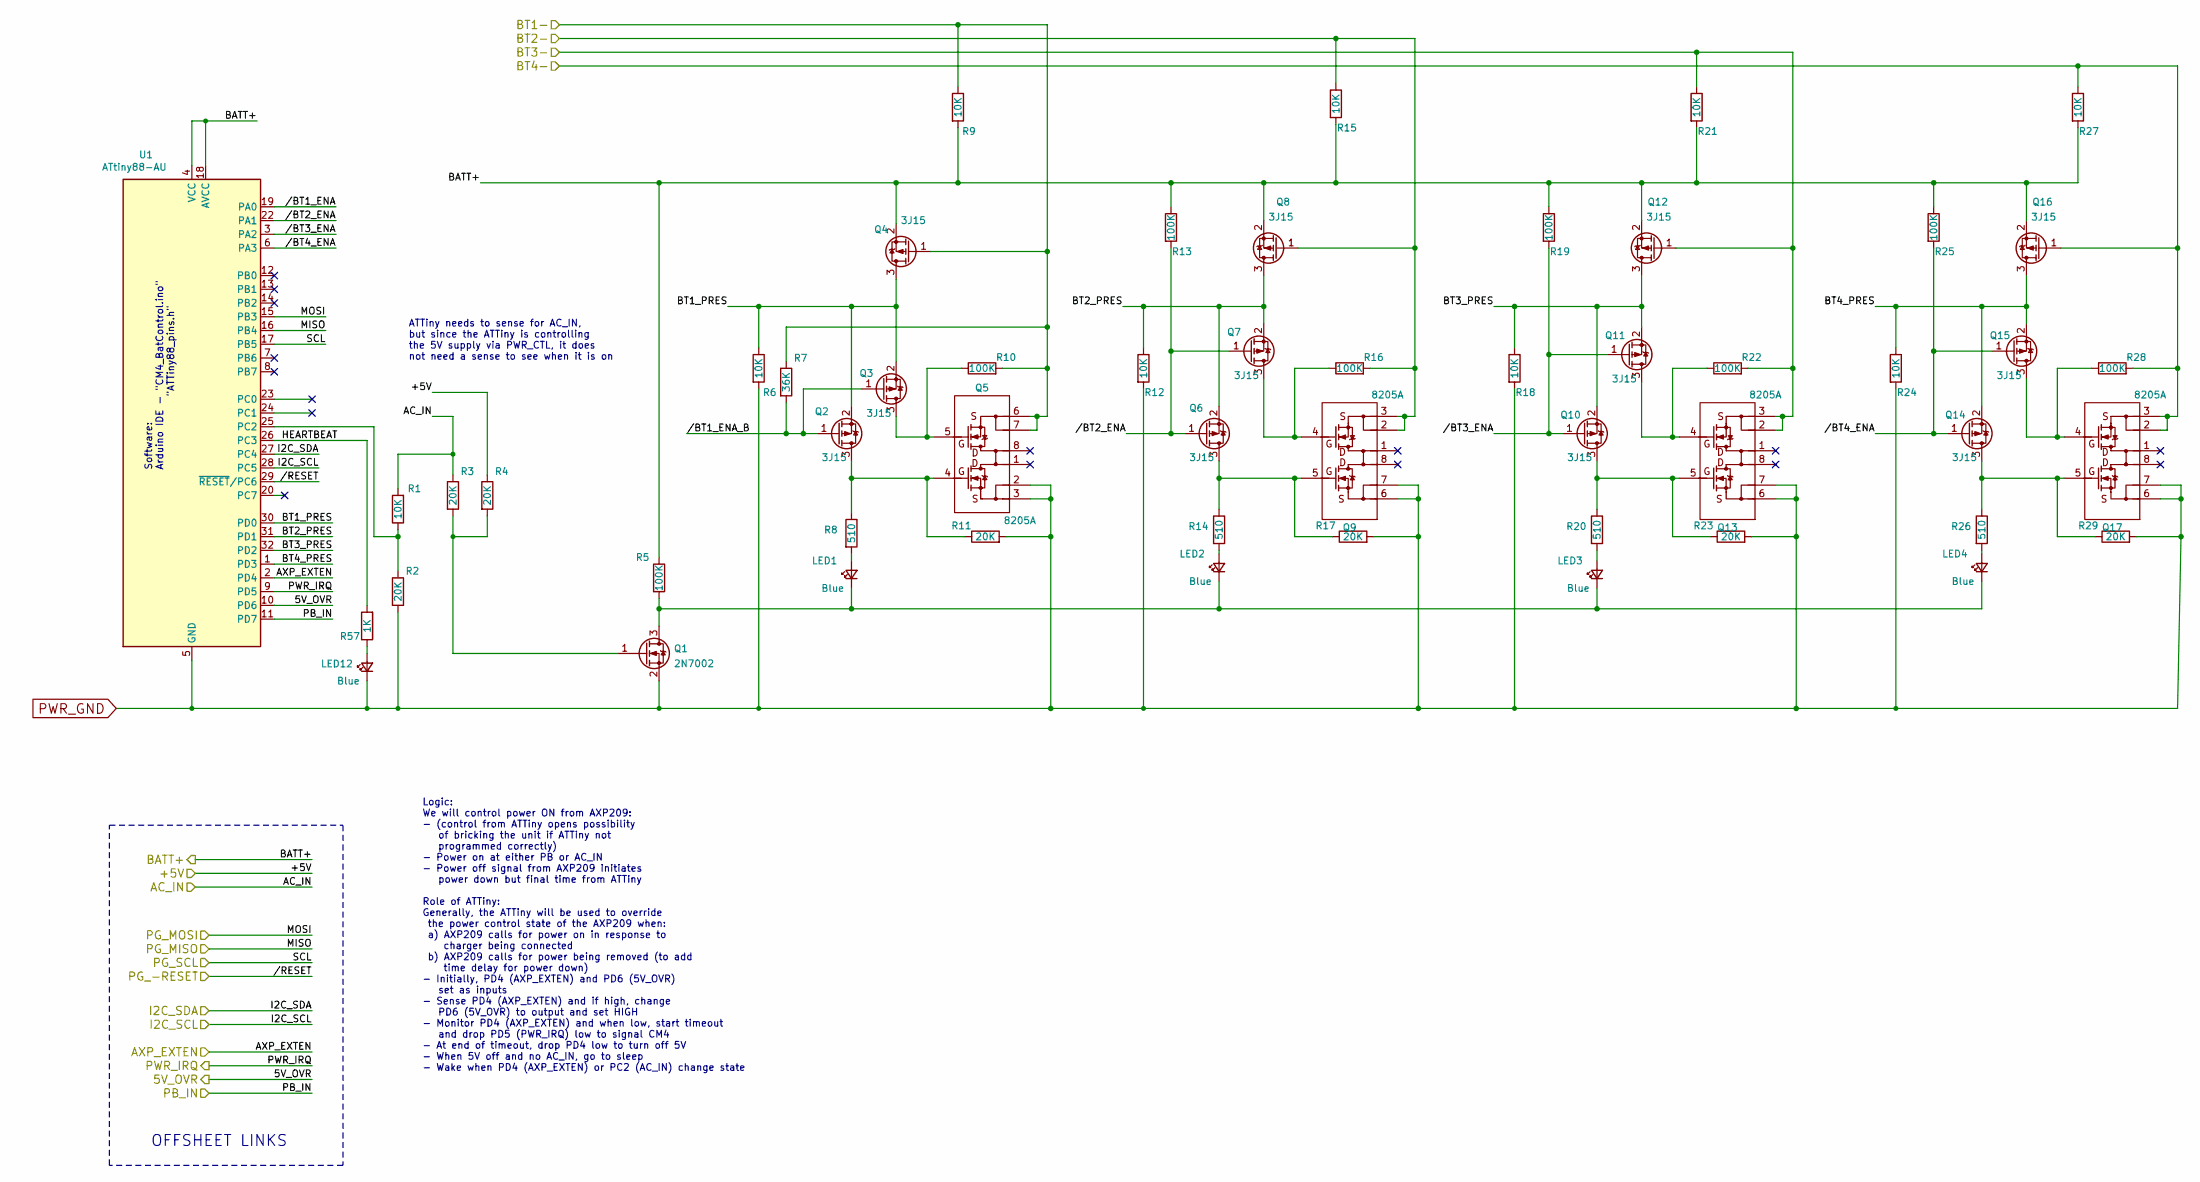
[picture p33: schematic CM4_BattBoard-Battery.kicad_sch, ConnectBox CM4 for China Case]

Parts:
LED1, LED2, LED3, LED4: Blue; LED_0603_1608Metric; Manufacturer P/N LTST-S270TBKT; DigiKey P/N 160-1650-1-ND
LED12: Blue; LED_0603_1608Metric; Manufacturer P/N IN-S63BT5B; DigiKey P/N 1830-1068-1-ND
Q1: 2N7002; SOT-23; Manufacturer P/N T2N7002BK,LM; DigiKey P/N T2N7002BKLMCT-ND (alt: T2N7002AKLMCT-ND)
Q2, Q3, Q4, Q6, Q7, Q8, Q10, Q11, Q12, Q14, Q15, Q16: 3J15; SOT-323_SC-70; Manufacturer P/N SSM3J15FU,LF; DigiKey P/N SSM3J15FULFCT-ND
Q5, Q9, Q13, Q17: 8205A; TSSOP-8_4.4x3mm_P0.65mm; DigiKey P/N [none - from AliExpress|
R1: 10K; R_0603_1608Metric; Manufacturer P/N RC0603FR-0710KL; DigiKey P/N 311-10.0KHRCT-ND
R2, R3, R4, R11, R17, R23, R29: 20K; R_0603_1608Metric; Manufacturer P/N RC0603FR-0720KL; DigiKey P/N 311-20.0KHRCT-ND
R5, R10, R13, R16, R19, R22, R25, R28: 100K; R_0603_1608Metric; Manufacturer P/N RC0603FR-07100KL; DigiKey P/N 311-100KHRCT-ND
R6, R9, R12, R15, R18, R21, R24, R27: 10K; R_0603_1608Metric; Manufacturer P/N RC0603FR-0710KL; DigiKey P/N 311-10KHRCT-ND
R7: 36K; R_0603_1608Metric; Manufacturer P/N RC0603FR-0736KL; DigiKey P/N 311-36.0KHRCT-ND
R8, R14, R20, R26: 510; R_0603_1608Metric; Manufacturer P/N RC0603FR-07510RL; DigiKey P/N 311-510HRCT-ND
R57: 1K; R_0603_1608Metric; Manufacturer P/N RC0603FR-071KL; DigiKey P/N 311-1.00KHRCT-ND
U1: ATtiny88-AU; TQFP-32_7x7mm_P0.8mm; Manufacturer P/N ATTINY88-AU; DigiKey P/N ATTINY88-AU-ND

Connections:
+5V: R4.1; also elsewhere on the board
/AC_IN: R1.2, R3.1; also elsewhere on the board
/Batteries/BT1-: Q4.1 (G), Q5.6 (S2), Q5.7 (S2), R7.1, R9.1, R10.2; also elsewhere on the board
/Batteries/BT2-: Q8.1 (G), Q9.2 (S1), Q9.3 (S1), R15.1, R16.2; also elsewhere on the board
/Batteries/BT3-: Q12.1 (G), Q13.2 (S1), Q13.3 (S1), R21.1, R22.2; also elsewhere on the board
/Batteries/BT4-: Q16.1 (G), Q17.2 (S1), Q17.3 (S1), R27.1, R28.2; also elsewhere on the board
/Battery/5V_OVR: U1.10 (PD6); also elsewhere on the board
/Battery/AXP_EXTEN: U1.2 (PD4); also elsewhere on the board
/Battery/BATT+: Q4.2 (S), Q8.2 (S), Q12.2 (S), Q16.2 (S), R5.1, R9.2, R13.1, R15.2, R19.1, R21.2, R25.1, R27.2, U1.4 (VCC), U1.18 (AVCC); also elsewhere on the board
/Battery/BT1_PRES: Q2.2 (S), Q3.2 (S), Q4.3 (D), R6.1, U1.30 (PD0)
/Battery/BT2_PRES: Q6.2 (S), Q7.2 (S), Q8.3 (D), R12.1, U1.31 (PD1)
/Battery/BT3_PRES: Q10.2 (S), Q11.2 (S), Q12.3 (D), R18.1, U1.32 (PD2)
/Battery/BT4_PRES: Q14.2 (S), Q15.2 (S), Q16.3 (D), R24.1, U1.1 (PD3)
/Battery/HEARTBEAT: R57.2, U1.26 (PC3)
/Battery/I2C_SCL: U1.28 (PC5); also elsewhere on the board
/Battery/I2C_SDA: U1.27 (PC4); also elsewhere on the board
/Battery/MISO: U1.16 (PB4); also elsewhere on the board
/Battery/MOSI: U1.15 (PB3); also elsewhere on the board
/Battery/PB_IN: U1.11 (PD7); also elsewhere on the board
/Battery/PWR_IRQ: U1.9 (PD5); also elsewhere on the board
/Battery/SCL: U1.17 (PB5); also elsewhere on the board
/Battery//BT1_ENA: U1.19 (PA0)
/Battery//BT1_ENA_B: Q2.1 (G), Q3.1 (G), R7.2
/Battery//BT2_ENA: Q6.1 (G), Q7.1 (G), R13.2, U1.22 (PA1)
/Battery//BT3_ENA: Q10.1 (G), Q11.1 (G), R19.2, U1.3 (PA2)
/Battery//BT4_ENA: Q14.1 (G), Q15.1 (G), R25.2, U1.6 (PA3)
/Battery//RESET: U1.29 (~RESET/PC6); also elsewhere on the board
unnamed: LED1.1 (K), LED2.1 (K), LED3.1 (K), LED4.1 (K), Q1.3 (D), R5.2
unnamed: LED1.2 (A), R8.2
unnamed: LED2.2 (A), R14.2
unnamed: LED3.2 (A), R20.2
unnamed: LED4.2 (A), R26.2
unnamed: LED12.2 (A), R57.1
unnamed: Q1.1 (G), R3.2, R4.2
unnamed: Q2.3 (D), Q5.4 (G1), R8.1, R11.1
unnamed: Q3.3 (D), Q5.5 (G2), R10.1
unnamed: Q6.3 (D), Q9.5 (G2), R14.1, R17.1
unnamed: Q7.3 (D), Q9.4 (G1), R16.1
unnamed: Q10.3 (D), Q13.5 (G2), R20.1, R23.1
unnamed: Q11.3 (D), Q13.4 (G1), R22.1
unnamed: Q14.3 (D), Q17.5 (G2), R26.1, R29.1
unnamed: Q15.3 (D), Q17.4 (G1), R28.1
unnamed: R1.1, R2.1, U1.25 (PC2)
PWR_GND: LED12.1 (K), Q1.2 (S), Q5.2 (S1), Q5.3 (S1), Q9.6 (S2), Q9.7 (S2), Q13.6 (S2), Q13.7 (S2), Q17.6 (S2), Q17.7 (S2), R2.2, R6.2, R11.2, R12.2, R17.2, R18.2, R23.2, R24.2, R29.2, U1.5 (GND), U1.21 (GND); also elsewhere on the board

Notes on the sheet:
Logic: We will control power ON from AXP209: - (control from ATTiny opens possibility of bricking the unit if ATTiny not programmed correctly) - Power on at either PB or AC_IN - Power off signal from AXP209 initiates power down but final time from ATTiny Role of ATTiny: Generally, the ATTiny will b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
Software: Arduino IDE - "CM4_BatControl.ino" "ATTiny88_pins.h"
ATTiny needs to sense for AC_IN, but since the ATTiny is controlling the 5V supply via PWR_CTL, it does not need a sense to see when it is on
OFFSHEET LINKS

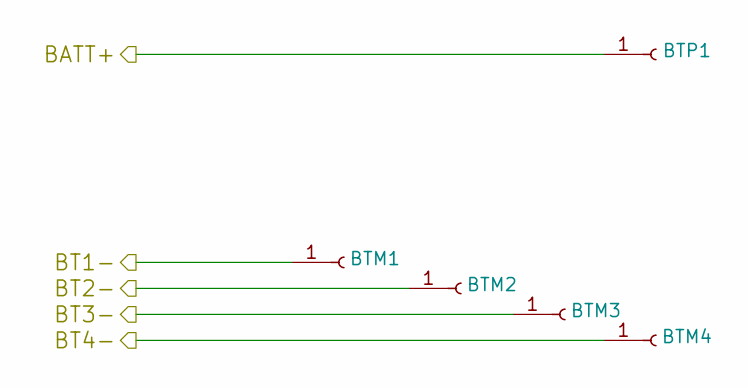
[picture p34: schematic CM4-Batteries.kicad_sch, ConnectBox CM4 for China Case]

Parts:
BTM1, BTM2, BTM3, BTM4: Conn_01x01_Female; WH-Battery-
BTP1: Conn_01x01_Female; TestPoint_THTPad_2.0x2.0mm_Drill1.0mm

Connections:
/Batteries/BT1-: BTM1.1; also elsewhere on the board
/Batteries/BT2-: BTM2.1; also elsewhere on the board
/Batteries/BT3-: BTM3.1; also elsewhere on the board
/Batteries/BT4-: BTM4.1; also elsewhere on the board
/Battery/BATT+: BTP1.1; also elsewhere on the board

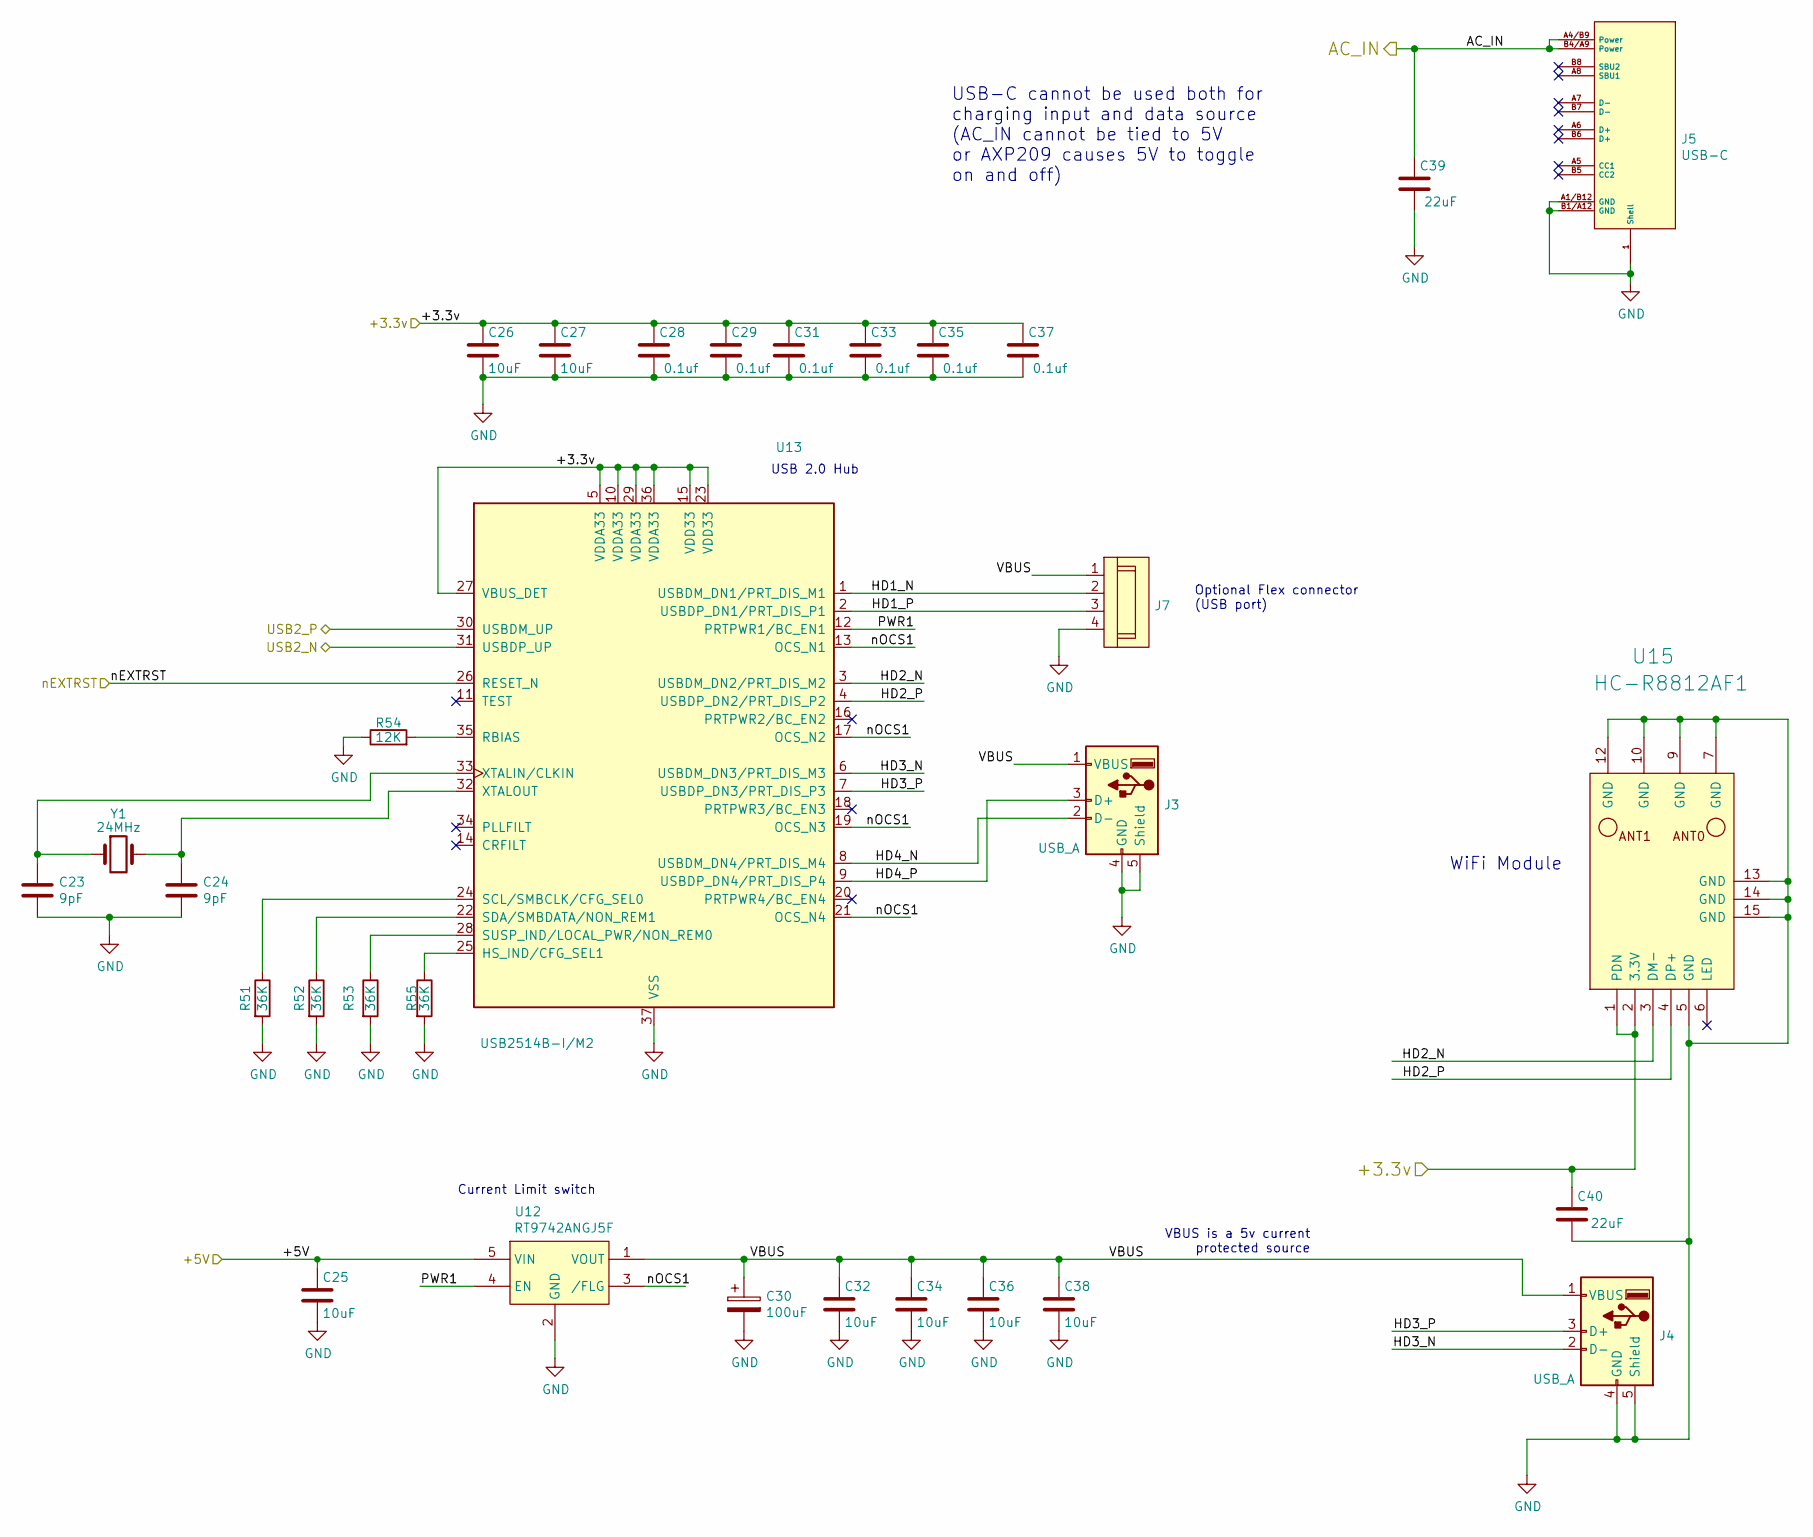
[picture p35: schematic HAT_CM4-USB_Hub.kicad_sch, ConnectBox CM4 for China Case]

Parts:
C23, C24: 9pF; C_0603_1608Metric; Manufacturer P/N CGA3E2C0G1H090D080AA; DigiKey P/N 445-5627-1-ND
C25, C26, C27, C32, C34, C36, C38: 10uF; C_0603_1608Metric; Manufacturer P/N C0603C106M9PACTU; DigiKey P/N 399-C0603C106M9PAC7867CT-ND
C28, C29, C31, C33, C35, C37: 0.1uf; C_0603_1608Metric; Manufacturer P/N C0603C104K9PAC7867; DigiKey P/N 399-17575-1-ND
C30: 100uF; CP_Elec_5x3; Manufacturer P/N APXF6R3ARA151ME61G; DigiKey P/N 565-4332-1-ND
C39, C40: 22uF; C_0603_1608Metric; Manufacturer P/N CL10A226MQ8NRNC; DigiKey P/N 1276-1193-1-ND
J3, J4: USB_A; USB_A_CUI_smd; Manufacturer P/N UJ2-AH-1-SMT-TR; DigiKey P/N 102-4133-1-ND
J5: USB-C; USB-C-GCT; Manufacturer P/N USB4105-GF-A; DigiKey P/N 2073-USB4105-GF-ACT-ND
J7: Flex-4; SFW4R-1; Manufacturer P/N SFW4R; DigiKey P/N 609-SFW4R-1STE1HLFCT-ND
R51, R52, R53, R55: 36K; R_0603_1608Metric; Manufacturer P/N RC0603FR-0736KL; DigiKey P/N 311-36.0KHRCT-ND
R54: 12K; R_0603_1608Metric; Manufacturer P/N RC0603FR-0712KL; DigiKey P/N 311-12.0KHRCT-ND
U12: RT9742ANGJ5F; SOT-23-5; Manufacturer P/N RT9742ANGJ5F; DigiKey P/N 1028-1427-1-ND
U13: USB2514B-I/M2; QFN-36-1EP_6x6mm_P0.5mm_EP3.7x3.7mm; Manufacturer P/N USB2514B-I/M2; DigiKey P/N USB2514B/M2-ND
U15: HC-R8812AF1; HC-R8812AU2; DigiKey P/N [none - see Kirk for order details]
Y1: 24MHz; Crystal_SMD_HC49-SD; Manufacturer P/N QCS24.0000F18B23M; DigiKey P/N Newark: 2508493

Connections:
+3.3v: C26.1, C27.1, C28.1, C29.1, C31.1, C33.1, C35.1, C37.1, C40.1, U13.5 (VDDA33), U13.10 (VDDA33), U13.15 (VDD33), U13.23 (VDD33), U13.27 (VBUS_DET), U13.29 (VDDA33), U13.36 (VDDA33), U15.1 (PDN), U15.2 (3.3V); also elsewhere on the board
+5V: C25.1, U12.5 (VIN); also elsewhere on the board
/AC_IN: C39.1, J5.A4/B9 (Power), J5.B4/A9 (Power); also elsewhere on the board
/CM4_HighSpeed/USB2_N: U13.31 (USBDP_UP); also elsewhere on the board
/CM4_HighSpeed/USB2_P: U13.30 (USBDM_UP); also elsewhere on the board
/USB Hub/HD1_N: J7.2, U13.1 (USBDM_DN1/PRT_DIS_M1)
/USB Hub/HD1_P: J7.3, U13.2 (USBDP_DN1/PRT_DIS_P1)
/USB Hub/HD2_N: U13.3 (USBDM_DN2/PRT_DIS_M2), U15.3 (DM-)
/USB Hub/HD2_P: U13.4 (USBDP_DN2/PRT_DIS_P2), U15.4 (DP+)
/USB Hub/HD3_N: J4.2 (D-), U13.6 (USBDM_DN3/PRT_DIS_M3)
/USB Hub/HD3_P: J4.3 (D+), U13.7 (USBDP_DN3/PRT_DIS_P3)
/USB Hub/HD4_N: J3.2 (D-), U13.8 (USBDM_DN4/PRT_DIS_M4)
/USB Hub/HD4_P: J3.3 (D+), U13.9 (USBDP_DN4/PRT_DIS_P4)
/USB Hub/PWR1: U12.4 (EN), U13.12 (PRTPWR1/BC_EN1)
/USB Hub/VBUS: C30.1, C32.1, C34.1, C36.1, C38.1, J3.1 (VBUS), J4.1 (VBUS), J7.1, U12.1 (VOUT)
/USB Hub/nEXTRST: U13.26 (RESET_N); also elsewhere on the board
/USB Hub/nOCS1: U12.3 (/FLG), U13.13 (OCS_N1), U13.17 (OCS_N2), U13.19 (OCS_N3), U13.21 (OCS_N4)
GND: C23.2, C24.2, C25.2, C26.2, C27.2, C28.2, C29.2, C30.2, C31.2, C32.2, C33.2, C34.2, C35.2, C36.2, C37.2, C38.2, C39.2, C40.2, J3.4 (GND), J3.5 (Shield), J4.4 (GND), J4.5 (Shield), J5.1 (Shell), J5.A1/B12 (GND), J5.B1/A12 (GND), J7.4, R51.2, R52.2, R53.2, R54.1, R55.2, U12.2 (GND), U13.37 (VSS), U15.5 (GND), U15.7 (GND), U15.9 (GND), U15.10 (GND), U15.12 (GND), U15.13 (GND), U15.14 (GND), U15.15 (GND); also elsewhere on the board
unnamed: C23.1, U13.33 (XTALIN/CLKIN), Y1.1
unnamed: C24.1, U13.32 (XTALOUT), Y1.2
unnamed: R51.1, U13.24 (SCL/SMBCLK/CFG_SEL0)
unnamed: R52.1, U13.22 (SDA/SMBDATA/NON_REM1)
unnamed: R53.1, U13.28 (SUSP_IND/LOCAL_PWR/NON_REM0)
unnamed: R54.2, U13.35 (RBIAS)
unnamed: R55.1, U13.25 (HS_IND/CFG_SEL1)

Notes on the sheet:
Current Limit switch
USB-C cannot be used both for charging input and data source (AC_IN cannot be tied to 5V or AXP209 causes 5V to toggle on and off)
Optional Flex connector (USB port)
USB 2.0 Hub
VBUS is a 5v current protected source
WiFi Module
