ConnectBox/Circuit-Design/Hat 8.3.1/HATB_ver_8.3.1/HATB_ver_8.3.1.kicad_pcb

## KiCad design Hat 2.0/HAT_CM4_183_041022-V2.1/HAT_CM4_183.kicad_pcb (continued)

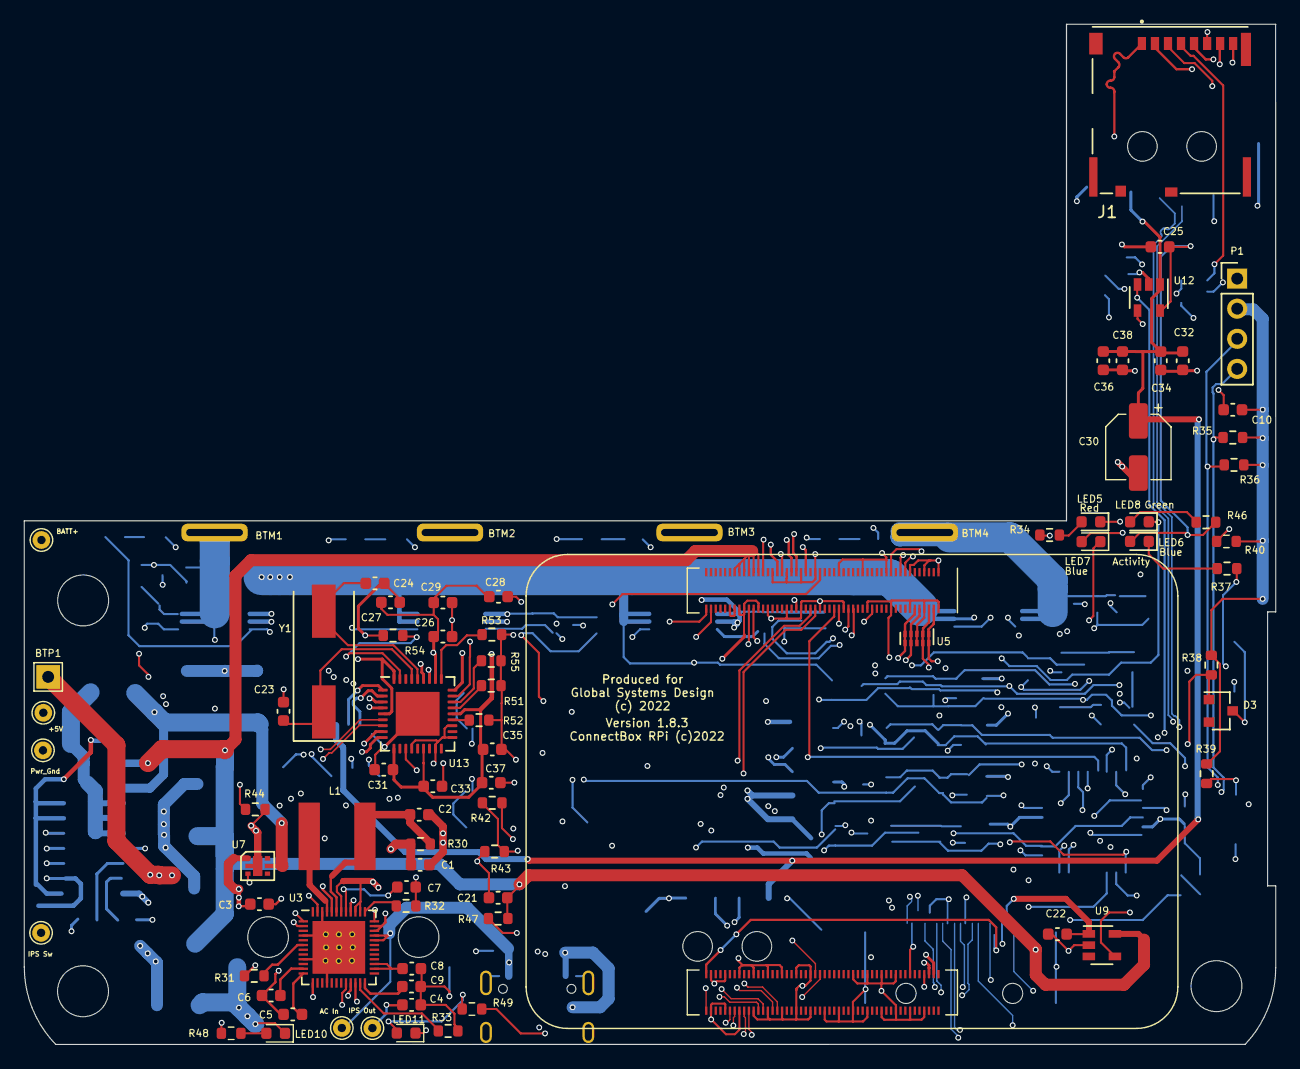
[picture p36: board HAT_CM4_183.kicad_pcb from above]

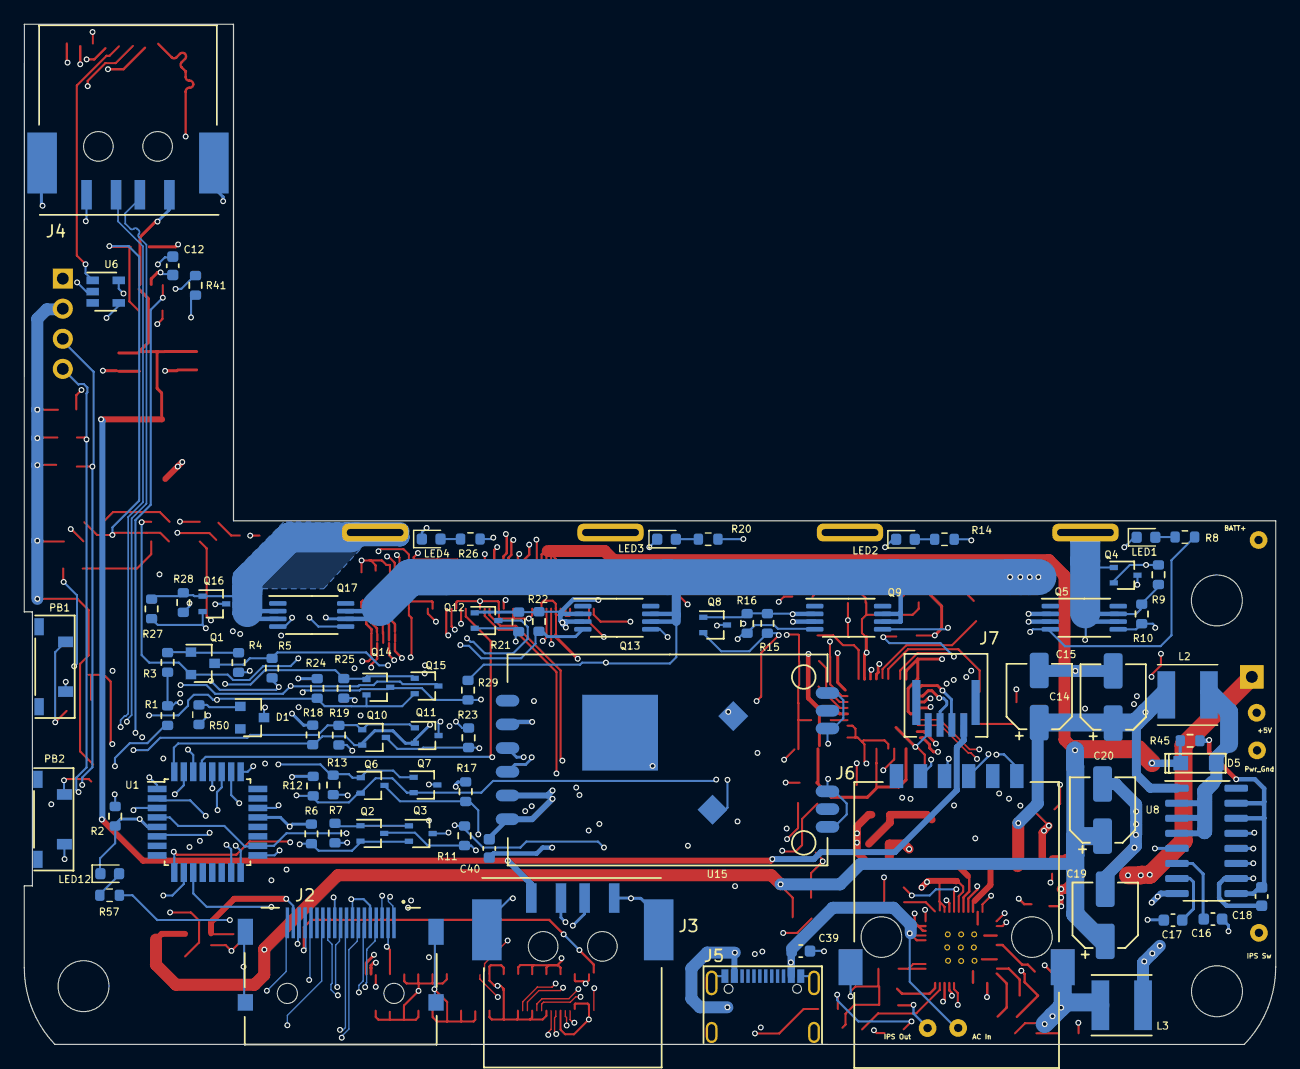
[picture p37: board HAT_CM4_183.kicad_pcb from below]

Board: 6 copper layers, 105.6 x 86.1 mm, 164 parts (81 on the bottom side), 124 nets.
