ConnectBox/Circuit-Design/Hat 8.0/HATB_ver_8_041323/HATB_ver_8.kicad_pcb

## KiCad design Hat 8.0/HATB_ver_8_041323/HATB_ver_8.kicad_pcb (2023-06-06)

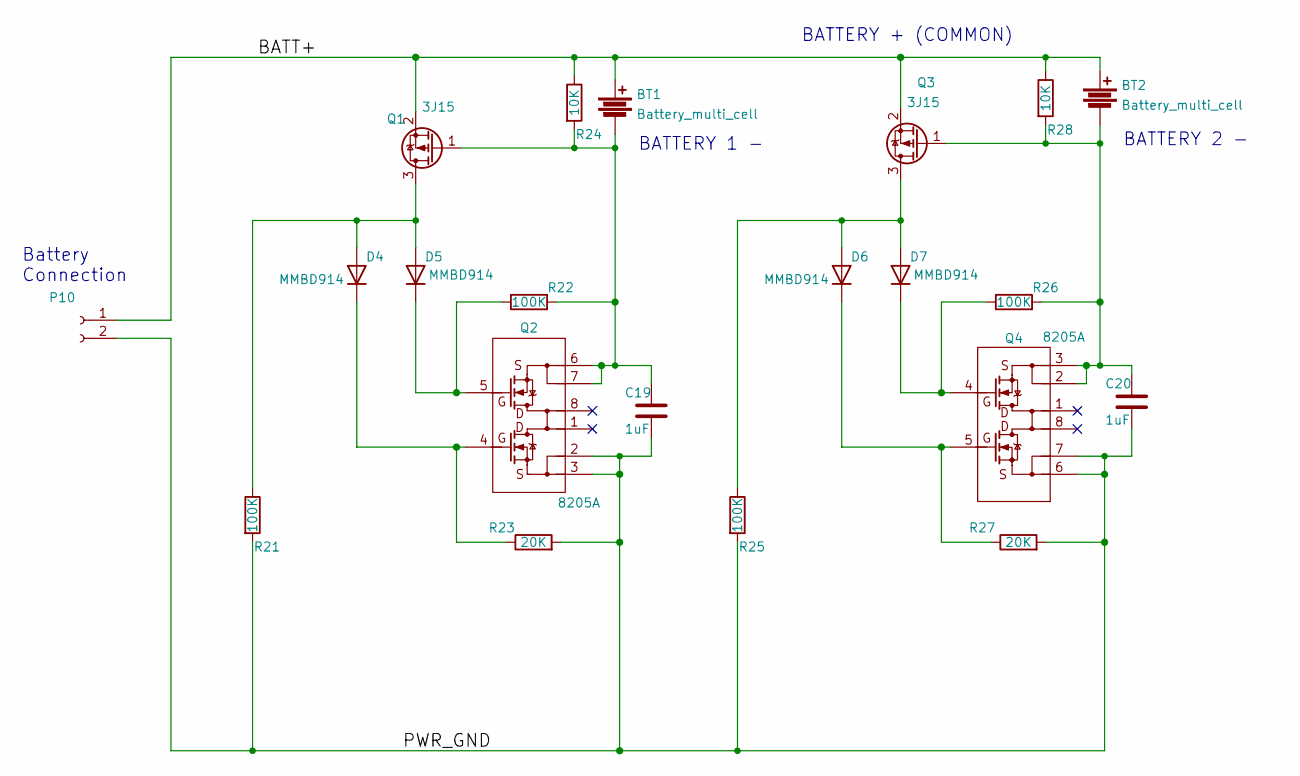
[picture p38: schematic HATB_ver_8.kicad_sch, ConnectBox HAT 8 Battery Board]

Parts:
BT1, BT2: Battery_multi_cell; Battery 21700
C19, C20: 1uF; C_0805_2012Metric; Manufacturer P/N C0805C105K8PACTU; DigiKey P/N 399-8006-1-ND
D4, D5, D6, D7: MMBD914; D_SOT-23_ANK; Manufacturer P/N MMBD914LT1G; DigiKey P/N MMBD914LT1GOSCT-ND
P10: Conn_01x02_Female; PinSocket_1x02_P2.54mm_Vertical
Q1, Q3: 3J15; SOT-323_SC-70; Manufacturer P/N SSM3J15FU,LF; DigiKey P/N SSM3J15FULFCT-ND
Q2, Q4: 8205A; TSSOP-8_4.4x3mm_P0.65mm; DigiKey P/N [none - from AliExpress|
R21, R22, R25, R26: 100K; R_0603_1608Metric; Manufacturer P/N RC0603FR-07100KL; DigiKey P/N 311-100KHRCT-ND
R23, R27: 20K; R_0603_1608Metric; Manufacturer P/N RC0603FR-0720KL; DigiKey P/N 311-20.0KHRCT-ND
R24, R28: 10K; R_0603_1608Metric; Manufacturer P/N RC0603FR-0710KL; DigiKey P/N 311-10KHRCT-ND

Connections:
/BATT+: BT1.1, BT2.1, P10.1, Q1.2 (S), Q3.2 (S), R24.1, R28.1
/PWR_GND: C19.2, C20.2, P10.2, Q2.2 (S1), Q2.3 (S1), Q4.6 (S2), Q4.7 (S2), R21.2, R23.2, R25.2, R27.2
unnamed: BT1.2, C19.1, Q1.1 (G), Q2.6 (S2), Q2.7 (S2), R22.2, R24.2
unnamed: BT2.2, C20.1, Q3.1 (G), Q4.2 (S1), Q4.3 (S1), R26.2, R28.2
unnamed: D4.1 (K), Q2.4 (G1), R23.1
unnamed: D4.2 (A), D5.2 (A), Q1.3 (D), R21.1
unnamed: D5.1 (K), Q2.5 (G2), R22.1
unnamed: D6.1 (K), Q4.5 (G2), R27.1
unnamed: D6.2 (A), D7.2 (A), Q3.3 (D), R25.1
unnamed: D7.1 (K), Q4.4 (G1), R26.1

Notes on the sheet:
BATTERY + (COMMON)
BATTERY 1 -
Battery Connection
BATTERY 2 -

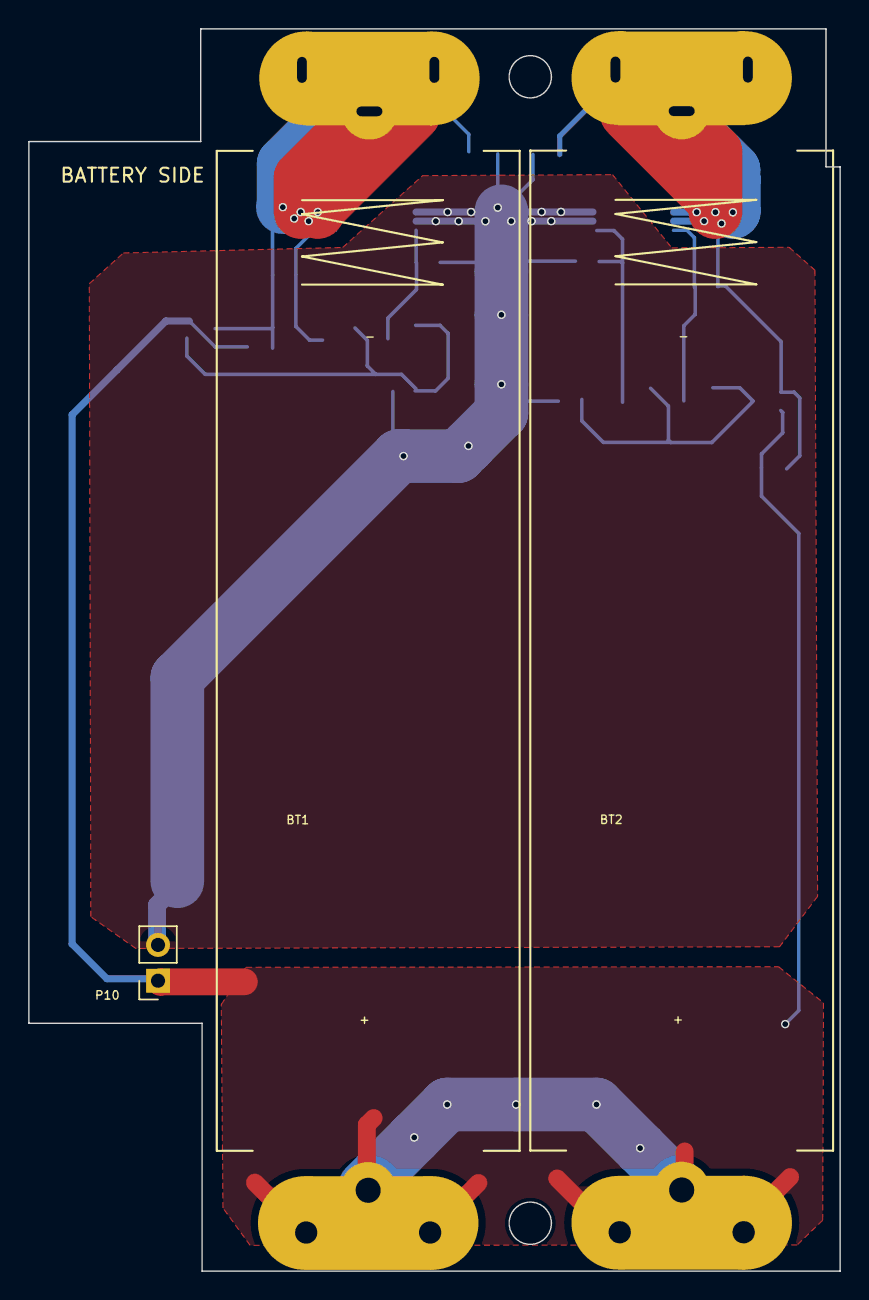
[picture p39: board HATB_ver_8.kicad_pcb from above]

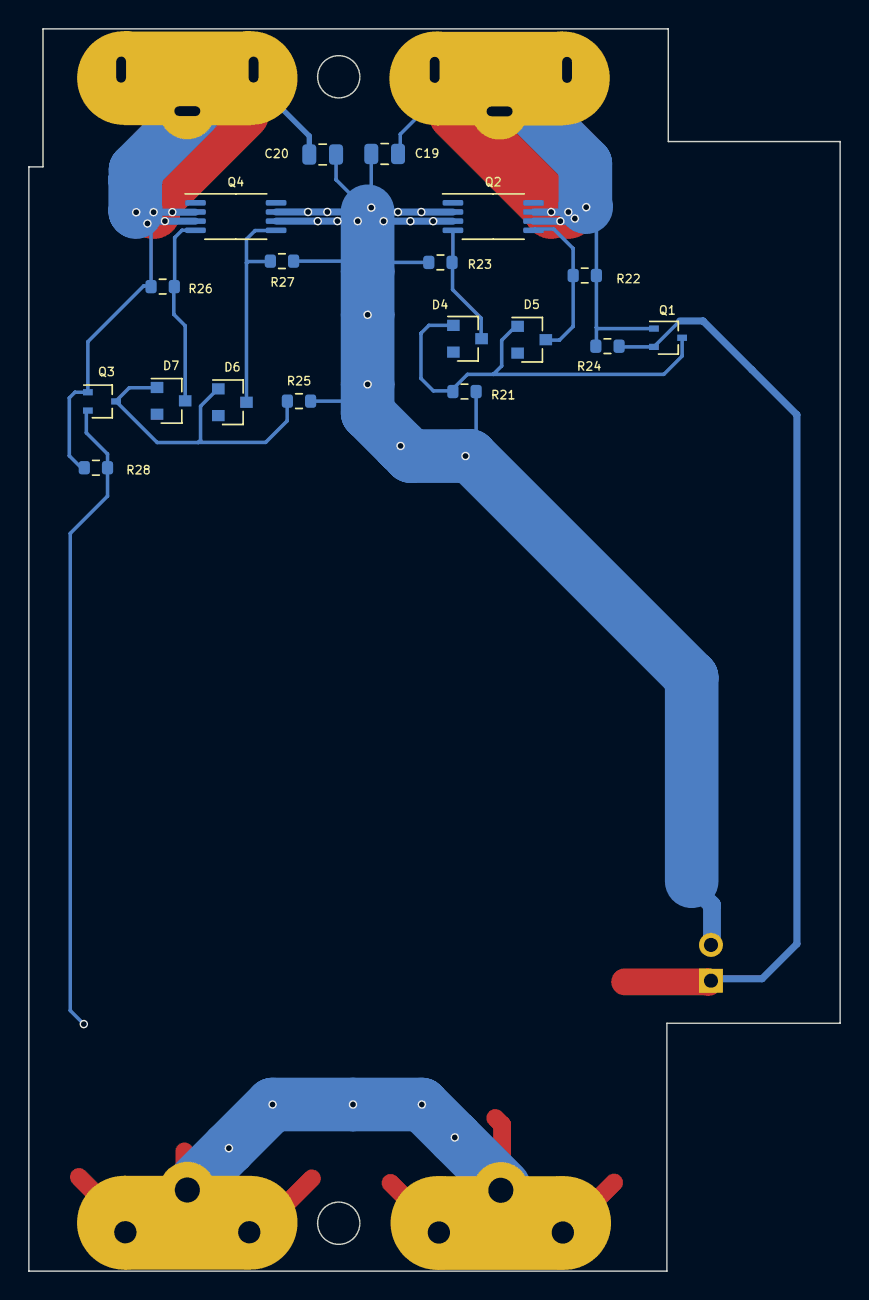
[picture p40: board HATB_ver_8.kicad_pcb from below]

Board: 2 copper layers, 57.6 x 88.2 mm, 21 parts (18 on the bottom side), 10 nets.
