ConnectBox/Circuit-Design/Hat_7.0.6/Flex_1.0/HAT_CM4.kicad_pcb

## KiCad design Hat_7.0.6/Flex_1.0/HAT_CM4.kicad_pcb (2021-07-24)

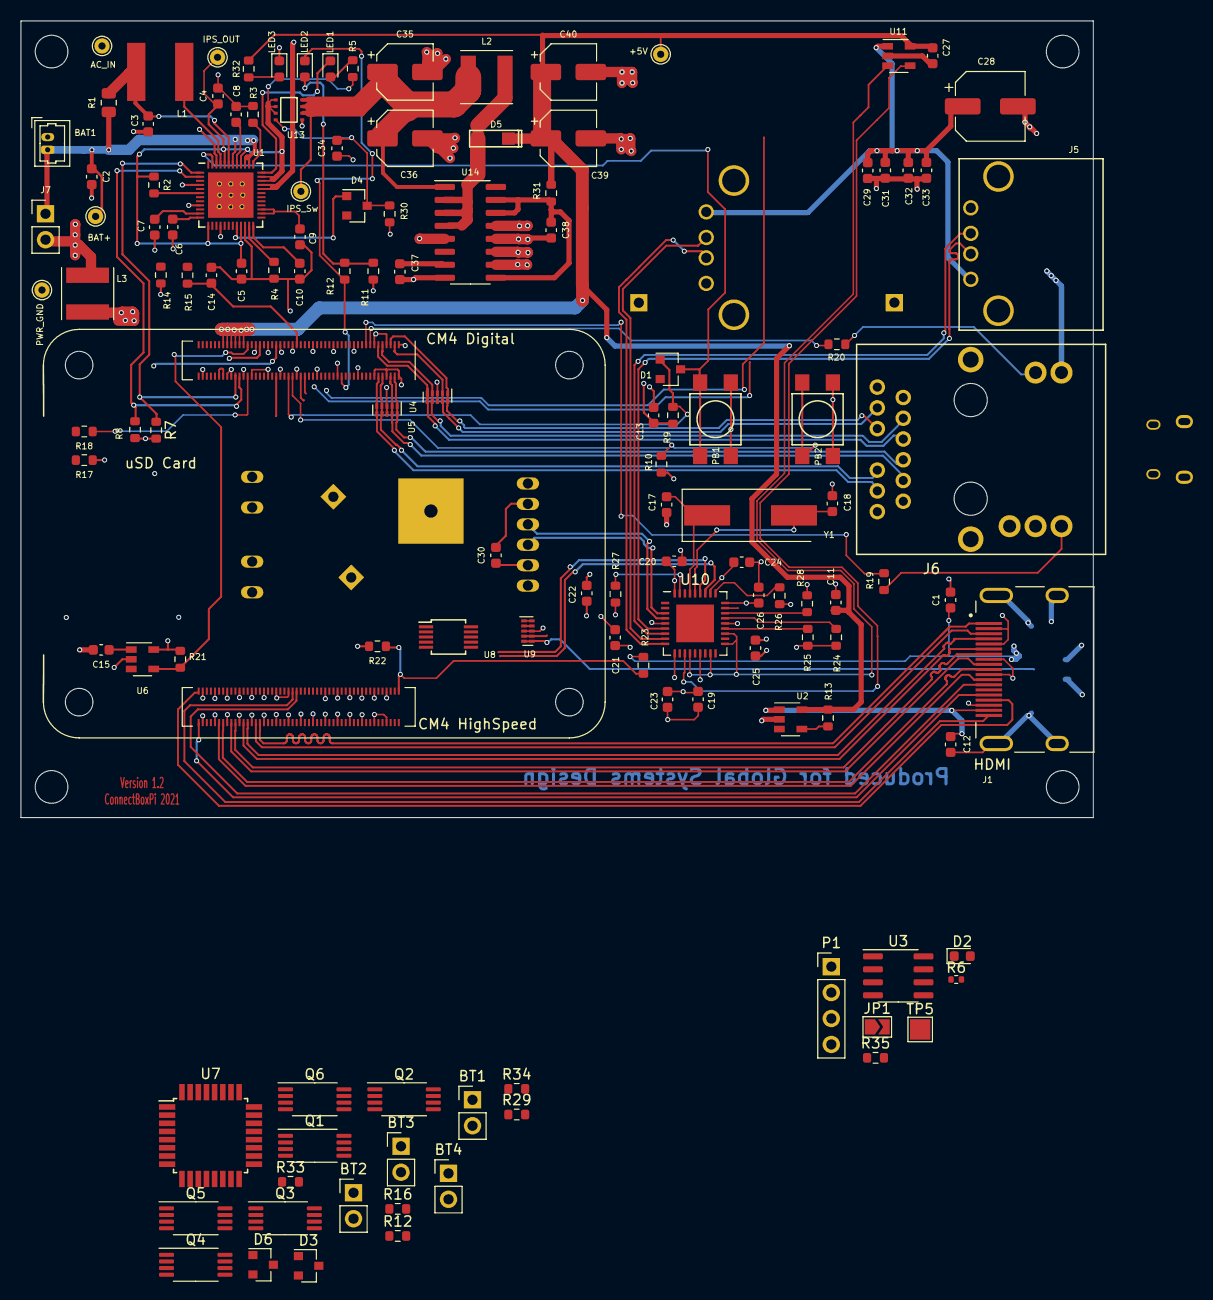
[picture p41: board HAT_CM4.kicad_pcb from above]

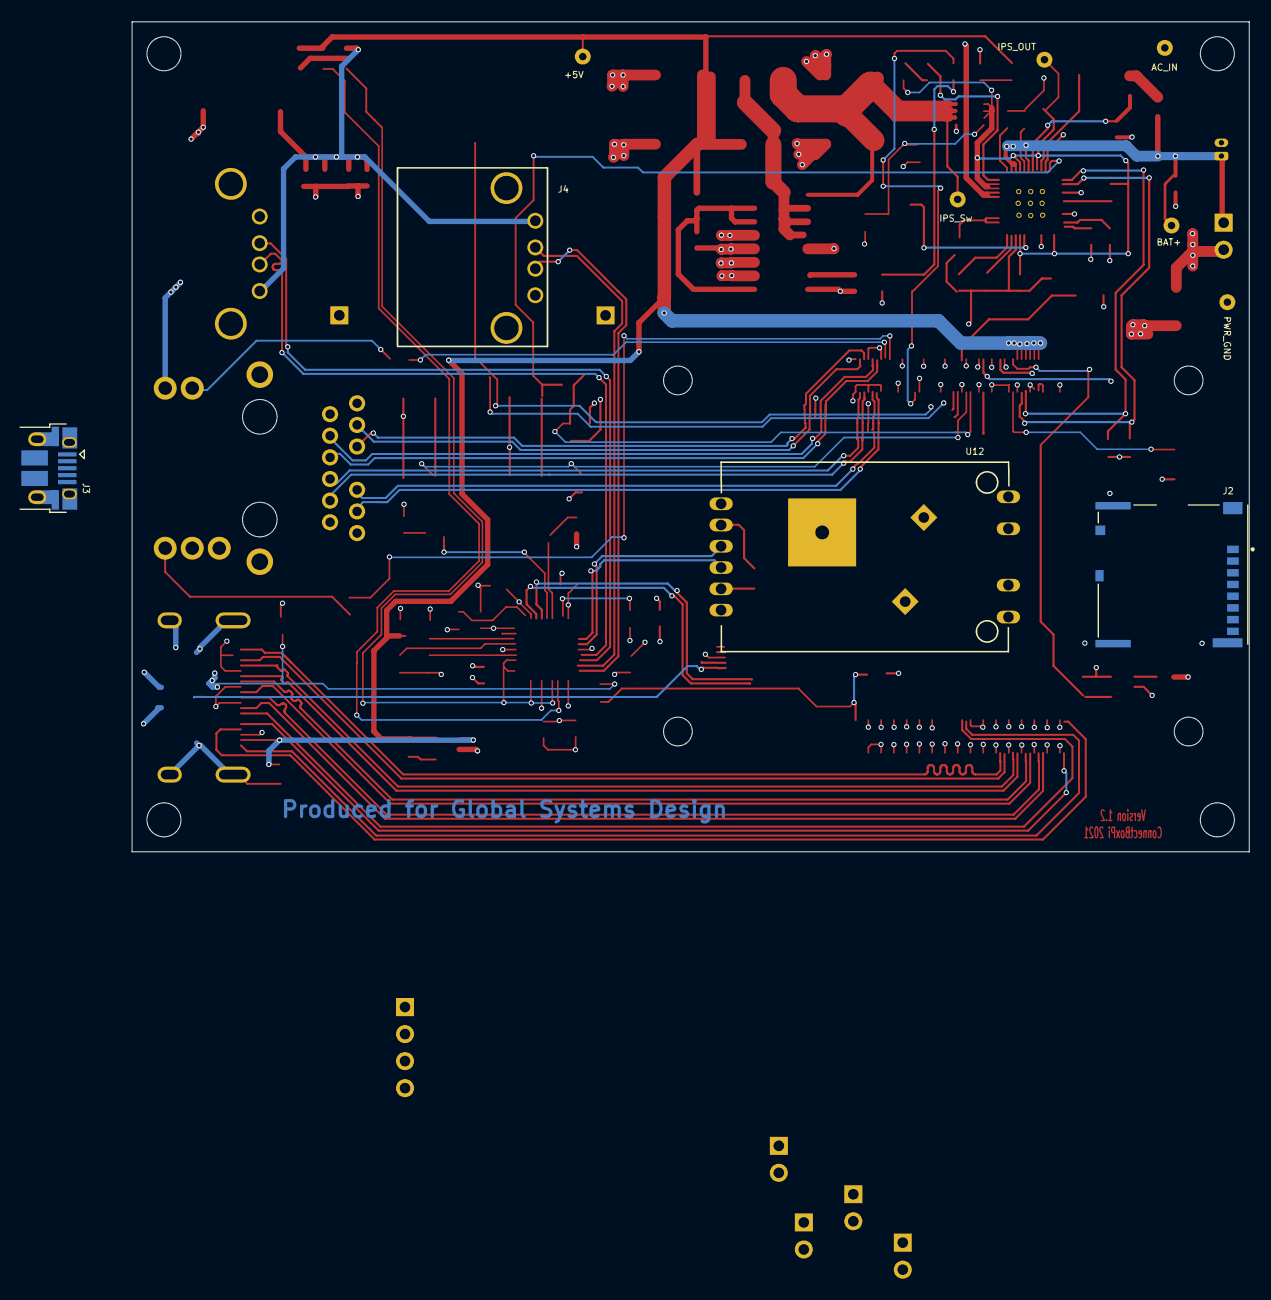
[picture p42: board HAT_CM4.kicad_pcb from below]

Board: 4 copper layers, 105.0 x 78.0 mm, 132 parts (4 on the bottom side), 115 nets.

Parts:
BAT1: Molex PicoBlade 53047-0210; Molex PicoBlade 53047-0210 - (swapped pins)
BT1, BT2, BT3, BT4: Battery_Cell; PinHeader_1x02_P2.54mm_Vertical
C1, C30, C34: 22uF; C_0603_1608Metric
C2, C3, C4, C5, C14, C15, C19, C20, C27, C29, C31, C32, C33: 10uF; C_0603_1608Metric
C6, C7, C8: 4.7uF; C_0603_1608Metric
C9, C10, C13: 1uF; C_0603_1608Metric
C11, C12, C21, C22, C23, C24, C25, C26, C38: 0.1uf; C_0603_1608Metric
C17, C18: 27pF; C_0603_1608Metric
C28: 100uF; CP_Elec_6.3x4.5
C35, C36, C39, C40: 150uf; CP_Elec_5x3
C37: 0.22uf; C_0603_1608Metric
D1, D3, D4, D6: MMBD914; D_SOT-23_ANK
D2: LED Green; LED_0603_1608Metric
D5: NRVTS260ESFT1G; SOD-123FL
J1: 690-019-298-412; EDAC 690-019-298-412
J2: Micro_SD_Card_Det; SDCARD_MOLEX_503398-1892
J3: USB_OTG; USB_Micro-B_EDAC_UCON00686
J4, J5: USB_A
J6: MagJack-L829-1J1T-JM; MagJack L829-1J1T-JM
J7: Conn_01x02_Female; PinHeader_1x02_P2.54mm_Vertical
JP1: SolderJumper_2_Open; SolderJumper-2_P1.3mm_Open_TrianglePad1.0x1.5mm
L1: 4.7 uH; INDUCTOR_SMD_6x6-1
L2: 1.0 uH; L_Taiyo-Yuden_MD-5050
L3: 1.5 uH; L_Taiyo-Yuden_NR-50xx
LED1: Red; LED_0603_1608Metric
LED2: Amber; LED_0603_1608Metric
LED3: Green; LED_0603_1608Metric
Module1: ComputeModule4; Raspberry-Pi-4-Compute-Module
P1: Conn_01x04; PinHeader_1x04_P2.54mm_Vertical
PB1, PB2: SPST-PUSH; SW-TL3305
Q1, Q2, Q3, Q4, Q5, Q6: 8205A; TSSOP-8_4.4x3mm_P0.65mm
R1: 0.03 ohm; R_0805_2012Metric
R2, R9, R10, R12, R29, R34, R35: 10K; R_0603_1608Metric
R3: 100; R_0603_1608Metric
R4: 200K; R_0603_1608Metric
R5: 1.8K; R_0603_1608Metric
R6: 1k; R_0402_1005Metric
R7, R8, R16, R22, R23, R33: 2.2K; R_0603_1608Metric
R11, R12#2, R15, R32: 1K; R_0603_1608Metric
R13, R21, R27: 12K; R_0603_1608Metric
R14: 51K; R_0603_1608Metric
R17, R18: nf; R_0603_1608Metric
R19, R20: 470; R_0603_1608Metric
R24, R25, R26, R28: 36.0K; R_0603_1608Metric
R30: 220K; R_0603_1608Metric
R31: 2.0; R_0603_1608Metric
TP1: Pwr_Gnd; TestPoint_THTPad_D1.5mm_Drill0.7mm
TP2: AC_IN; TestPoint_THTPad_D1.5mm_Drill0.7mm
TP3: Bat+; TestPoint_THTPad_D1.5mm_Drill0.7mm
TP4: IPS; TestPoint_THTPad_D1.5mm_Drill0.7mm
TP5: TestPoint; TestPoint_Pad_2.0x2.0mm
TP7: IPS_Sw; TestPoint_THTPad_D1.5mm_Drill0.7mm
TP8: 5V; TestPoint_THTPad_D1.5mm_Drill0.7mm
U1: AXP209; UQFN-48-1EP_6x6mm_Pitch0.4mm_75
U2: RT9742SNGV; SOT-23-5
U3: AT24CS01-SSHM; SOIC-8_3.9x4.9mm_P1.27mm
U4, U5, U9: TPD4EUSB30; USON-10_2.5x1.0mm_P0.5mm
U6, U11: RT9742ANGJ5F; SOT-23-5
U7: ATtiny88-AU; TQFP-32_7x7mm_P0.8mm
U8: FSUSB42MUX; MSOP-10_3x3mm_P0.5mm
U10: USB2514B-I/M2; QFN-36-1EP_6x6mm_P0.5mm_EP3.7x3.7mm
U12: HC-R8812AF1; HC-R8812AU2-th-1
U13: DML10M8LDS-13
U14: MAX1709ESE; SOP-16_3.9x9.9mm_P1.27mm
Y1: 24MHz; Crystal_SMD_HC49-SD

Connections:
+3.3v: C13.1, C19.1, C20.1, C21.1, C22.1, C23.1, C24.1, C25.1, C26.1, C30.1, J6.14 (LEDY_A), J6.16 (COM), Module1.78 (GPIO_VREF(1.8v/3.3v_Input)), Module1.84 (+3.3v_(Output)), Module1.86 (+3.3v_(Output)), R7.2, R8.2, R9.2, R10.2, R11.1, R14.1, R17.1, R21.2, U6.5 (VIN), U8.1 (VCC), U10.5 (VDDA33), U10.10 (VDDA33), U10.15 (VDD33), U10.23 (VDD33), U10.27 (VBUS_DET), U10.29 (VDDA33), U10.36 (VDDA33), U12.1 (PDN), U12.2 (3.3V)
+5v: C11.1, C27.1, C39.1, C40.1, D2.2 (A), D5.1 (K), D6.2 (A), JP1.1 (A), Module1.77 (+5v_(Input)), Module1.79 (+5v_(Input)), Module1.81 (+5v_(Input)), Module1.83 (+5v_(Input)), Module1.85 (+5v_(Input)), Module1.87 (+5v_(Input)), P1.2, R12.2, R13.2, R31.1, R32.1, TP8.1, U2.5 (VIN), U3.8 (VCC), U11.5 (VIN)
/BatteryModule1/ADC0: R29.1, R33.1, U7.23 (PC0)
/BatteryModule1/ADC1: Q4.1 (D), Q4.8 (D), Q6.1 (D), Q6.8 (D), R33.2, U7.24 (PC1)
/BatteryModule1/ADC2: R12.1, R16.1, U7.25 (PC2)
/BatteryModule1/BT1_ENA: Q2.4 (G1), Q2.5 (G2), R34.1, U7.12 (PB0)
/BatteryModule1/BT1_RD: Q4.4 (G1), U7.30 (PD0)
/BatteryModule1/BT2_ENA: Q3.4 (G1), Q3.5 (G2), U7.13 (PB1)
/BatteryModule1/BT2_RD: Q4.5 (G2), U7.31 (PD1)
/BatteryModule1/BT3_ENA: Q1.4 (G1), Q1.5 (G2), U7.14 (PB2)
/BatteryModule1/BT3_RD: Q6.4 (G1), U7.32 (PD2)
/BatteryModule1/BT4_ENA: Q5.4 (G1), Q5.5 (G2), U7.7 (PB6)
/BatteryModule1/BT4_RD: Q6.5 (G2), U7.1 (PD3)
/BatteryModule1/I2C_SCL: Module1.80 (SCL0), P1.3, R8.1, U1.2 (SCK), U3.6 (SCL), U7.28 (PC5)
/BatteryModule1/I2C_SDA: Module1.82 (SDA0), P1.4, R7.1, U1.1 (SDA), U3.5 (SDA), U7.27 (PC4)
/CM4_GPIO/+1.8v: Module1.88 (+1.8v_(Output)), Module1.90 (+1.8v_(Output))
/CM4_GPIO/ETH_LEDG: Module1.17 (Ethernet_nLED2(3.3v)), R19.1
/CM4_GPIO/ETH_LEDY: Module1.15 (Ethernet_nLED3(3.3v)), R20.1
/CM4_GPIO/EXT_ENA: D4.2 (A), R14.2, R15.2, U1.20 (EXTEN)
/CM4_GPIO/GPIO6: LED2.1 (K), Module1.30 (GPIO6), R12#2.2
/CM4_GPIO/GPIO_IRQ: C14.1, Module1.51 (GPIO15), R15.1
/CM4_GPIO/GPIO_PB1: D1.2 (A), Module1.56 (GPIO3), R9.1
/CM4_GPIO/GPIO_PB2: Module1.54 (GPIO4), PB2.1, R10.1
/CM4_GPIO/PowerSwitch: D1.1 (K), PB1.1, U1.47 (PwrON)
/CM4_GPIO/Reserved: Module1.76 (Reserved), R18.1
/CM4_GPIO/SD_CLK: J2.5 (CLK), Module1.57 (SD_CLK)
/CM4_GPIO/SD_CMD: J2.3 (CMD), Module1.62 (SD_CMD)
/CM4_GPIO/SD_DAT0: J2.7 (DAT0), Module1.63 (SD_DAT0)
/CM4_GPIO/SD_DAT1: J2.8 (DAT1), Module1.67 (SD_DAT1)
/CM4_GPIO/SD_DAT2: J2.1 (DAT2), Module1.69 (SD_DAT2)
/CM4_GPIO/SD_DAT3: J2.2 (DAT3/CD), Module1.61 (SD_DAT3)
/CM4_GPIO/SD_PWR: C15.1, J2.4 (VDD), U6.1 (VOUT)
/CM4_GPIO/SD_PWR_ON: Module1.75 (SD_PWR_ON), R21.1, U6.4 (EN)
/CM4_GPIO/TRD0_N: J6.10 (TRD0-), Module1.10 (Ethernet_Pair0_N), U5.4 (D2+), U5.7
/CM4_GPIO/TRD0_P: J6.11 (TRD0+), Module1.12 (Ethernet_Pair0_P), U5.5 (D2-), U5.6
/CM4_GPIO/TRD1_N: J6.5 (TRD1-), Module1.6 (Ethernet_Pair1_N), U5.2 (D1-), U5.9
/CM4_GPIO/TRD1_P: J6.4 (TRD1+), Module1.4 (Ethernet_Pair1_P), U5.1 (D1+), U5.10
/CM4_GPIO/TRD2_N: J6.2 (TRD2-), Module1.9 (Ethernet_Pair2_N), U4.4 (D2+), U4.7
/CM4_GPIO/TRD2_P: J6.3 (TRD2+), Module1.11 (Ethernet_Pair2_P), U4.5 (D2-), U4.6
/CM4_GPIO/TRD3_N: J6.9 (TRD3-), Module1.5 (Ethernet_Pair3_N), U4.1 (D1+), U4.10
/CM4_GPIO/TRD3_P: J6.8 (TRD3+), Module1.3 (Ethernet_Pair3_P), U4.2 (D1-), U4.9
/CM4_HighSpeed/HDMI0_CEC: J1.13 (CEC), Module1.151 (HDMI0_CEC)
/CM4_HighSpeed/HDMI0_CK_N: J1.12 (CK-), Module1.190 (HDMI0_CLK_N)
/CM4_HighSpeed/HDMI0_CK_P: J1.10 (CK+), Module1.188 (HDMI0_CLK_P)
/CM4_HighSpeed/HDMI0_D0_N: J1.9 (D0-), Module1.184 (HDMI0_TX0_N)
/CM4_HighSpeed/HDMI0_D0_P: J1.7 (D0+), Module1.182 (HDMI0_TX0_P)
/CM4_HighSpeed/HDMI0_D1_N: J1.6 (D1-), Module1.178 (HDMI0_TX1_N)
/CM4_HighSpeed/HDMI0_D1_P: J1.4 (D1+), Module1.176 (HDMI0_TX1_P)
/CM4_HighSpeed/HDMI0_D2_N: J1.3 (D2-), Module1.172 (HDMI0_TX2_N)
/CM4_HighSpeed/HDMI0_D2_P: J1.1 (D2+), Module1.170 (HDMI0_TX2_P)
/CM4_HighSpeed/HDMI0_HOTPLUG: J1.19 (HPD/HEAC-), Module1.153 (HDMI0_HOTPLUG)
/CM4_HighSpeed/HDMI0_SCL: J1.15 (SCL), Module1.200 (HDMI0_SCL)
/CM4_HighSpeed/HDMI0_SDA: J1.16 (SDA), Module1.199 (HDMI0_SDA)
/CM4_HighSpeed/HDMI_5v: C12.1, J1.18 (+5V), U2.1 (VOUT)
/CM4_HighSpeed/USB2_N: Module1.103 (USB2_N), U8.4 (D_N)
/CM4_HighSpeed/USB2_P: Module1.105 (USB2_P), U8.3 (D_P)
/CM4_HighSpeed/USBOTG_ID: Module1.101 (USB_OTG_ID), R22.1, R23.2, U8.2 (SEL)
/Charge control/BAT+: BAT1.1, BT1.1 (+), BT2.1 (+), BT3.1 (+), BT4.1 (+), C2.1, J7.1, R1.1, R29.2, R34.2, TP3.1, U1.38 (Batt), U1.39 (Batt), U1.42 (BatSense)
/Charge control/IPS_OUT: C4.1, C5.1, R2.2, R5.1, TP4.1, U1.13 (LDO_24_In), U1.21 (APS), U1.34 (IPS_Out), U1.35 (IPS_Out), U1.40 (LDO_3_In), U1.44 (Vin_1), U13.1 (IN), U13.2 (IN), U13.3 (VBias)
/USB Hub/HD2_N: U10.3 (USBDM_DN2/PRT_DIS_M2), U12.3 (DM-)
/USB Hub/HD2_P: U10.4 (USBDP_DN2/PRT_DIS_P2), U12.4 (DP+)
/USB Hub/HD3_N: J5.2 (D-), U10.6 (USBDM_DN3/PRT_DIS_M3)
/USB Hub/HD3_P: J5.3 (D+), U10.7 (USBDP_DN3/PRT_DIS_P3)
/USB Hub/HD4_N: J4.2 (D-), U10.8 (USBDM_DN4/PRT_DIS_M4)
/USB Hub/HD4_P: J4.3 (D+), U10.9 (USBDP_DN4/PRT_DIS_P4)
/USB Hub/PWR1: U10.12 (PRTPWR1/BC_EN1), U11.4 (EN)
/USB Hub/USBD_N: J3.2 (D-), U8.8 (HSD1_M), U9.4 (D2+), U9.7
/USB Hub/USBD_P: J3.3 (D+), U8.9 (HSD1_P), U9.5 (D2-), U9.6
/USB Hub/USBH_N: U8.6 (HSD0_M), U10.30 (USBDM_UP)
/USB Hub/USBH_P: U8.7 (HSD0_P), U10.31 (USBDP_UP)
/USB Hub/VBUS: C28.1, C29.1, C31.1, C32.1, C33.1, J4.1 (VBUS), J5.1 (VBUS), U11.1 (VOUT)
/USB Hub/nOCS1: U10.13 (OCS_N1), U10.17 (OCS_N2), U10.19 (OCS_N3), U10.21 (OCS_N4), U11.3 (/FLG)
AC_IN: C1.1, D3.2 (A), J3.1 (VBUS), R23.1, TP2.1, U1.32 (AC_IN), U1.33 (AC_IN)
GND: C1.2, C5.2, C9.1, C10.1, C11.2, C12.2, C13.2, C14.2, C15.2, C17.2, C18.2, C19.2, C20.2, C21.2, C22.2, C23.2, C24.2, C25.2, C26.2, C27.2, C28.2, C29.2, C30.2, C31.2, C32.2, C33.2, J1.2 (D2S), J1.5 (D1S), J1.8 (D0S), J1.11 (CKS), J1.17 (GND), J1.SH1 (SH), J1.SH2 (SH), J1.SH3 (SH), J1.SH4 (SH), J2.6 (VSS), J2.11 (SHIELD), J3.5 (GND), J3.6 (Shield), J4.4 (GND), J4.5 (Shield), J5.4 (GND), J5.5 (Shield), J6.18 (SHIELD), L3.2, Module1.1 (GND), Module1.2 (GND), Module1.7 (GND), Module1.8 (GND), Module1.13 (GND), Module1.14 (GND), Module1.22 (GND), Module1.23 (GND), Module1.32 (GND), Module1.33 (GND), Module1.42 (GND), Module1.43 (GND), Module1.52 (GND), Module1.53 (GND), Module1.59 (GND), Module1.60 (GND), Module1.65 (GND), Module1.66 (GND), Module1.71 (GND), Module1.74 (GND), Module1.98 (GND), Module1.107 (GND), Module1.108 (GND), Module1.113 (GND), Module1.114 (GND), Module1.119 (GND), Module1.120 (GND), Module1.125 (GND), Module1.126 (GND), Module1.131 (GND), Module1.132 (GND), Module1.137 (GND), Module1.138 (GND), Module1.144 (GND), Module1.150 (GND), Module1.155 (GND), Module1.156 (GND), Module1.161 (GND), Module1.162 (GND), Module1.167 (GND), Module1.168 (GND), Module1.173 (GND), Module1.174 (GND), Module1.179 (GND), Module1.180 (GND), Module1.185 (GND), Module1.186 (GND), Module1.191 (GND), Module1.192 (GND), Module1.197 (GND), Module1.198 (GND), P1.1, PB1.2, PB2.2, Q1.6 (S2), Q1.7 (S2), Q2.6 (S2), Q2.7 (S2), Q3.6 (S2), Q3.7 (S2), Q5.6 (S2), Q5.7 (S2), R4.1, R16.2, R22.2, R24.2, R25.2, R26.2, R27.1, R28.2, R35.1, U1.22 (A_Gnd), U2.2 (GND), U3.1 (A0), U3.2 (A1), U3.3 (A2), U3.4 (GND), U4.3 (GND), U4.8 (GND), U5.3 (GND), U5.8 (GND), U6.2 (GND), U7.5 (GND), U7.21 (GND), U8.5 (GND), U8.10 (nOE), U9.3 (GND), U9.8 (GND), U10.37 (VSS), U11.2 (GND), U12.5 (GND), U12.7 (GND), U12.9 (GND), U12.10 (GND), U12.12 (GND), U12.13 (GND), U12.14 (GND), U12.15 (GND)
unnamed: BT1.2 (-), Q2.2 (S1), Q2.3 (S1), Q4.2 (S1), Q4.3 (S1)
unnamed: BT2.2 (-), Q3.2 (S1), Q3.3 (S1), Q4.6 (S2), Q4.7 (S2)
unnamed: BT3.2 (-), Q1.2 (S1), Q1.3 (S1), Q6.2 (S1), Q6.3 (S1)
unnamed: BT4.2 (-), Q5.2 (S1), Q5.3 (S1), Q6.6 (S2), Q6.7 (S2)
unnamed: C3.1, L1.1, R1.2, U1.43 (ChgSense)
unnamed: C6.2, U1.12 (LDO_2)
unnamed: C7.2, U1.11 (LDO_4)
unnamed: C8.2, U1.41 (LDO_3)
unnamed: C9.2, U1.26 (V_Internal), U1.27 (LDO_1_Set)
unnamed: C10.2, U1.24 (V_Ref)
unnamed: C17.1, U10.33 (XTALIN/CLKIN), Y1.1
unnamed: C18.1, U10.32 (XTALOUT), Y1.2
unnamed: C34.1, D4.1 (K), R30.1, U13.4 (ON)
unnamed: C35.1, C36.1, L2.1, TP7.1, U13.6 (OUT), U13.7 (OUT), U13.8 (OUT), U14.1 (ONA)
unnamed: C37.1, U14.7 (REF)
unnamed: C38.1, R31.2, U14.9 (OUT), U14.14 (_3.3/5), U14.15 (CLK)
unnamed: D2.1 (K), R6.1, TP5.1
unnamed: D3.1 (K), D6.1 (K), U7.4 (VCC), U7.18 (AVCC)
unnamed: D5.2 (A), L2.2, U14.2 (LX), U14.3 (LX), U14.4 (LX)
unnamed: J2.9 (DET_B), R18.2
unnamed: J2.10 (DET_A), R17.2
unnamed: J6.13 (LEDY_K), R20.2
unnamed: J6.17 (LEDG_K), R19.2
unnamed: JP1.2 (B), R35.2, U3.7 (WP)
unnamed: L1.2, U1.45 (LX1)
unnamed: LED1.1 (K), U1.36 (ChgLED)
unnamed: LED1.2 (A), R5.2
unnamed: LED2.2 (A), R11.2, R12#2.1
unnamed: LED3.2 (A), R32.2
unnamed: R2.1, U1.6 (N_VBus_En)
unnamed: R3.1, U1.37 (TS)
unnamed: R4.2, U1.23 (Bias)
unnamed: R13.1, U2.4 (EN)
unnamed: R24.1, U10.24 (SCL/SMBCLK/CFG_SEL0)
unnamed: R25.1, U10.22 (SDA/SMBDATA/NON_REM1)
unnamed: R26.1, U10.28 (SUSP_IND/LOCAL_PWR/NON_REM0)
unnamed: R27.2, U10.35 (RBIAS)
unnamed: R28.1, U10.25 (HS_IND/CFG_SEL1)
unnamed: U9.1 (D1+), U9.10
unnamed: U9.2 (D1-), U9.9
PWR_GND: BAT1.2, C2.2, C3.2, C4.2, C6.1, C7.1, C8.1, C34.2, C35.2, C36.2, C37.2, C38.2, C39.2, C40.2, J7.2, L3.1, LED3.1 (K), R3.2, R30.2, TP1.1, U1.4 (N_OE), U1.9 (PGnd_2), U1.16 (PGnd_3), U1.46 (PGnd_1), U1.49 (GND_PAD), U13.5 (GND), U14.5 (GND), U14.8 (GND), U14.10 (FB), U14.11 (PGND), U14.12 (PGND), U14.13 (PGND)
