ConnectBox/Circuit-Design/Hat_7.0.6/HAT_ver_7.0.6/HAT_ver_7.kicad_pcb

## KiCad design Hat_7.0.6/HAT_ver_7.0.6/HAT_ver_7.kicad_pcb (2021-07-24)

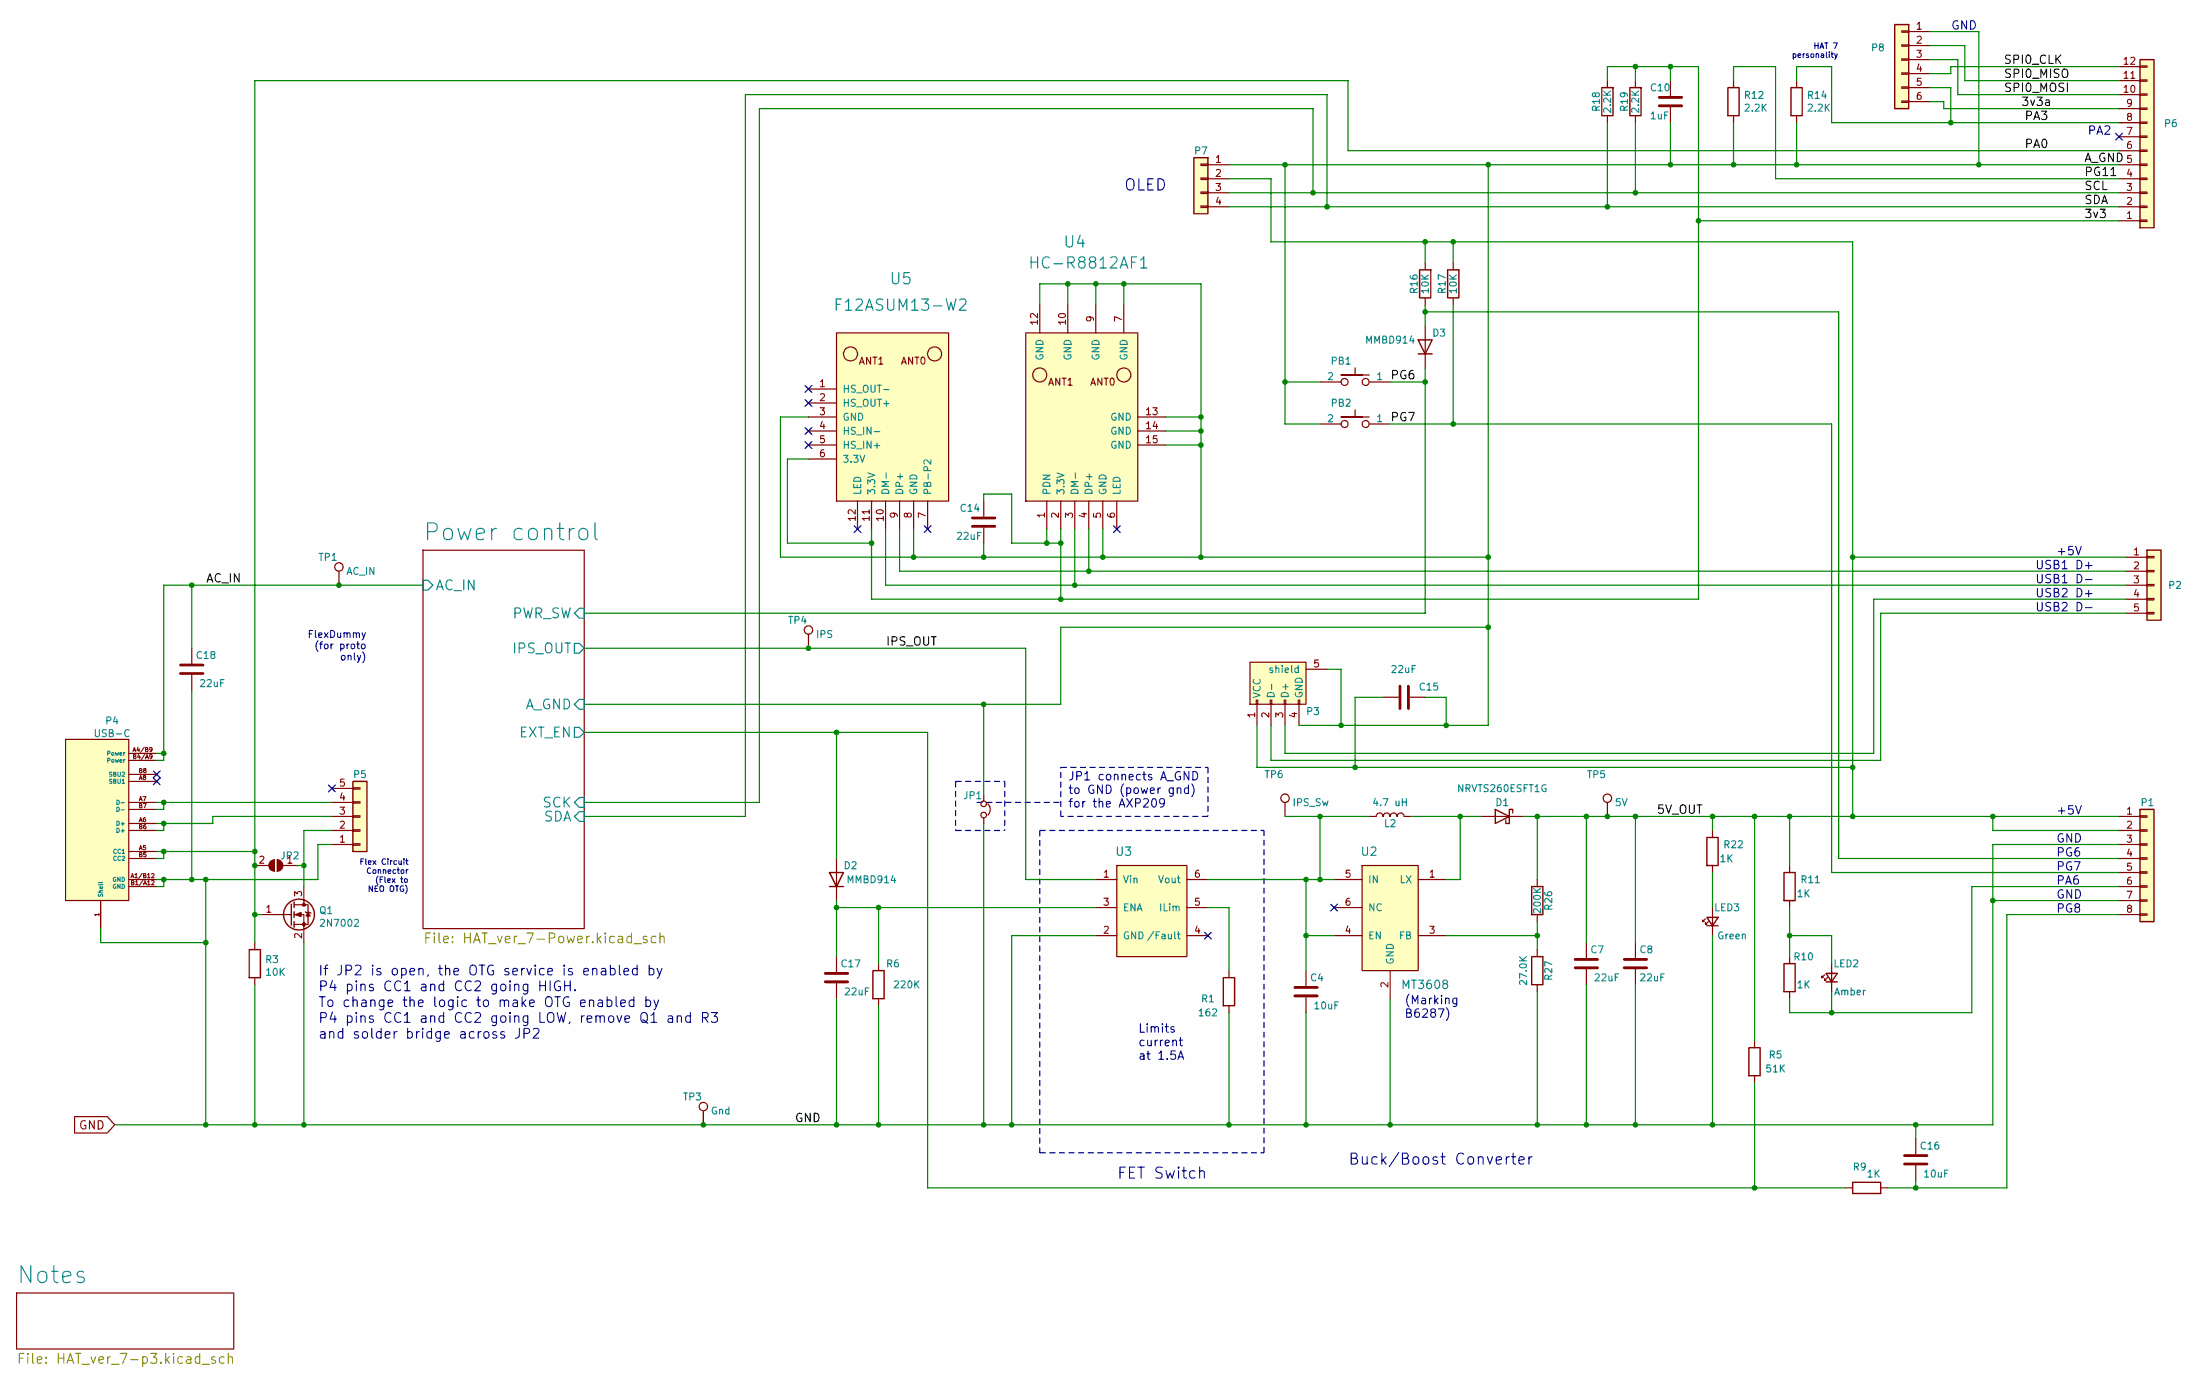
[picture p43: schematic HAT_ver_7.kicad_sch, ConnectBox HAT 7]

Parts:
C4, C16: 10uF; C_0805_2012Metric; Manufacturer P/N CL21A106MPFNNNE; DigiKey P/N 1276-1144-1-ND
C7, C8, C14, C15, C17, C18: 22uF; C_0805_2012Metric; Manufacturer P/N C0805C226M8PAC7800; DigiKey P/N 399-12069-1-ND
C10: 1uF; C_0805_2012Metric; Manufacturer P/N C0805C105K8PACTU; DigiKey P/N 399-8006-1-ND
D1: NRVTS260ESFT1G; SOD-123FL; Manufacturer P/N NRVTS260ESFT1G; DigiKey P/N NRVTS260ESFT1GOSCT-ND
D2, D3: MMBD914; D_SOT-23_ANK; Manufacturer P/N MMBD914LT1G; DigiKey P/N MMBD914LT1GOSCT-ND
JP1: Jumper_NC_Small; NetConnect-50
JP2: SolderJumper_2_Open; SolderJumper-2_P1.3mm_Open_TrianglePad1.0x1.5mm
L2: 4.7 uH; INDUCTOR_SMD_6x6-1; Manufacturer P/N NR6028T4R7M; DigiKey P/N 587-2100-1-ND
LED2: Amber; LED_0603_1608Metric; Manufacturer P/N LTST-C191KFKT; DigiKey P/N 160-1445-1-ND
LED3: Green; LED_0603_1608Metric; Manufacturer P/N LTST-C191KFKT; DigiKey P/N 160-1446-1-ND
P1: Conn_01x08; PinHeader_1x08_P2.54mm_Vertical; Manufacturer P/N PPPC081LFBN-RC; DigiKey P/N S7041-ND
P2: Conn_01x05; PinHeader_1x05_P2.54mm_Vertical; Manufacturer P/N PPPC051LFBN-RC; DigiKey P/N S7038-ND
P3: USB_A_1; USB_A; Manufacturer P/N USB-A1HSW6; DigiKey P/N ED2989-ND
P4: USB-C; USB-C-GCT; Manufacturer P/N USB4105-GF-A; DigiKey P/N 2073-USB4105-GF-ACT-ND
P5: Conn_01x05; SFW5S-2STE1LF; Manufacturer P/N SFW5S-2STE1LF; DigiKey P/N 609-1134-1-ND
P6: Conn_01x12; PinHeader_1x12_P2.54mm_Vertical; Manufacturer P/N PPPC121LFBN-RC; DigiKey P/N S7045-ND
P7: Conn_01x04; PinHeader_1x04_P2.54mm_Vertical; Manufacturer P/N PPPC041LFBN-RC; DigiKey P/N S7037-ND
P8: Conn_01x06; SFW6R-1STE1LF; Manufacturer P/N SFW6R-1STE1LF; DigiKey P/N 609-1889-1-ND
PB1, PB2: SPST-PUSH; SW-TL3305; Manufacturer P/N TL3305AF260QG; DigiKey P/N EG5353CT-ND
Q1: 2N7002; SOT-23; Manufacturer P/N T2N7002BK,LM; DigiKey P/N T2N7002BKLMCT-ND
R1: 162; R_0805_2012Metric; Manufacturer P/N RC0805FR-07162R; DigiKey P/N 311-162CRCT-ND
R3: 10K; R_0805_2012Metric
R5: 51K; R_0805_2012Metric; Manufacturer P/N RC0805FR-071KL; DigiKey P/N 311-51.0KCRCT-ND
R6: 220K; R_0805_2012Metric; Manufacturer P/N RC0805FR-07220KL; DigiKey P/N 311-220KCRCT-ND
R9, R10, R11, R22: 1K; R_0805_2012Metric; Manufacturer P/N RC0805FR-071KL; DigiKey P/N 311-1.00KCRCT-ND
R12, R14, R18, R19: 2.2K; R_0805_2012Metric; Manufacturer P/N RC0805FR-072K2L; DigiKey P/N 311-2.20KCRCT-ND
R16, R17: 10K; R_0805_2012Metric; Manufacturer P/N RC0805FR-0710KL; DigiKey P/N 311-10.0KCRCT-ND
R26: 200K; R_0805_2012Metric; Manufacturer P/N RC0805FR-07200KL; DigiKey P/N 311-200KCRCT-ND
R27: 27.0K; R_0805_2012Metric; Manufacturer P/N RC0805FR-0727KL; DigiKey P/N 311-27.0KCRCT-ND
TP1: AC_IN; TestPoint_THTPad_D1.5mm_Drill0.7mm
TP3: Gnd; TestPoint_THTPad_D1.5mm_Drill0.7mm
TP4: IPS; TestPoint_THTPad_D1.5mm_Drill0.7mm
TP5: 5V; TestPoint_THTPad_D1.5mm_Drill0.7mm
TP6: IPS_Sw; TestPoint_THTPad_D1.5mm_Drill0.7mm
U2: MT3608; SOT-23-6a; Manufacturer P/N MT3608
U3: MIC2019; SOT-23-6a; Manufacturer P/N MIC2019YM6-TR; DigiKey P/N 576-2595-1-ND
U4: HC-R8812AF1; HC-R8812AU2-th-1
U5: F12ASUM13-W2

Connections:
/3v3: C10.1, C14.1, P6.1, R18.2, R19.2, U4.1 (PDN), U4.2 (3.3V), U5.6 (3.3V), U5.11 (3.3V)
/3v3a: P6.9, P8.6
/5V_OUT: C7.1, C8.1, C15.2, D1.1 (K), P1.1, P1.2, P2.1, P3.1 (VCC), P7.2, R5.1, R11.1, R16.2, R17.2, R22.1, R26.1, TP5.1
/AC_IN: C18.1, P4.A4/B9 (Power), P4.B4/A9 (Power), TP1.1; also elsewhere on the board
/A_GND: C10.2, C14.2, C15.1, JP1.1, P3.4 (GND), P3.5 (shield), P6.5, P7.1, P8.1, PB1.2, PB2.2, R12.2, R14.2, U4.5 (GND), U4.7 (GND), U4.9 (GND), U4.10 (GND), U4.12 (GND), U4.13 (GND), U4.14 (GND), U4.15 (GND), U5.3 (GND), U5.8 (GND); also elsewhere on the board
/IPS_OUT: TP4.1, U3.1 (Vin); also elsewhere on the board
/PA0: JP2.2 (B), P4.A5 (CC1), P4.B5 (CC2), P6.6, Q1.1 (G), R3.1
/PA3: P6.8, P8.5, R14.1
/PG6: D3.1 (K), PB1.1; also elsewhere on the board
/PG7: P1.5, PB2.1, R17.1
/PG11: P6.4, R12.1
/Power control/EXT_EN: D2.2 (A), R5.2, R9.1; also elsewhere on the board
/SCL: P6.3, P7.3, R19.1; also elsewhere on the board
/SDA: P6.2, P7.4, R18.1; also elsewhere on the board
/SPI0_CLK: P6.12, P8.4
/SPI0_MISO: P6.11, P8.2
/SPI0_MOSI: P6.10, P8.3
GND: C4.2, C7.2, C8.2, C16.1, C17.2, C18.2, JP1.2, LED3.1 (K), P1.3, P1.7, P4.1 (Shell), P4.A1/B12 (GND), P4.B1/A12 (GND), P5.1, Q1.2 (S), R1.2, R3.2, R6.2, R27.2, TP3.1, U2.2 (GND), U3.2 (GND); also elsewhere on the board
unnamed: C4.1, L2.1, TP6.1, U2.4 (EN), U2.5 (IN), U3.6 (Vout)
unnamed: C16.2, P1.8, R9.2
unnamed: C17.1, D2.1 (K), R6.1, U3.3 (ENA)
unnamed: D1.2 (A), L2.2, U2.1 (LX)
unnamed: D3.2 (A), P1.4, R16.1
unnamed: JP2.1 (A), P5.2, Q1.3 (D)
unnamed: LED2.1 (K), P1.6, R10.2
unnamed: LED2.2 (A), R10.1, R11.2
unnamed: LED3.2 (A), R22.2
unnamed: P2.2, U4.4 (DP+), U5.9 (DP+)
unnamed: P2.3, U4.3 (DM-), U5.10 (DM-)
unnamed: P2.4, P3.3 (D+)
unnamed: P2.5, P3.2 (D-)
unnamed: P4.A6 (D+), P4.B6 (D+), P5.3
unnamed: P4.A7 (D-), P4.B7 (D-), P5.4
unnamed: R1.1, U3.5 (ILim)
unnamed: R26.2, R27.1, U2.3 (FB)

Notes on the sheet:
If JP2 is open, the OTG service is enabled by P4 pins CC1 and CC2 going HIGH. To change the logic to make OTG enabled by P4 pins CC1 and CC2 going LOW, remove Q1 and R3 and solder bridge across JP2
FlexDummy (for proto only)
Flex Circuit Connector (Flex to NEO OTG)
JP1 connects A_GND to GND (power gnd) for the AXP209
FET Switch
OLED
Limits current at 1.5A
Buck/Boost Converter
(Marking B6287)
HAT 7 personality
GND
USB1 D+
USB1 D-
USB2 D+
USB2 D-
+5V
PG6
PG7
PA6
PG8
PA2

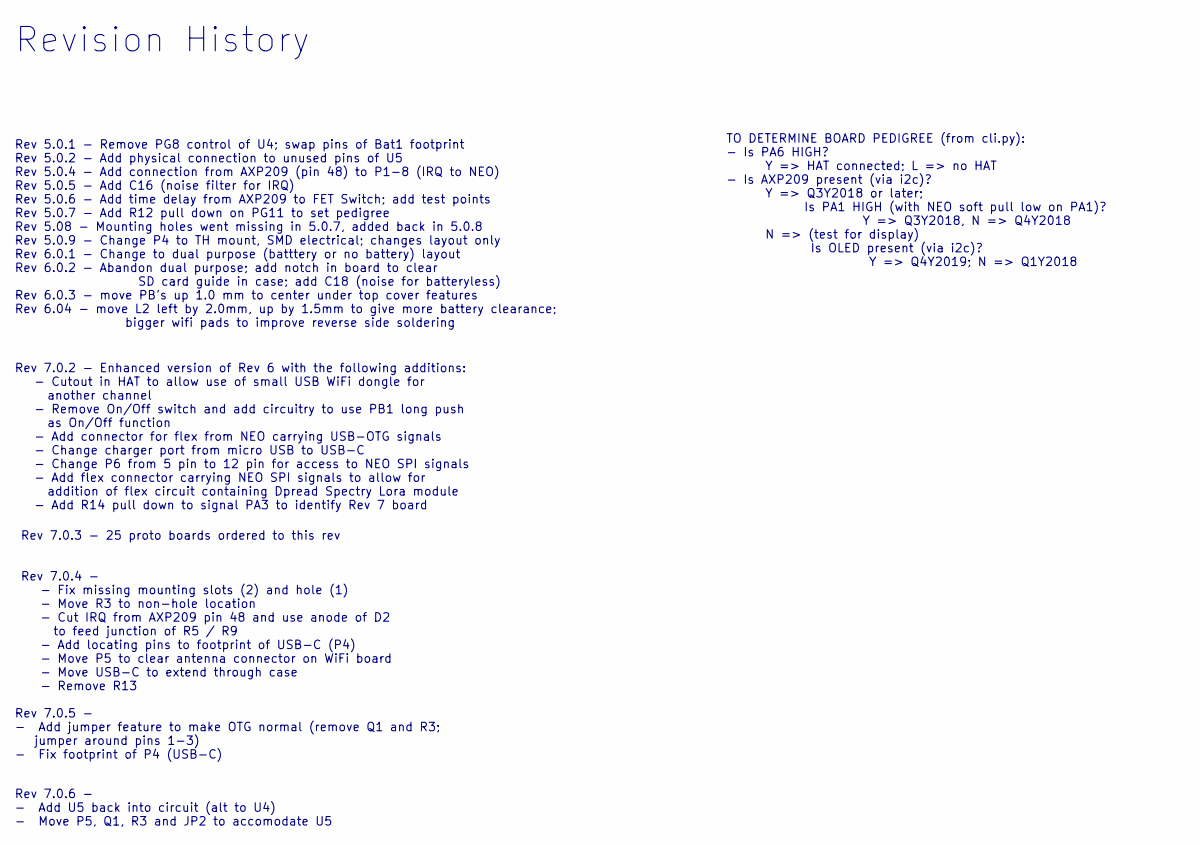
[picture p44: schematic HAT_ver_7-p3.kicad_sch, ConnectBox HAT 7]

Notes on the sheet:
Revision History
Rev 5.0.1 - Remove PG8 control of U4; swap pins of Bat1 footprint Rev 5.0.2 - Add physical connection to unused pins of U5 Rev 5.0.4 - Add connection from AXP209 (pin 48) to P1-8 (IRQ to NEO) Rev 5.0.5 - Add C16 (noise filter for IRQ) Rev 5.0.6 - Add time delay from AXP209 to FET Switch; add test p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
Rev 7.0.2 - Enhanced version of Rev 6 with the following additions: - Cutout in HAT to allow use of small USB WiFi dongle for another channel - Remove On/Off switch and add circuitry to use PB1 long push as On/Off function - Add connector for flex from NEO carrying USB-OTG signals - Change charger 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
Rev 7.0.5 - - Add jumper feature to make OTG normal (remove Q1 and R3; jumper around pins 1-3) - Fix footprint of P4 (USB-C)
Rev 7.0.6 - - Add U5 back into circuit (alt to U4) - Move P5, Q1, R3 and JP2 to accomodate U5
Rev 7.0.3 - 25 proto boards ordered to this rev
Rev 7.0.4 - - Fix missing mounting slots (2) and hole (1) - Move R3 to non-hole location - Cut IRQ from AXP209 pin 48 and use anode of D2 to feed junction of R5 / R9 - Add locating pins to footprint of USB-C (P4) - Move P5 to clear antenna connector on WiFi board - Move USB-C to extend through case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
TO DETERMINE BOARD PEDIGREE (from cli.py): - Is PA6 HIGH? Y => HAT connected; L => no HAT - Is AXP209 present (via i2c)? Y => Q3Y2018 or later; Is PA1 HIGH (with NEO soft pull low on PA1)? Y => Q3Y2018, N => Q4Y2018 N => (test for display) Is OLED present (via i2c)? Y => Q4Y2019; N => Q1Y2018

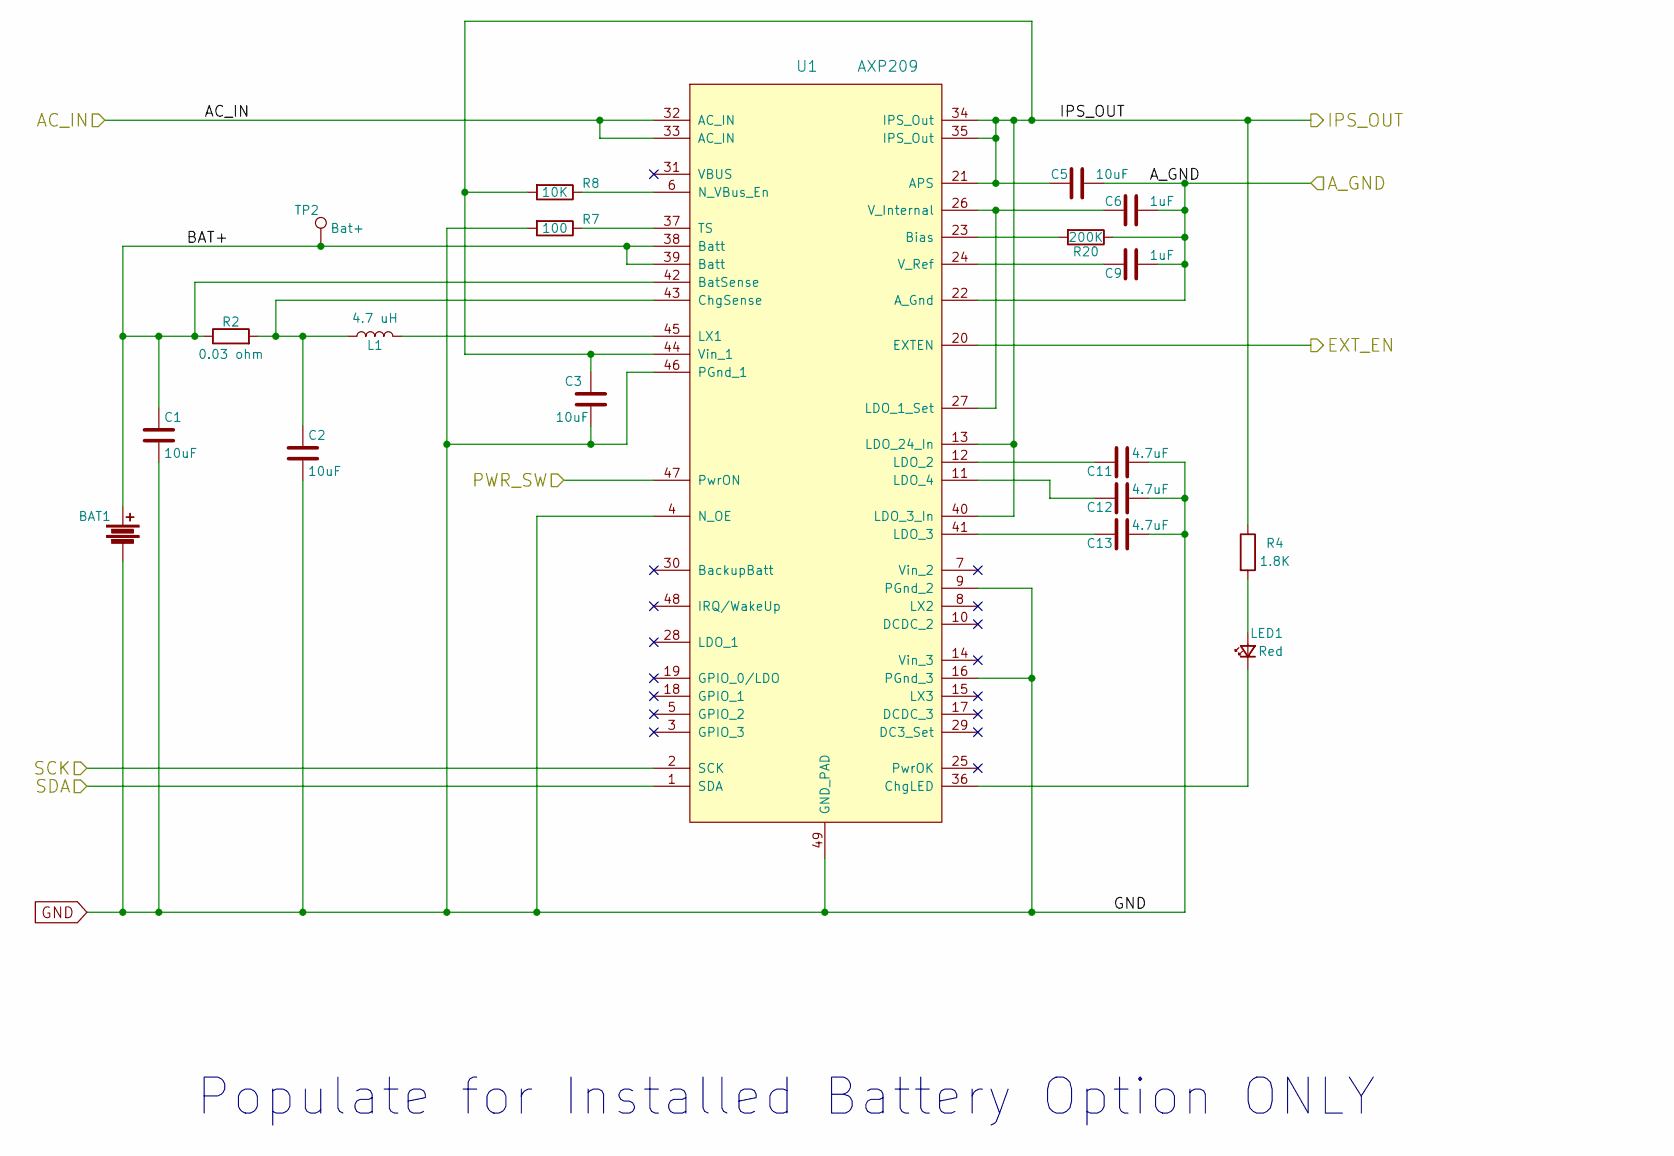
[picture p45: schematic HAT_ver_7-Power.kicad_sch, ConnectBox HAT 7]

Parts:
BAT1: Molex PicoBlade 53047-0210; Molex PicoBlade 53047-0210 - (swapped pins); Manufacturer P/N 0530470210; DigiKey P/N WM1731-ND
C1, C2, C3, C5: 10uF; C_0805_2012Metric; Manufacturer P/N CL21A106MPFNNNE; DigiKey P/N 1276-1144-1-ND
C6, C9: 1uF; C_0805_2012Metric; Manufacturer P/N C0805C105K8PACTU; DigiKey P/N 399-8006-1-ND
C11, C12, C13: 4.7uF; C_0805_2012Metric; Manufacturer P/N CL21B475KPFNNNE; DigiKey P/N 1276-2972-1-ND
L1: 4.7 uH; INDUCTOR_SMD_6x6-1; Manufacturer P/N NR6028T4R7M; DigiKey P/N 587-2100-1-ND
LED1: Red; LED_0603_1608Metric; Manufacturer P/N LTST-C191KRKT; DigiKey P/N 160-1447-1-ND
R2: 0.03 ohm; R_0805_2012Metric; Manufacturer P/N ERJ-6CWFR030V; DigiKey P/N P19207CT-ND
R4: 1.8K; R_0805_2012Metric; Manufacturer P/N RC0805FR-071K8L; DigiKey P/N 311-1.80KCRCT-ND
R7: 100; R_0805_2012Metric; Manufacturer P/N RC0805FR-07100RL; DigiKey P/N 311-100CRCT-ND
R8: 10K; R_0805_2012Metric; Manufacturer P/N RC0805FR-0710KL; DigiKey P/N 311-10.0KCRCT-ND
R20: 200K; R_0805_2012Metric; Manufacturer P/N RC0805FR-07200KL; DigiKey P/N 311-200KCRCT-ND
TP2: Bat+; TestPoint_THTPad_D1.5mm_Drill0.7mm
U1: AXP209; UQFN-48-1EP_6x6mm_Pitch0.4mm_75; Manufacturer P/N AXP209

Connections:
/AC_IN: U1.32 (AC_IN), U1.33 (AC_IN); also elsewhere on the board
/A_GND: C5.1, C6.1, C9.1, R20.1, U1.22 (A_Gnd); also elsewhere on the board
/IPS_OUT: C3.1, C5.2, R4.1, R8.2, U1.13 (LDO_24_In), U1.21 (APS), U1.34 (IPS_Out), U1.35 (IPS_Out), U1.40 (LDO_3_In), U1.44 (Vin_1); also elsewhere on the board
/PG6: U1.47 (PwrON); also elsewhere on the board
/Power control/BAT+: BAT1.1, C1.1, R2.1, TP2.1, U1.38 (Batt), U1.39 (Batt), U1.42 (BatSense)
/Power control/EXT_EN: U1.20 (EXTEN); also elsewhere on the board
/SCL: U1.2 (SCK); also elsewhere on the board
/SDA: U1.1 (SDA); also elsewhere on the board
GND: BAT1.2, C1.2, C2.2, C3.2, C11.1, C12.1, C13.1, R7.2, U1.4 (N_OE), U1.9 (PGnd_2), U1.16 (PGnd_3), U1.46 (PGnd_1), U1.49 (GND_PAD); also elsewhere on the board
unnamed: C2.1, L1.1, R2.2, U1.43 (ChgSense)
unnamed: C6.2, U1.26 (V_Internal), U1.27 (LDO_1_Set)
unnamed: C9.2, U1.24 (V_Ref)
unnamed: C11.2, U1.12 (LDO_2)
unnamed: C12.2, U1.11 (LDO_4)
unnamed: C13.2, U1.41 (LDO_3)
unnamed: L1.2, U1.45 (LX1)
unnamed: LED1.1 (K), U1.36 (ChgLED)
unnamed: LED1.2 (A), R4.2
unnamed: R7.1, U1.37 (TS)
unnamed: R8.1, U1.6 (N_VBus_En)
unnamed: R20.2, U1.23 (Bias)

Notes on the sheet:
Populate for Installed Battery Option ONLY

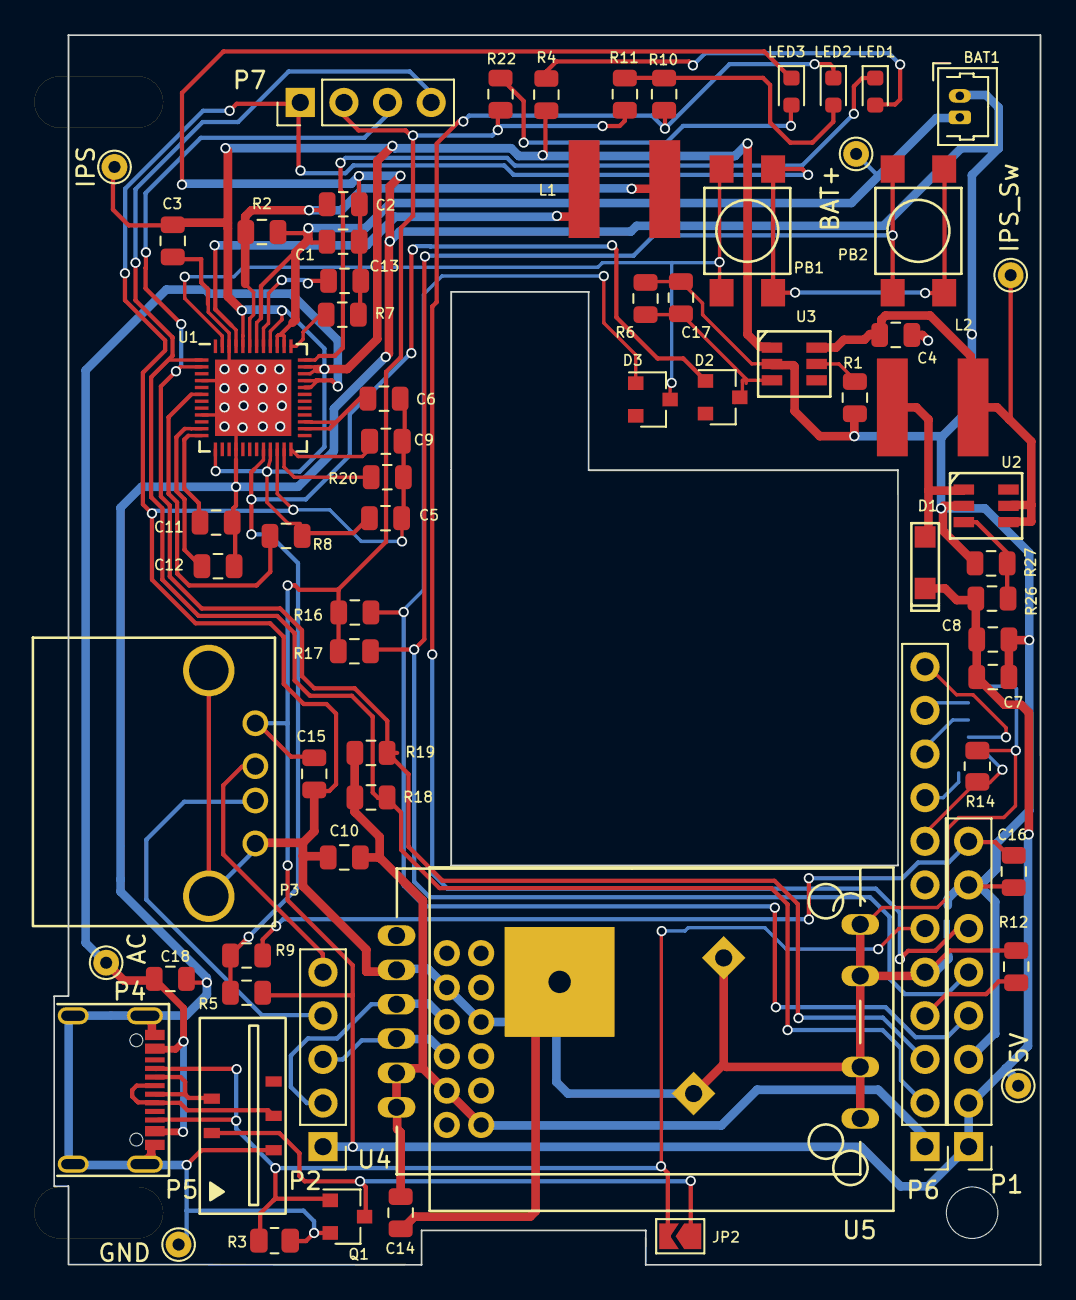
[picture p46: board HAT_ver_7.kicad_pcb from above]

Board: 2 copper layers, 57.4 x 71.6 mm, 72 parts (1 on the bottom side), 48 nets.
