ConnectBox/Circuit-Design/Hat 8.3.1/HATB_ver_8.3.1/HATB_ver_8.3.1.kicad_pcb

## KiCad design Hat 2.0/HAT_CM4_183_041022-V2.1/Base/HAT_CM4 base.kicad_pcb

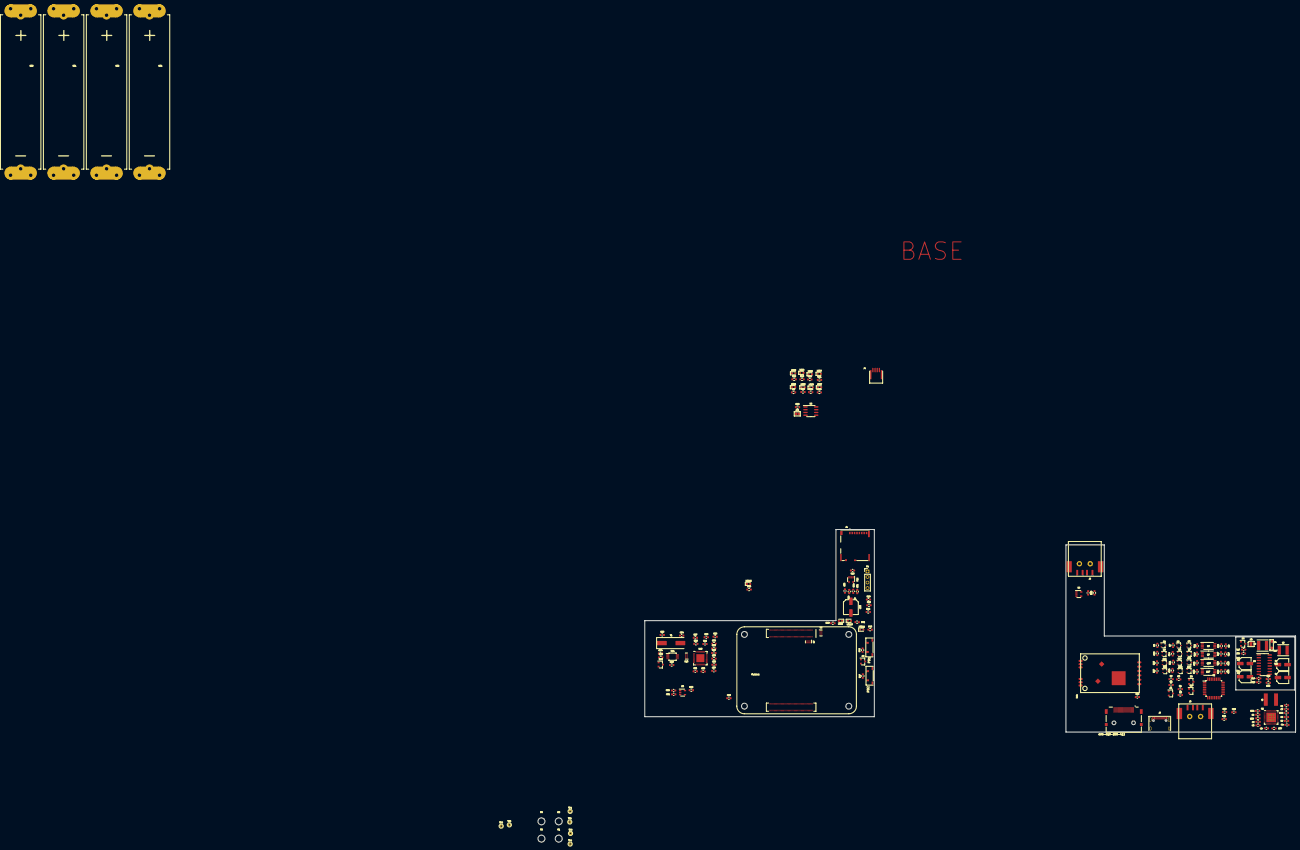
[picture p47: board HAT_CM4 base.kicad_pcb from above]

Board: 2 copper layers, 299.3 x 93.1 mm, 178 parts (0 on the bottom side), 133 nets, no tracks yet.

Parts:
BT1, BT2, BT3, BT4: Battery Connector; Battery 18650-3
C1, C2, C3, C4, C19, C20, C25, C26, C27, C32, C34, C36, C38: 10uF; C_0603_1608Metric
C5, C6, C7: 4.7uF; C_0603_1608Metric
C8, C9, C18: 1uF; C_0603_1608Metric
C10, C39, C40: 22uF; C_0603_1608Metric
C11, C12, C16, C17: 150uf; CP_Elec_5x3
C13: 1.0uf; C_0603_1608Metric
C14: 0.22uf; C_0603_1608Metric
C15, C21, C22, C28, C29, C31, C33, C35, C37: 0.1uf; C_0603_1608Metric
C23, C24: 9pF; C_0603_1608Metric
C30: 100uF; CP_Elec_6.3x4.5
D1, D2, D3, D5: MMBD914; D_SOT-23_ANK
D4: NRVTS260ESFT1G; SOD-123FL
H1, H2, H3, H4: MountingHole; MountingHole_3.2mm_M3
J1: Micro_SD_Card; SDCARD_MOLEX_503398-1892
J2: 690-019-298-412; HDMI_CnC_SMT
J3, J5: USB_A; USB_A_CUI_smd
J4: Conn_01x04; HFW4R
J6: USB-C; USB-C-GCT
JP1: SolderJumper_2_Open; SolderJumper-2_P1.3mm_Open_TrianglePad1.0x1.5mm
L1: 4.7 uH; INDUCTOR_SMD_6x6-1
L2: 1.0 uH; L_Taiyo-Yuden_MD-5050
L3: 1.5 uH; L_Taiyo-Yuden_NR-50xx
LED1, LED3, LED5, LED7: Blue; LED_0603_1608Metric
LED2, LED4, LED6, LED8, LED9: Red; LED_0603_1608Metric
LED10: Green; LED_0603_1608Metric
LED11: LED Green; LED_0603_1608Metric
LED12: Amber; LED_0603_1608Metric
Module1: ComputeModule4; Raspberry-Pi-4-Compute-Module
P1: Conn_01x04; PinHeader_1x04_P2.54mm_Vertical
PB1, PB2: SPST-PUSH; SW-TL3330A
Q1: NX6008; SOT-23
Q2, Q3, Q4, Q6, Q7, Q8, Q10, Q11, Q12, Q14, Q15, Q16: 3J15; SOT-323_SC-70
Q5, Q9, Q13, Q17: 8205A; TSSOP-8_4.4x3mm_P0.65mm
Q18: 2N7002; SOT-23
R1, R6, R9, R13, R16, R20, R23, R27, R30, R35, R42, R46, R47: 10K; R_0603_1608Metric
R2, R43, R44, R54, R55: 2.2K; R_0603_1608Metric
R3, R4, R11, R18, R25, R33: 20K; R_0603_1608Metric
R5, R10, R14, R17, R21, R24, R28, R32: 100K; R_0603_1608Metric
R7: 36K; R_0603_1608Metric
R8, R12, R15, R19, R22, R26, R29, R31, R48: 510; R_0603_1608Metric
R34: 0.03 ohm; R_0603_1608Metric
R36: 100; R_0603_1608Metric
R37: 200K; R_0603_1608Metric
R38: 1.8K; R_0603_1608Metric
R39: 220K; R_0603_1608Metric
R40: 2.0; R_0603_1608Metric
R41, R45, R51: 1K; R_0603_1608Metric
R49, R52, R59: 12K; R_0603_1608Metric
R50, R53: 51K; R_0603_1608Metric
R56, R57, R58, R60: 36.0K; R_0603_1608Metric
TP1: AC_IN; TestPoint_THTPad_D1.5mm_Drill0.7mm
TP2: Pwr_Gnd; TestPoint_THTPad_D1.5mm_Drill0.7mm
TP3: Bat+; TestPoint_THTPad_D1.5mm_Drill0.7mm
TP4: IPS; TestPoint_THTPad_D1.5mm_Drill0.7mm
TP5: IPS_Sw; TestPoint_THTPad_D1.5mm_Drill0.7mm
TP6: 5V; TestPoint_THTPad_D1.5mm_Drill0.7mm
U1: ATtiny88-AU; TQFP-32_7x7mm_P0.8mm
U2: AXP209; UQFN-48-1EP_6x6mm_Pitch0.4mm_75
U3: AP22814A; U-DFN2020-6
U4: MAX1709ESE; SOP-16_3.9x9.9mm_P1.27mm
U5: AT24CS01-SSHM; SOIC-8_3.9x4.9mm_P1.27mm
U6, U7, U10: TPD4EUSB30; USON-10_2.5x1.0mm_P0.5mm
U8, U9, U12: RT9742ANGJ5F; SOT-23-5
U11: FSUSB42MUX; MSOP-10_3x3mm_P0.5mm
U13: USB2514B-I/M2; QFN-36-1EP_6x6mm_P0.5mm_EP3.7x3.7mm
U14: HC-R8812AF1; HC-R8812AU2
Y1: 24MHz; Crystal_SMD_HC49-SD

Connections:
+3.3v: C18.1, C26.1, C27.1, C28.1, C29.1, C31.1, C33.1, C35.1, C37.1, C40.1, Module1.78 (GPIO_VREF(1.8v/3.3v_Input)), Module1.84 (+3.3v_(Output)), Module1.86 (+3.3v_(Output)), P1.2, R43.2, R44.2, R46.2, R47.2, R48.1, R49.2, R50.1, R53.1, R54.1, U8.5 (VIN), U11.1 (VCC), U13.5 (VDDA33), U13.10 (VDDA33), U13.15 (VDD33), U13.23 (VDD33), U13.27 (VBUS_DET), U13.29 (VDDA33), U13.36 (VDDA33), U14.1 (PDN), U14.2 (3.3V)
+5V: C16.1, C17.1, C21.1, C25.1, D1.2 (A), D4.1 (K), JP1.1 (A), LED11.2 (A), Module1.77 (+5v_(Input)), Module1.79 (+5v_(Input)), Module1.81 (+5v_(Input)), Module1.83 (+5v_(Input)), Module1.85 (+5v_(Input)), Module1.87 (+5v_(Input)), R4.1, R40.1, R41.1, R52.2, TP6.1, U5.8 (VCC), U9.5 (VIN), U12.5 (VIN)
/AC_IN: C39.1, D2.2 (A), J6.A4/B9 (Power), J6.B4/A9 (Power), R1.2, R3.1, TP1.1, U2.32 (AC_IN), U2.33 (AC_IN)
/Batteries/BT1-: BT1.2 (-), Q4.1 (G), Q5.6 (S2), Q5.7 (S2), R7.1, R9.1, R10.2, R12.2
/Batteries/BT2-: BT2.2 (-), Q8.1 (G), Q9.6 (S2), Q9.7 (S2), R16.1, R17.2, R19.2
/Batteries/BT3-: BT3.2 (-), Q12.1 (G), Q13.6 (S2), Q13.7 (S2), R23.1, R24.2, R26.2
/Batteries/BT4-: BT4.2 (-), Q16.1 (G), Q17.6 (S2), Q17.7 (S2), R30.1, R31.2, R32.2
/Battery/ADC2: R1.1, R2.1, U1.25 (PC2)
/Battery/BATT+: BT1.1 (+), BT2.1 (+), BT3.1 (+), BT4.1 (+), C1.1, LED2.1 (K), LED4.1 (K), LED6.1 (K), LED8.1 (K), Q4.2 (S), Q8.2 (S), Q12.2 (S), Q16.2 (S), R5.1, R9.2, R14.1, R16.2, R21.1, R23.2, R28.1, R30.2, R34.1, TP3.1, U2.38 (Batt), U2.39 (Batt), U2.42 (BatSense)
/Battery/BT1_PRES: Q2.2 (S), Q3.2 (S), Q4.3 (D), R6.1, U1.30 (PD0)
/Battery/BT2_PRES: Q6.2 (S), Q7.2 (S), Q8.3 (D), R13.1, U1.31 (PD1)
/Battery/BT3_PRES: Q10.2 (S), Q11.2 (S), Q12.3 (D), R20.1, U1.32 (PD2)
/Battery/BT4_PRES: Q14.2 (S), Q15.2 (S), Q16.3 (D), R27.1, U1.1 (PD3)
/Battery/I2C_SCL: Module1.80 (SCL0), P1.3, R44.1, U1.28 (PC5), U2.2 (SCK), U5.6 (SCL)
/Battery/I2C_SDA: Module1.82 (SDA0), P1.4, R43.1, U1.27 (PC4), U2.1 (SDA), U5.5 (SDA)
/Battery/MISO: Module1.40 (GPIO9), U1.16 (PB4)
/Battery/MOSI: Module1.44 (GPIO10), U1.15 (PB3)
/Battery/SCL: Module1.38 (GPIO11), U1.17 (PB5)
/Battery//BT1_ENA: Q2.1 (G), Q3.1 (G), R7.2, U1.19 (PA0)
/Battery//BT2_ENA: Q6.1 (G), Q7.1 (G), R14.2, U1.22 (PA1)
/Battery//BT3_ENA: Q10.1 (G), Q11.1 (G), R21.2, U1.3 (PA2)
/Battery//BT4_ENA: Q14.1 (G), Q15.1 (G), R28.2, U1.6 (PA3)
/Battery//RESET: Module1.46 (GPIO22), U1.29 (~RESET/PC6)
/CM4_GPIO/+1.8v: Module1.88 (+1.8v_(Output)), Module1.90 (+1.8v_(Output))
/CM4_GPIO/EXT_ENA: D3.2 (A), R50.2, R51.2, U2.20 (EXTEN)
/CM4_GPIO/GPIO6: LED12.1 (K), Module1.30 (GPIO6)
/CM4_GPIO/GPIO_IRQ: C19.1, Module1.51 (GPIO15), R51.1
/CM4_GPIO/GPIO_PB1: D5.2 (A), Module1.56 (GPIO3), R46.1
/CM4_GPIO/GPIO_PB2: Module1.54 (GPIO4), PB2.1, R47.1
/CM4_GPIO/PI_nLED_Activity: Module1.21 (PI_nLED_Activity), R45.1
/CM4_GPIO/PowerSwitch: D5.1 (K), PB1.1, U2.47 (PwrON)
/CM4_GPIO/SD_CLK: J1.5 (CLK), Module1.57 (SD_CLK)
/CM4_GPIO/SD_CMD: J1.3 (CMD), Module1.62 (SD_CMD)
/CM4_GPIO/SD_DAT0: J1.7 (DAT0), Module1.63 (SD_DAT0)
/CM4_GPIO/SD_DAT1: J1.8 (DAT1), Module1.67 (SD_DAT1)
/CM4_GPIO/SD_DAT2: J1.1 (DAT2), Module1.69 (SD_DAT2)
/CM4_GPIO/SD_DAT3: J1.2 (DAT3/CD), Module1.61 (SD_DAT3)
/CM4_GPIO/SD_PWR: C20.1, J1.4 (VDD), U8.1 (VOUT)
/CM4_GPIO/SD_PWR_ON: Module1.75 (SD_PWR_ON), R49.1, U8.4 (EN)
/CM4_GPIO/TRD0_N: Module1.10 (Ethernet_Pair0_N), U7.4 (D2+), U7.7
/CM4_GPIO/TRD0_P: Module1.12 (Ethernet_Pair0_P), U7.5 (D2-), U7.6
/CM4_GPIO/TRD1_N: Module1.6 (Ethernet_Pair1_N), U7.2 (D1-), U7.9
/CM4_GPIO/TRD1_P: Module1.4 (Ethernet_Pair1_P), U7.1 (D1+), U7.10
/CM4_GPIO/TRD2_N: Module1.9 (Ethernet_Pair2_N), U6.4 (D2+), U6.7
/CM4_GPIO/TRD2_P: Module1.11 (Ethernet_Pair2_P), U6.5 (D2-), U6.6
/CM4_GPIO/TRD3_N: Module1.5 (Ethernet_Pair3_N), U6.2 (D1-), U6.9
/CM4_GPIO/TRD3_P: Module1.3 (Ethernet_Pair3_P), U6.1 (D1+), U6.10
/CM4_HighSpeed/HDMI0_CEC: J2.13 (CEC), Module1.151 (HDMI0_CEC)
/CM4_HighSpeed/HDMI0_CK_N: J2.12 (CK-), Module1.190 (HDMI0_CLK_N)
/CM4_HighSpeed/HDMI0_CK_P: J2.10 (CK+), Module1.188 (HDMI0_CLK_P)
/CM4_HighSpeed/HDMI0_D0_N: J2.9 (D0-), Module1.184 (HDMI0_TX0_N)
/CM4_HighSpeed/HDMI0_D0_P: J2.7 (D0+), Module1.182 (HDMI0_TX0_P)
/CM4_HighSpeed/HDMI0_D1_N: J2.6 (D1-), Module1.178 (HDMI0_TX1_N)
/CM4_HighSpeed/HDMI0_D1_P: J2.4 (D1+), Module1.176 (HDMI0_TX1_P)
/CM4_HighSpeed/HDMI0_D2_N: J2.3 (D2-), Module1.172 (HDMI0_TX2_N)
/CM4_HighSpeed/HDMI0_D2_P: J2.1 (D2+), Module1.170 (HDMI0_TX2_P)
/CM4_HighSpeed/HDMI0_HOTPLUG: J2.19 (HPD/HEAC-), Module1.153 (HDMI0_HOTPLUG)
/CM4_HighSpeed/HDMI0_SCL: J2.15 (SCL), Module1.200 (HDMI0_SCL)
/CM4_HighSpeed/HDMI0_SDA: J2.16 (SDA), Module1.199 (HDMI0_SDA)
/CM4_HighSpeed/HDMI_5v: C22.1, J2.18 (+5V), U9.1 (VOUT)
/CM4_HighSpeed/USB2_N: Module1.103 (USB2_N), U11.4 (D_N)
/CM4_HighSpeed/USB2_P: Module1.105 (USB2_P), U11.3 (D_P)
/CM4_HighSpeed/USBOTG_ID: Module1.101 (USB_OTG_ID), Q18.3 (D), R54.2, U11.2 (SEL)
/Charger/IPS_OUT: C3.1, C4.1, R35.2, R38.1, TP4.1, U2.13 (LDO_24_In), U2.21 (APS), U2.34 (IPS_Out), U2.35 (IPS_Out), U2.40 (LDO_3_In), U2.44 (Vin_1), U3.1 (Vin)
/Power/IPS_SW: C11.1, C12.1, L2.1, TP5.1, U3.5 (Vout), U4.1 (ONA)
/USB Hub/HD1_N: J4.2, U10.5 (D2-), U10.6, U13.1 (USBDM_DN1/PRT_DIS_M1)
/USB Hub/HD1_P: J4.3, U10.4 (D2+), U10.7, U13.2 (USBDP_DN1/PRT_DIS_P1)
/USB Hub/HD2_N: U13.3 (USBDM_DN2/PRT_DIS_M2), U14.3 (DM-)
/USB Hub/HD2_P: U13.4 (USBDP_DN2/PRT_DIS_P2), U14.4 (DP+)
/USB Hub/HD3_N: J5.2 (D-), U13.6 (USBDM_DN3/PRT_DIS_M3)
/USB Hub/HD3_P: J5.3 (D+), U13.7 (USBDP_DN3/PRT_DIS_P3)
/USB Hub/HD4_N: J3.2 (D-), U13.8 (USBDM_DN4/PRT_DIS_M4)
/USB Hub/HD4_P: J3.3 (D+), U13.9 (USBDP_DN4/PRT_DIS_P4)
/USB Hub/OTG_D+: J6.A6 (D+), J6.B6 (D+), U10.1 (D1+), U10.10, U11.9 (HSD1_P)
/USB Hub/OTG_D-: J6.A7 (D-), J6.B7 (D-), U10.2 (D1-), U10.9, U11.8 (HSD1_M)
/USB Hub/OTG_ID: J6.A5 (CC1), J6.B5 (CC2), R55.2
/USB Hub/PWR1: U12.4 (EN), U13.12 (PRTPWR1/BC_EN1)
/USB Hub/USBH_N: U11.6 (HSD0_M), U13.30 (USBDM_UP)
/USB Hub/USBH_P: U11.7 (HSD0_P), U13.31 (USBDP_UP)
/USB Hub/VBUS: C30.1, C32.1, C34.1, C36.1, C38.1, J3.1 (VBUS), J4.1, J5.1 (VBUS), U12.1 (VOUT)
/USB Hub/nEXTRST: Module1.100 (nEXTRST), U13.26 (RESET_N)
/USB Hub/nOCS1: U12.3 (/FLG), U13.13 (OCS_N1), U13.17 (OCS_N2), U13.19 (OCS_N3), U13.21 (OCS_N4)
GND: C4.2, C8.1, C9.1, C18.2, C19.2, C20.2, C21.2, C22.2, C23.2, C24.2, C25.2, C26.2, C27.2, C28.2, C29.2, C30.2, C31.2, C32.2, C33.2, C34.2, C35.2, C36.2, C37.2, C38.2, C39.2, C40.2, J1.6 (VSS), J2.2 (D2S), J2.5 (D1S), J2.8 (D0S), J2.11 (CKS), J2.17 (GND), J2.SH1 (SH), J2.SH2 (SH), J2.SH3 (SH), J2.SH4 (SH), J3.4 (GND), J3.5 (Shield), J4.4, J5.4 (GND), J5.5 (Shield), J6.1 (Shell), J6.A1/B12 (GND), J6.B1/A12 (GND), L3.2, Module1.1 (GND), Module1.2 (GND), Module1.7 (GND), Module1.8 (GND), Module1.13 (GND), Module1.14 (GND), Module1.22 (GND), Module1.23 (GND), Module1.32 (GND), Module1.33 (GND), Module1.42 (GND), Module1.43 (GND), Module1.52 (GND), Module1.53 (GND), Module1.59 (GND), Module1.60 (GND), Module1.65 (GND), Module1.66 (GND), Module1.71 (GND), Module1.74 (GND), Module1.98 (GND), Module1.107 (GND), Module1.108 (GND), Module1.113 (GND), Module1.114 (GND), Module1.119 (GND), Module1.120 (GND), Module1.125 (GND), Module1.126 (GND), Module1.131 (GND), Module1.132 (GND), Module1.137 (GND), Module1.138 (GND), Module1.144 (GND), Module1.150 (GND), Module1.155 (GND), Module1.156 (GND), Module1.161 (GND), Module1.162 (GND), Module1.167 (GND), Module1.168 (GND), Module1.173 (GND), Module1.174 (GND), Module1.179 (GND), Module1.180 (GND), Module1.185 (GND), Module1.186 (GND), Module1.191 (GND), Module1.192 (GND), Module1.197 (GND), Module1.198 (GND), P1.1, PB1.2, PB2.2, Q18.2 (S), R37.1, R42.1, R56.2, R57.2, R58.2, R59.1, R60.2, U2.22 (A_Gnd), U5.1 (A0), U5.2 (A1), U5.3 (A2), U5.4 (GND), U6.3 (GND), U6.8 (GND), U7.3 (GND), U7.8 (GND), U8.2 (GND), U9.2 (GND), U10.3 (GND), U10.8 (GND), U11.5 (GND), U11.10 (nOE), U12.2 (GND), U13.37 (VSS), U14.5 (GND), U14.7 (GND), U14.9 (GND), U14.10 (GND), U14.12 (GND), U14.13 (GND), U14.14 (GND), U14.15 (GND)
unnamed: C2.1, L1.1, R34.2, U2.43 (ChgSense)
unnamed: C5.2, U2.12 (LDO_2)
unnamed: C6.2, U2.11 (LDO_4)
unnamed: C7.2, U2.41 (LDO_3)
unnamed: C8.2, U2.26 (V_Internal), U2.27 (LDO_1_Set)
unnamed: C9.2, U2.24 (V_Ref)
unnamed: C10.1, D3.1 (K), R39.1, U3.3 (ENA)
unnamed: C13.1, U4.6 (SS/LIM)
unnamed: C14.1, U4.7 (REF)
unnamed: C15.1, R40.2, U4.9 (OUT), U4.14 (_3.3/5), U4.15 (CLK)
unnamed: C23.1, U13.33 (XTALIN/CLKIN), Y1.1
unnamed: C24.1, U13.32 (XTALOUT), Y1.2
unnamed: D1.1 (K), D2.1 (K), U1.4 (VCC), U1.18 (AVCC)
unnamed: D4.2 (A), L2.2, U4.2 (LX), U4.3 (LX), U4.4 (LX)
unnamed: JP1.2 (B), R42.2, U5.7 (WP)
unnamed: L1.2, U2.45 (LX1)
unnamed: LED1.1 (K), LED3.1 (K), LED5.1 (K), LED7.1 (K), Q1.3 (D), R5.2, U1.5 (GND), U1.21 (GND)
unnamed: LED1.2 (A), R8.2
unnamed: LED2.2 (A), R12.1
unnamed: LED3.2 (A), R15.2
unnamed: LED4.2 (A), R19.1
unnamed: LED5.2 (A), R22.2
unnamed: LED6.2 (A), R26.1
unnamed: LED7.2 (A), R29.2
unnamed: LED8.2 (A), R31.1
unnamed: LED9.1 (K), U2.36 (ChgLED)
unnamed: LED9.2 (A), R38.2
unnamed: LED10.2 (A), R41.2
unnamed: LED11.1 (K), R45.2
unnamed: LED12.2 (A), R48.2
unnamed: Q1.1 (G), R3.2, R4.2
unnamed: Q2.3 (D), Q5.4 (G1), R8.1, R11.1
unnamed: Q3.3 (D), Q5.5 (G2), R10.1
unnamed: Q6.3 (D), Q9.4 (G1), R15.1, R18.1
unnamed: Q7.3 (D), Q9.5 (G2), R17.1
unnamed: Q10.3 (D), Q13.4 (G1), R22.1, R25.1
unnamed: Q11.3 (D), Q13.5 (G2), R24.1
unnamed: Q14.3 (D), Q17.4 (G1), R29.1, R33.1
unnamed: Q15.3 (D), Q17.5 (G2), R32.1
unnamed: Q18.1 (G), R53.2, R55.1
unnamed: R35.1, U2.6 (N_VBus_En)
unnamed: R36.1, U2.37 (TS)
unnamed: R37.2, U2.23 (Bias)
unnamed: R52.1, U9.4 (EN)
unnamed: R56.1, U13.24 (SCL/SMBCLK/CFG_SEL0)
unnamed: R57.1, U13.22 (SDA/SMBDATA/NON_REM1)
unnamed: R58.1, U13.28 (SUSP_IND/LOCAL_PWR/NON_REM0)
unnamed: R59.2, U13.35 (RBIAS)
unnamed: R60.1, U13.25 (HS_IND/CFG_SEL1)
PWR_GND: C1.2, C2.2, C3.2, C5.1, C6.1, C7.1, C10.2, C11.2, C12.2, C13.2, C14.2, C15.2, C16.2, C17.2, L3.1, LED10.1 (K), Q1.2 (S), Q5.2 (S1), Q5.3 (S1), Q9.2 (S1), Q9.3 (S1), Q13.2 (S1), Q13.3 (S1), Q17.2 (S1), Q17.3 (S1), R2.2, R6.2, R11.2, R13.2, R18.2, R20.2, R25.2, R27.2, R33.2, R36.2, R39.2, TP2.1, U2.4 (N_OE), U2.9 (PGnd_2), U2.16 (PGnd_3), U2.46 (PGnd_1), U2.49 (GND_PAD), U3.2 (GND), U4.5 (GND), U4.8 (GND), U4.10 (FB), U4.11 (PGND), U4.12 (PGND), U4.13 (PGND)
