ConnectBox/Circuit-Design/(commit log)

2018-07-31 New Circuit Folder 4.7
    [NanoPi_Neo_Daughterboard-Ver4-B.Cu.gbr, NanoPi_Neo_Daughterboard-Ver4-B.Mask.gbr, NanoPi_Neo_Daughterboard-Ver4-B.Paste.gbr, NanoPi_Neo_Daughterboard-Ver4-B.SilkS.gbr, NanoPi_Neo_Daughterboard-Ver4-Cmts.User.gbr, NanoPi_Neo_Daughterboard-Ver4-Dwgs.User.gbr, NanoPi_Neo_Daughterboard-Ver4-Edge.Cuts.gbr, NanoPi_Neo_Daughterboard-Ver4-F.Cu.gbr]
2018-07-31 Fix Commit
    [NanoPi_Neo_Daughterboard-Ver4-B.Cu.gbr, NanoPi_Neo_Daughterboard-Ver4-B.Mask.gbr, NanoPi_Neo_Daughterboard-Ver4-B.Paste.gbr, NanoPi_Neo_Daughterboard-Ver4-B.SilkS.gbr, NanoPi_Neo_Daughterboard-Ver4-Cmts.User.gbr, NanoPi_Neo_Daughterboard-Ver4-Dwgs.User.gbr, NanoPi_Neo_Daughterboard-Ver4-Edge.Cuts.gbr, NanoPi_Neo_Daughterboard-Ver4-F.Cu.gbr]
2018-07-31 Updated 4.7 Hat
    [NanoPi_Neo_Daughterboard-Ver4-B.Cu.gbr, NanoPi_Neo_Daughterboard-Ver4-B.Mask.gbr, NanoPi_Neo_Daughterboard-Ver4-B.Paste.gbr, NanoPi_Neo_Daughterboard-Ver4-B.SilkS.gbr, NanoPi_Neo_Daughterboard-Ver4-Cmts.User.gbr, NanoPi_Neo_Daughterboard-Ver4-Dwgs.User.gbr, NanoPi_Neo_Daughterboard-Ver4-Edge.Cuts.gbr, NanoPi_Neo_Daughterboard-Ver4-F.Cu.gbr]
2018-07-31 Completed upload of design
    [NanoPi_Neo_Daughterboard-Ver4.7.1.kicad_pcb, NanoPi_Neo_Daughterboard-Ver4.7.1.sch, NanoPi_Neo_Daughterboard-Ver4.7.kicad_pcb, NanoPi_Neo_Daughterboard-Ver4.kicad_pcb, NanoPi_Neo_Daughterboard-Ver4.sch]
2019-10-29 Updated Latest Versions
    Version 5.1.1
    Version 6.0.1
    [CB_ver_6.0.1_BOM.xlsx, HAT_ver_5.1 copy.sch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]
2019-11-23 New revision for injection molded case
    [CB with HAT_ver_6.0.4_BOM.xlsx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]
2020-02-10 Updated Circuit board based on molded case design
    [CB with HAT_ver_6.0.4_BOM.xlsx]
2021-07-24 Added new hat with flex for MegaVoice
    [BatteryModule.kicad_sch, BatteryPack.kicad_sch, HAT_CM4-CM4-GPIO.kicad_sch, HAT_CM4-CM4-HS.kicad_sch, HAT_CM4-Charge.kicad_sch, HAT_CM4-Charge_Concept.kicad_sch, HAT_CM4-Notes.kicad_sch, HAT_CM4-Power.kicad_sch]
2022-04-12 Hat Changes including Version 2.0
    [BatteryModule.kicad_sch, CM4-Batteries.kicad_sch, CM4_BattBoard-Battery.kicad_sch, HAT_CM4 base.kicad_pcb, HAT_CM4-CM4-GPIO.kicad_sch, HAT_CM4-CM4-HS.kicad_sch, HAT_CM4-Charge.kicad_sch, HAT_CM4-Notes.kicad_sch]
2022-04-14 Updated to second protype release
    [BatteryModule.kicad_sch, CM4-Batteries.kicad_sch, CM4_BattBoard-Battery.kicad_sch, HAT_CM4 base.kicad_pcb, HAT_CM4-CM4-GPIO.kicad_sch, HAT_CM4-CM4-HS.kicad_sch, HAT_CM4-Charge.kicad_sch, HAT_CM4-Notes.kicad_sch]
2022-04-14 Updated to 183 release which fixes some traces to close to cutouts
    [BatteryModule.kicad_sch, CM4-Batteries.kicad_sch, CM4_BattBoard-Battery.kicad_sch, HAT_CM4 base.kicad_pcb, HAT_CM4-CM4-GPIO.kicad_sch, HAT_CM4-CM4-HS.kicad_sch, HAT_CM4-Charge.kicad_sch, HAT_CM4-Notes.kicad_sch]
2022-11-26 Rename KiCad 7.0.6 folder for consistency
    [BatteryModule.kicad_sch, BatteryPack.kicad_sch, HAT_CM4-CM4-GPIO.kicad_sch, HAT_CM4-CM4-HS.kicad_sch, HAT_CM4-Charge.kicad_sch, HAT_CM4-Charge_Concept.kicad_sch, HAT_CM4-Notes.kicad_sch, HAT_CM4-Power.kicad_sch]
2022-11-26 Initial release of CB-CM4 circuit documents
    [BatteryModule.kicad_sch, BatteryModuleNotes.kicad_sch, CM4-Batteries.kicad_sch, CM4_BattBoard-Battery.kicad_sch, CM4_BattBoard-Charge.kicad_sch, CM4_BattBoard-Power.kicad_sch, CM4_BattBoard.kicad_pcb, CM4_BattBoard.kicad_sch]
2023-06-06 Updated hat schematics
    [BatteryModule.kicad_sch, BatteryModuleNotes.kicad_sch, CM4-Batteries.kicad_sch, CM4_BattBoard-Battery.kicad_sch, CM4_BattBoard-Charge.kicad_sch, CM4_BattBoard-Power.kicad_sch, CM4_BattBoard.kicad_pcb, CM4_BattBoard.kicad_sch]
2025-01-07 Added Model R Design Files
    Circuit Design Files for Model R
    [HATA_ver_8.3.1-B_Cu.gbr, HATA_ver_8.3.1-B_Mask.gbr, HATA_ver_8.3.1-B_Paste.gbr, HATA_ver_8.3.1-B_Silkscreen.gbr, HATA_ver_8.3.1-Edge_Cuts.gbr, HATA_ver_8.3.1-F_Cu.gbr, HATA_ver_8.3.1-F_Mask.gbr, HATA_ver_8.3.1-F_Paste.gbr]
2025-03-09 Version 8.3.1 for removable battery design
