ConnectBox/Circuit-Design/(notices)

Notices in the files:
Hat_6.0.4/HAT_ver_6.0.kicad_pcb:
Copyright 2019
Hat_4.7/NanoPi_Neo_Daughterboard-Ver4.7.kicad_pcb:
Copyright 2018, ConnectBox Project
Hat_7.0.6/HAT_ver_7.0.6/HAT_ver_7.kicad_pcb:
Copyright 2021
Hat 2.0/HAT_CM4_183_041022-V2.1/HAT_CM4_183.kicad_pcb:
ConnectBox RPi (c)2022
(c) 2022
Hat 8.3.1/HATA_ver_8.3.1/HATA_ver_8.3.1.kicad_pcb:
(c)2023
